julioamerico/blackfin-ip-phone-hw/implementação/doc/PCB Top Layer.jpg

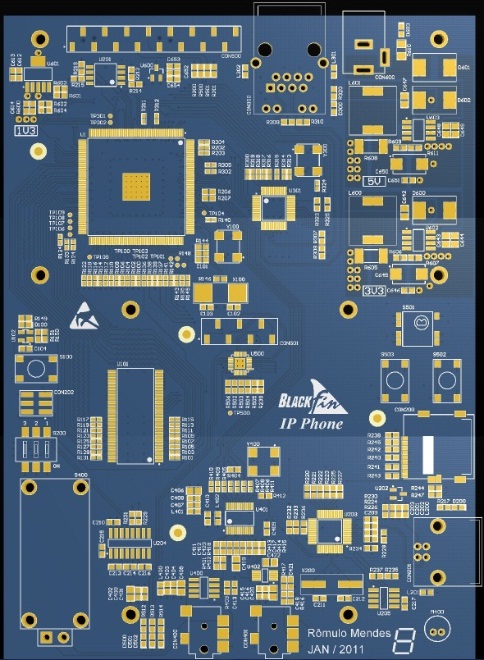
implementação/doc/PCB Top Layer.jpg
