julioamerico/blackfin-ip-phone-hw/implementação/doc/wiki/images/placa.png

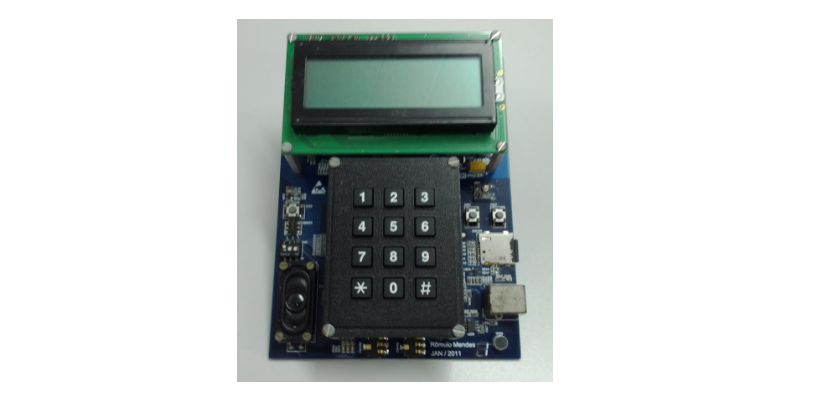
implementação/doc/wiki/images/placa.png
