julioamerico/blackfin-ip-phone-hw/pesquisa/crystals and oscillators/CSX750FBC-16.384M-UT.pdf

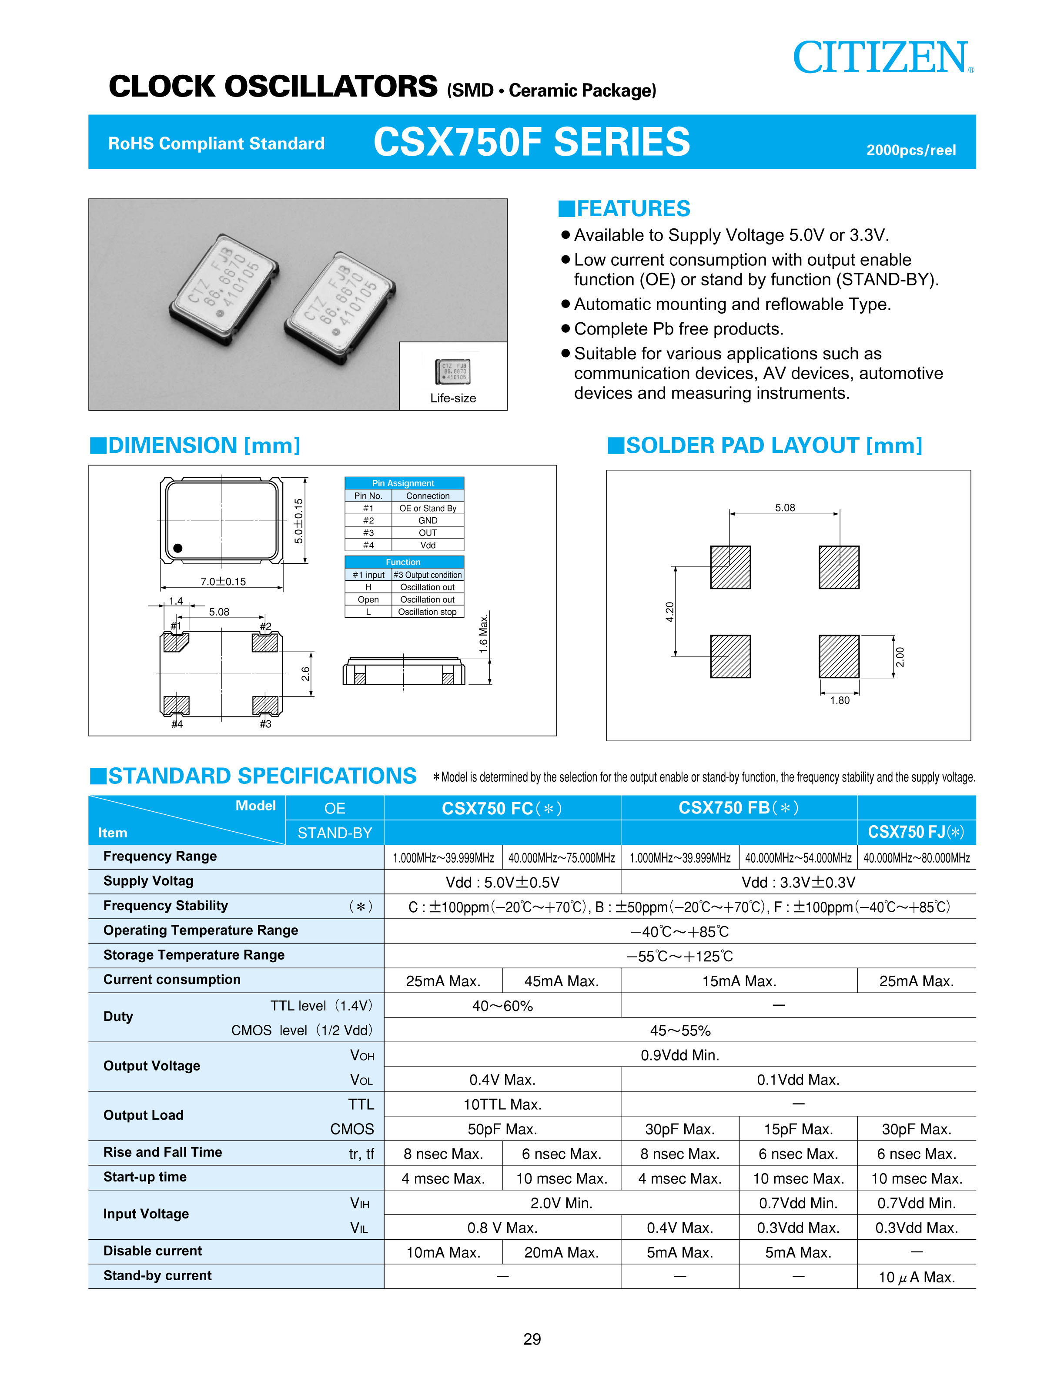
[picture p17: page 1]
