julioamerico/blackfin-ip-phone-hw/arquitetura/diagrama de blocos (texas instruments).jpg

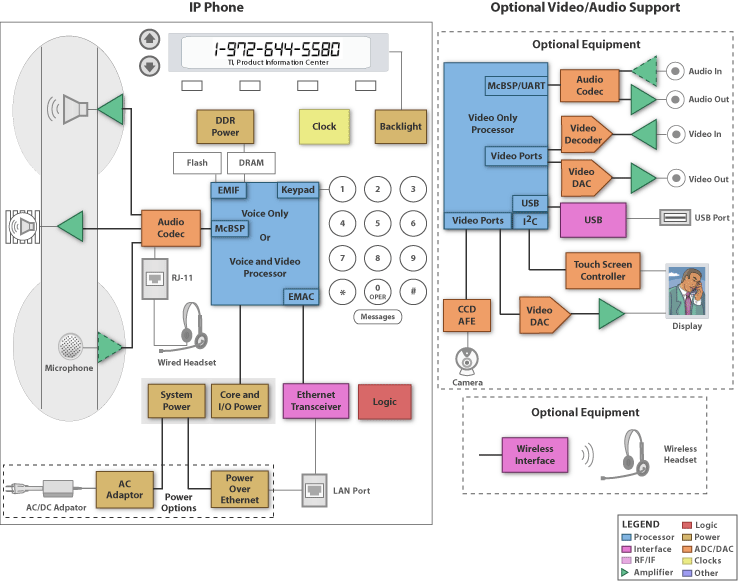
arquitetura/diagrama de blocos (texas instruments).jpg
