julioamerico/blackfin-ip-phone-hw/implementação/doc/Relatório de Fabricação das Placas/1-4 - Final Inspection Report.jpg

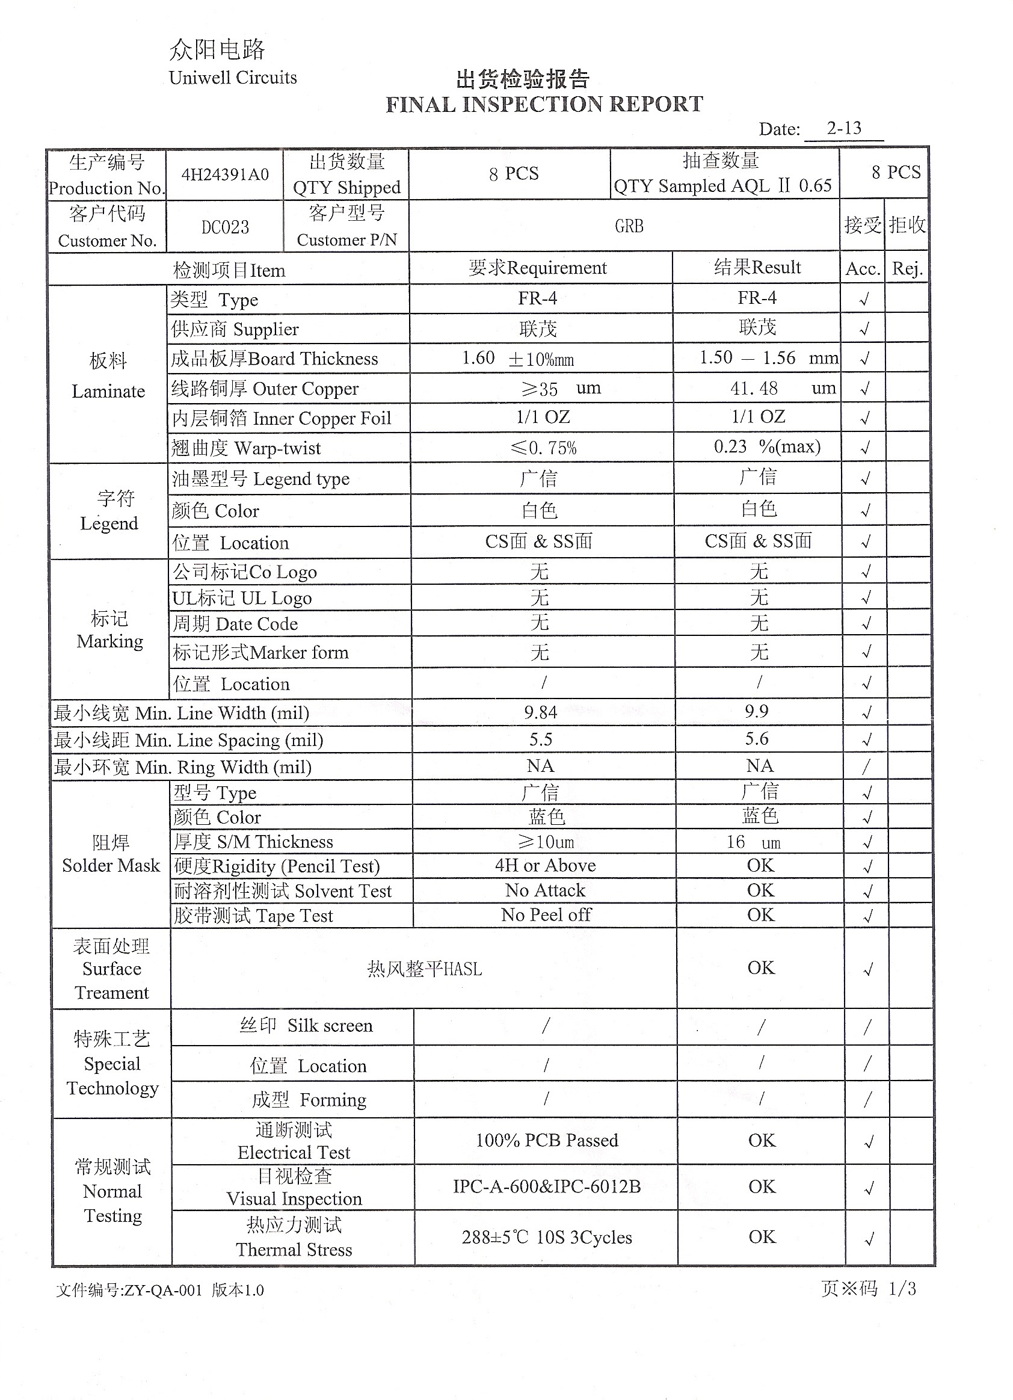
implementação/doc/Relatório de Fabricação das Placas/1-4 - Final Inspection Report.jpg
