julioamerico/blackfin-ip-phone-hw/implementação/doc/Relatório de Fabricação das Placas/4-4 - Microsection Analysis Report.jpg

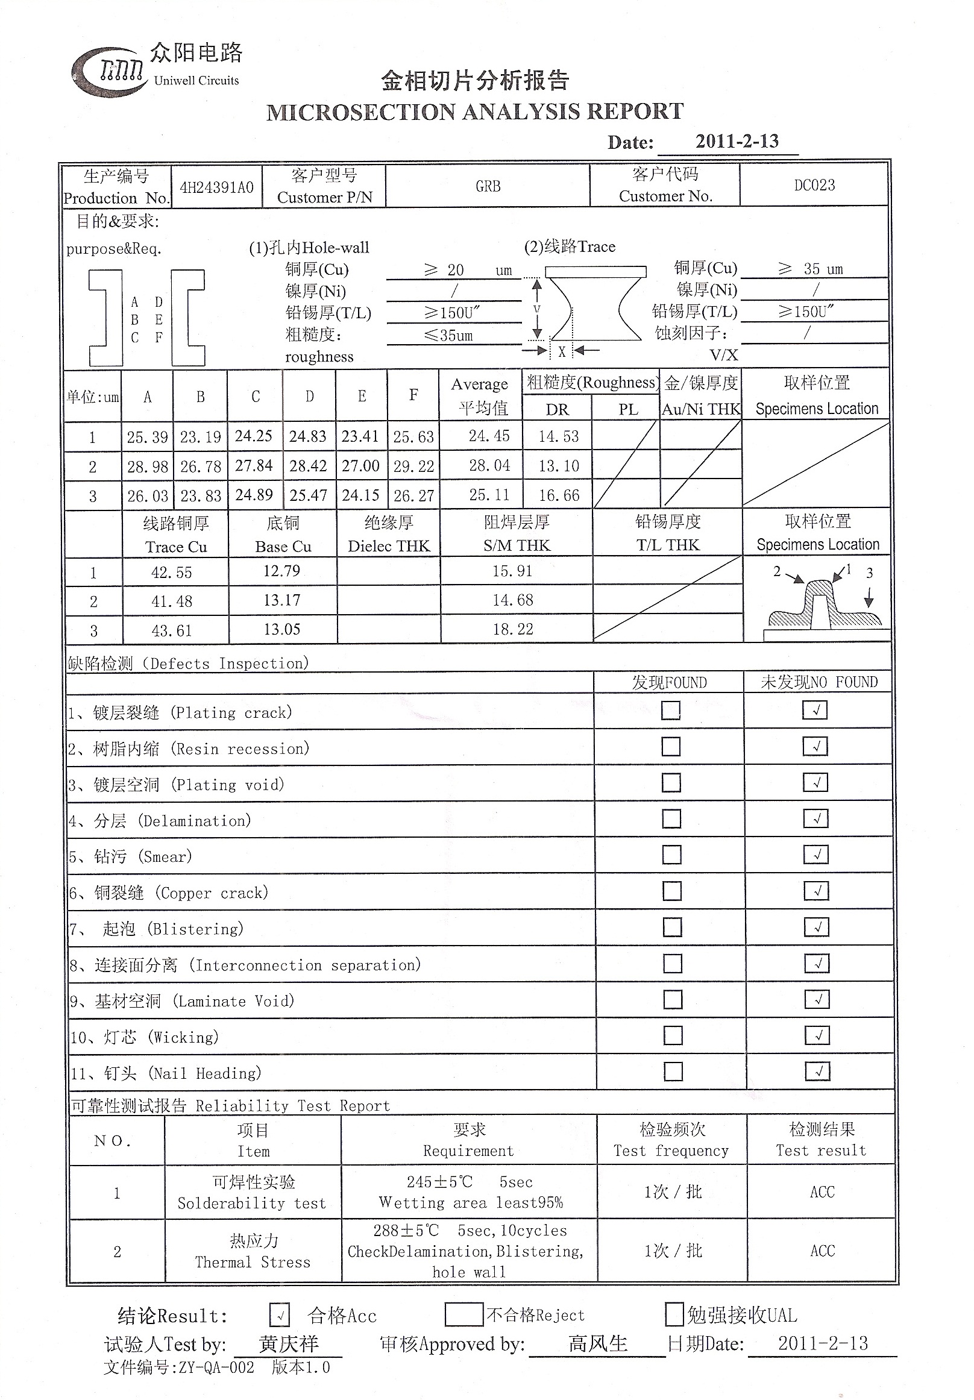
implementação/doc/Relatório de Fabricação das Placas/4-4 - Microsection Analysis Report.jpg
