julioamerico/blackfin-ip-phone-hw/implementação/doc/wiki/images/arquitetura_fw.png

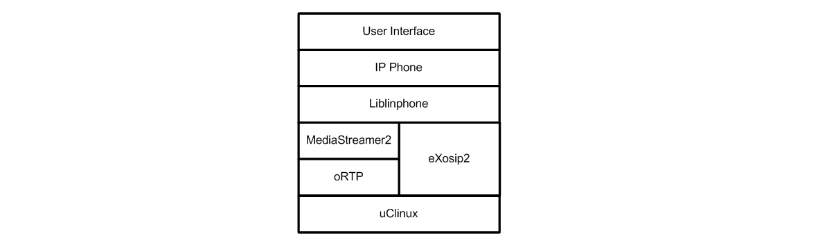
implementação/doc/wiki/images/arquitetura_fw.png
