julioamerico/blackfin-ip-phone-hw/implementação/doc/wiki/images/arquitetura_hw.png

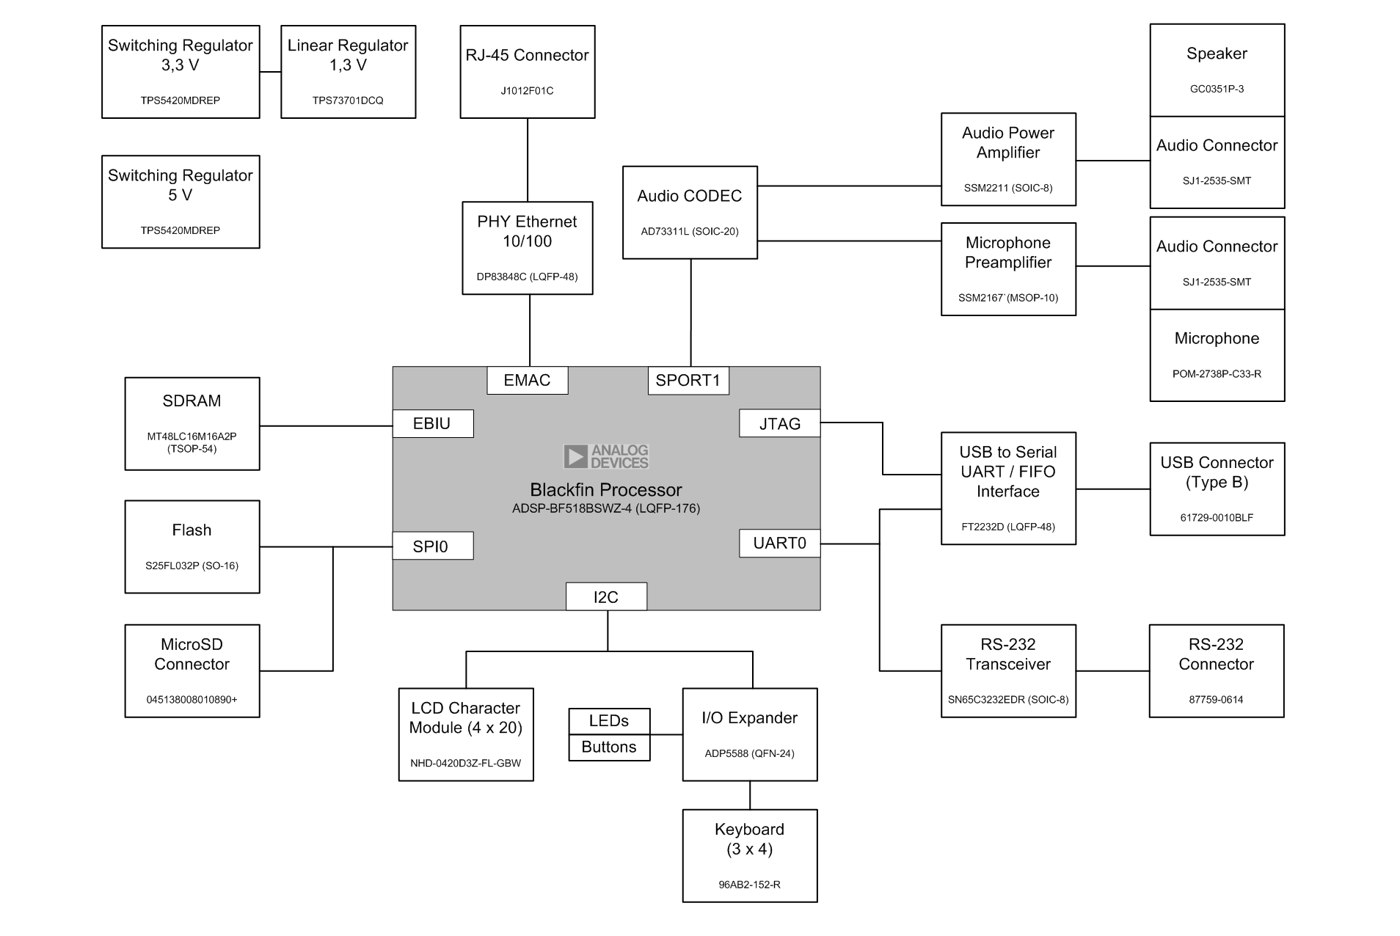
implementação/doc/wiki/images/arquitetura_hw.png
