julioamerico/blackfin-ip-phone-hw/implementação/bom/bom_fields.txt

A BOM deve conter os seguintes campos que associam o sch ao template:

- Comment       (*)
- Designator
- eVendor
- eVendorPart#
- eVendorPrice
- Footprint     (*)
- Manufacturer
- MOQ
- MSRP
- Part#         (*)
- Quantity

(*) Componentes devem ser diferenciados por esses campos.
