julioamerico/blackfin-ip-phone-hw/implementação/bom/blackfin_bom.xls

 | Lista de Materiais |  | BLACKFIN IP PHONE |  | V1
 | Universidade Federal do Ceará |  | Responsável: | Rômulo Mendes | 1 Placa ($): | 223.96
 | Centro de Tecnologia |  | Documento gerado em: | 2010-11-15 | 1000 Placas ($) | 140.29
 | Dep. de Engenharia Elétrica |  |  |  | Itens por Placa | 382
 | Dep. De Engenharia de Teleinformática
# | Part# | Comment | Footprint | Manufacturer | Designator | eVendorPart# | Quantity | MSRP | Total MSRP | eVendor | eVendorPrice | Total Vendor | MOQ
1 | PSAA18U-090-R | AC_Adapter | NÃO SE APLICA | Phihong | AC600 | 552-PSA-A18U-090 | 1 | 14,27 | 14.27 | Mouser | 17,73 | 17.73 | 1000
2 | 6009.1315 | Power_Cord | NÃO SE APLICA | Schurter | AC601 | 693-6009.1315 | 1 | 4,77 | 4.77 | Mouser | 6,74 | 6.74 | 1000
3 | NÃO SE APLICA | Board | NÃO SE APLICA | NÃO SE APLICA | B500 | NÃO SE APLICA | 1 | 0,00 | 0.00 | NÃO SE APLICA | 0,00 | 0.00 | 1000
4 | SJ-5003 (BLACK) | Board Foot | Board Foot (Hemisphere) | 3M Electronic Specialty | BF500, BF501, BF502, BF503 | 517-SJ-5003BK | 4 | 0,07 | 0.28 | Mouser | 0,18 | 0.72 | 1000
5 | VJ0603Y103KXAPW1BC | 10nF | C_0603 | Vishay/Vitramon | C100, C104, C105, C106, C107, C108, C109, C110, C111, C200, C205, C313, C414, C606, C607, C608, C609, C610, C611, C619, C620, C621, C622, C623, C624, C630, C631, C632, C633, C634, C635, C636 | 77-VJ0603Y103KXAPBC | 32 | 0,013 | 0.42 | Mouser | 0,05 | 1.60 | 1000
6 | GRM188R72A221KA01D | 220pF | C_0603 | Murata | C101 | 81-GRM18R72A221KA01D | 1 | 0,012 | 0.01 | Mouser | 0,05 | 0.05 | 1000
7 | 06035A220JAT2A | 22pF | C_0603 | AVX | C102, C103, C211, C212 | 581-06035A220J | 4 | 0,018 | 0.07 | Mouser | 0,03 | 0.12 | 1000
8 | GRM188F51E105ZA12D | 1uF | C_0603 | Murata | C201, C303, C401, C404, C409, C411, C412, C416, C612, C614, C652 | 81-GRM188F51E105ZA12 | 11 | 0,016 | 0.18 | Mouser | 0,07 | 0.77 | 1000
9 | GRM188R71E104KA01J | 100nF | C_0603 | Murata | C202, C206, C207, C208, C210, C213, C214, C215, C216, C217, C218, C301, C302, C304, C306, C307, C308, C309, C310, C311, C312, C400, C403, C407, C408, C410, C413, C415, C417, C418, C602, C603, C604, C605, C613, C617, C618, C626, C627, C628, C629, C638, C639, C640, C641, C646, C651, C653 | 81-GRM188R71E104KA01 | 48 | 0,11 | 5.28 | Mouser | 0,14 | 6.72 | 1000
10 | GRM188F51A225ZE01D | 2,2uF | C_0603 | Murata | C203, C654 | 81-GRM188F51A225ZE01 | 2 | 0,024 | 0.05 | Mouser | 0,11 | 0.22 | 1000
11 | C2012Y5V1C106Z | 10uF | C_0805 | TDK | C204, C300, C402, C405, C406, C419, C420, C422, C600, C601, C615, C616, C625, C637 | 810-C2012Y5V1C106Z | 14 | 0,05 | 0.70 | Mouser | 0,10 | 1.40 | 1000
12 | GRM188B11E333KA01D | 33nF | C_0603 | Murata | C209 | 81-GRM18B11E333KA01D | 1 | 0,013 | 0.01 | Mouser | 0,07 | 0.07 | 1000
13 | B45196H3106K109V17 | 10uF | C_Case_A | Kemet | C305 | 80-B45196H3106K109 | 1 | 0,06 | 0.06 | Mouser | 0,13 | 0.13 | 1000
14 | GRM1885C2A102JA01D | 1nF | C_0603 | Murata | C421 | 81-GRM1885C2A102JA01 | 1 | 0,019 | 0.02 | Mouser | 0,08 | 0.08 | 1000
15 | GRM188R71H473KA61D | 47nF | C_0603 | Murata | C423 | 81-GRM188R71H473KA61 | 1 | 0,012 | 0.01 | Mouser | 0,07 | 0.07 | 1000
16 | GRM216R71H103JA01D | 10nF | C_0805 | Murata | C642, C647 | 81-GRM216R71H103JA1D | 2 | 0,026 | 0.05 | Mouser | 0,23 | 0.46 | 1000
17 | C2012X5R1C106M | 10uF | C_0805 | TDK | C643, C648 | 810-C2012X5R1C106M | 2 | 0,098 | 0.20 | Mouser | 0,16 | 0.32 | 1000
18 | GRM21BR61C475KA88L | 4,7uF | C_0805 | Murata | C644, C649 | 81-GRM21BR61C475KA8L | 2 | 0,076 | 0.15 | Mouser | 0,42 | 0.84 | 1000
19 | T520Y477M006ATE015 | 470uF | C_Case_Y | Kemet | C645, C650 | 80-T520Y477M6ATE15 | 2 | 1,92 | 3.84 | Mouser | 3,27 | 6.54 | 1000
20 | 61729-0010BLF | USB Connector | USB Connector | FCI | CON201 | 649-61729-0010BLF | 1 | 0,39 | 0.39 | Mouser | 0,58 | 0.58 | 1000
21 | 87759-0614 | RS-232_CONN | Header_2x3 | Molex | CON202 | 538-87759-0614 | 1 | 0,48 | 0.48 | Mouser | 0,62 | 0.62 | 1000
22 | J1012F01C | RJ-45 | RJ-45 | Pulse | CON300 | 673-J1012F01C | 1 | 3,86 | 3.86 | Mouser | 7,86 | 7.86 | 1000
23 | SJ1-2535-SMT | Phone_Jack | Phone_Jack | CUI Inc | CON400, CON401 | CP1-2535SJCT-ND | 2 | 0,415 | 0.83 | Digikey | 0,75 | 1.50 | 1000
24 | SSM-116-L-SV | LCD_Connector | SOCKET_1x16 | Samtec | CON500 | SSM-116-L-SV | 1 | 1,29 | 1.29 | Techso | 1,55 | 1.55 | 1000
25 | SSM-107-L-SV | Keypad_Connector | SOCKET_1x7 | Samtec | CON501 | SSM-107-L-SV | 1 | 0,729 | 0.73 | Techso | 0,881 | 0.88 | 1000
26 | 163-179PH-EX | Power_Jack | Power_Jack | Kobiconn | CON600 | 163-179PH-EX | 1 | 0,51 | 0.51 | Mouser | 0,87 | 0.87 | 1000
27 | QTLP600C2TR | LED | LED_0603 | Everlight | D100, D200, D500, D501, D502, D603 | 638-QTLP600C2TR | 6 | 0,083 | 0.50 | Mouser | 0,22 | 1.32 | 1000
28 | QTLP600C4TR | LED | LED_0603 | Everlight | D300 | 638-QTLP600C4 | 1 | 0,075 | 0.07 | Mouser | 0,02 | 0.02 | 1000
29 | MBRS330T3G | MBRS330T3G | Case_430 | ON Semiconductor | D600, D602 | 863-MBRS330T3G | 2 | 0,17 | 0.34 | Mouser | 0,37 | 0.74 | 1000
30 | MBRS330T3G | Schottky_Diode | Case_430 | ON Semiconductor | D601 | 863-MBRS330T3G | 1 | 0,17 | 0.17 | Mouser | 0,37 | 0.37 | 1000
31 | ESQ-107-34-L-S | Keypad_Header_1x7 |  | Samtec | KEYPAD_HEADER500 | ESQ-107-34-L-S | 1 | 0,756 | 0.76 | Techso | 0,916 | 0.92 | 1000
32 | MI0603L301R-10 | FBEAD | L_0603 | Laird Technologies | L200, L201, L300, L301, L302, L400, L401, L402 | 875-MI0603L301R-10 | 8 | 0,066 | 0.53 | Mouser | 0,16 | 1.28 | 1000
33 | 744066220 | 22uH | Inductor_22uH | Wurth Electronics | L600, L601 | 710-744066220 | 2 | 0,95 | 1.90 | Mouser | 2,88 | 5.76 | 1000
34 | NHD-0420D3Z-FL-GBW | LCD | LCD | Newhaven | LCD500 | 763-0420D3Z-FL-GBW | 1 | 25,60 | 25.60 | Mouser | 31,75 | 31.75 | 1000
35 | DW-03-12-F-S-694 | LCD_Header_1x3 | NÃO SE APLICA | Samtec | LCD_HEADER500 | DW-03-12-F-S-694 | 1 | 0,144 | 0.14 | Techso | 0,173 | 0.17 | 1000
36 | DW-06-12-F-S-694 | LCD_Header_1x6 | NÃO SE APLICA | Samtec | LCD_HEADER501 | DW-06-12-F-S-694 | 1 | 0,287 | 0.29 | Techso | 0,347 | 0.35 | 1000
37 | DW-05-12-F-S-694 | LCD_Header_1x5 | NÃO SE APLICA | Samtec | LCD_HEADER502 | DW-05-12-F-S-694 | 1 | 0,239 | 0.24 | Techso | 0,289 | 0.29 | 1000
38 | CRCW08050000Z0EA | LCD_Resistor | NÃO SE APLICA | Vishay/Dale | LCD_RES500, LCD_RES501 | 71-CRCW0805-0-E3 | 2 | 0,008 | 0.02 | Mouser | 0,05 | 0.10 | 1000
39 | POM-2738P-C33-R | POM-2738P-C33-R | Microphone | PUI Audio | M400 | 665-POM2738PC33R | 1 | 1,13 | 1.13 | Mouser | 1,98 | 1.98 | 1000
40 | CRCW040222R0JNED | 22R | R_0402 | Vishay/Dale | R100, R101, R102, R103, R104, R105, R106, R107, R108, R109, R110, R111, R112, R113, R114, R115, R116, R117, R118, R119, R121, R122, R123, R124, R125, R127, R129, R131, R133, R134, R135, R136, R137, R138, R139, R141, R142, R143, R145, R405, R406, R407, R408, R409, R410 | 71-CRCW0402J-22-E3 | 45 | 0,01 | 0.45 | Mouser | 0,06 | 2.70 | 1000
41 | CRCW040233R0JNED | 33R | R_0402 | Vishay/Dale | R140, R202, R203, R324, R411 | 71-CRCW0402J-33-E3 | 5 | 0,01 | 0.05 | Mouser | 0,06 | 0.30 | 1000
42 | CRCW0603100KJNEA | 100K | R_0603 | Vishay/Dale | R144, R151, R418 | 71-CRCW0603J-100K-E3 | 3 | 0,01 | 0.03 | Mouser | 0,06 | 0.18 | 1000
43 | CR0603-FX-1005ELF | 10M | R_0603 | Bourns | R146 | 652-CR0603FX-1005ELF | 1 | 0,004 | 0.004 | Mouser | 0,05 | 0.05 | 1000
44 | CRCW060310K0FKEA | 10K | R_0603 | Vishay/Dale | R147, R150, R211, R212, R213, R214, R215, R219, R230, R235, R236, R238, R328, R413, R417, R507, R508, R509, R510, R511, R515, R516, R606, R609 | 71-CRCW0603-10K-E3 | 24 | 0,015 | 0.36 | Mouser | 0,06 | 1.44 | 1000
45 | CRCW060333K0JNEA | 33K | R_0603 | Vishay/Dale | R148 | 71-CRCW0603J-33K-E3 | 1 | 0,01 | 0.01 | Mouser | 0,06 | 0.06 | 1000
46 | CRCW0603100RFKEA | 100R | R_0603 | Vishay/Dale | R149, R512, R513, R514 | 71-CRCW0603-100-E3 | 4 | 0,015 | 0.06 | Mouser | 0,06 | 0.24 | 1000
47 | CRCW06031K20FKEA | 1K2 | R_0603 | Vishay/Dale | R200, R201 | 71-CRCW0603-1.2K-E3 | 2 | 0,015 | 0.03 | Mouser | 0,06 | 0.12 | 1000
48 | CRCW06030000Z0EB | 0R | R_0603 | Vishay/Dale | R206, R220, R221, R222, R223, R225, R227, R229, R231, R232, R233, R234, R323, R325, R326, R327, R404, R412, R500, R501, R502, R503, R504, R505, R506, R600, R601, R603 | 71-CRCW06030000Z0EB | 28 | 0,015 | 0.42 | Mouser | 0,06 | 1.68 | 1000
49 | CRCW06034K70JNEA | 4K7 | R_0603 | Vishay/Dale | R207, R208, R209, R210, R239 | 71-CRCW0603J-4.7K-E3 | 5 | 0,01 | 0.05 | Mouser | 0,06 | 0.30 | 1000
50 | CRCW0603470RFKEA | 470R | R_0603 | Vishay/Dale | R216 | 71-CRCW0603-470-E3 | 1 | 0,015 | 0.01 | Mouser | 0,06 | 0.06 | 1000
51 | CRCW0603150RJNEB | 150R | R_0603 | Vishay/Dale | R217 | 71-CRCW0603150RJNEB | 1 | 0,01 | 0.01 | Mouser | 0,06 | 0.06 | 1000
52 | CRCW060327R0FKEA | 27R | R_0603 | Vishay/Dale | R224, R226 | 71-CRCW0603-27-E3 | 2 | 0,015 | 0.03 | Mouser | 0,06 | 0.12 | 1000
53 | CRCW06031K50FKEA | 1K5 | R_0603 | Vishay/Dale | R228 | 71-CRCW0603-1.5K-E3 | 1 | 0,015 | 0.01 | Mouser | 0,06 | 0.06 | 1000
54 | CRCW06032K20JNEB | 2K2 | R_0603 | Vishay/Dale | R237, R301, R303, R416 | 71-CRCW06032K20JNEB | 4 | 0,01 | 0.04 | Mouser | 0,06 | 0.24 | 1000
55 | CRCW040249R9FKED | 50R | R_0402 | Vishay/Dale | R300, R302, R304, R305, R311, R312, R313, R314, R315, R316, R317, R318, R319 | 71-CRCW0402-49.9-E3 | 13 | 0,015 | 0.20 | Mouser | 0,07 | 0.91 | 1000
56 | CRCW06034K87FKEA | 4K87 | R_0603 | Vishay/Dale | R306 | 71-CRCW0603-4.87K-E3 | 1 | 0,015 | 0.01 | Mouser | 0,06 | 0.06 | 1000
57 | CRCW060349R9FKEB | 49R9 | R_0603 | Vishay/Dale | R307, R308, R309, R310 | 71-CRCW060349R9FKEB | 4 | 0,015 | 0.06 | Mouser | 0,06 | 0.24 | 1000
58 | CRCW0603130RFKEA | 130R | R_0603 | Vishay/Dale | R320 | 71-CRCW0603-130-E3 | 1 | 0,015 | 0.01 | Mouser | 0,06 | 0.06 | 1000
59 | CRCW0603270RFKEA | 270R | R_0603 | Vishay/Dale | R321, R322 | 71-CRCW0603-270-E3 | 2 | 0,015 | 0.03 | Mouser | 0,06 | 0.12 | 1000
60 | CRCW060320K0JNEA | 20K | R_0603 | Vishay/Dale | R400, R401, R402, R403, R602 | 71-CRCW0603J-20K-E3 | 5 | 0,01 | 0.05 | Mouser | 0,06 | 0.30 | 1000
61 | CRCW060315K0JNEA | 15K | R_0603 | Vishay/Dale | R414 | 71-CRCW0603J-15K-E3 | 1 | 0,01 | 0.01 | Mouser | 0,06 | 0.06 | 1000
62 | CRCW06031K00JNEB | 1K | R_0603 | Vishay/Dale | R415 | 71-CRCW06031K00JNEB | 1 | 0,01 | 0.01 | Mouser | 0,06 | 0.06 | 1000
63 | CRCW0603255KFKEA | 255K | R_0603 | Vishay/Dale | R604 | 71-CRCW0603-255K-E3 | 1 | 0,015 | 0.01 | Mouser | 0,06 | 0.06 | 1000
64 | CRCW25120000Z0EG | 0R | R_2512 | Vishay/Dale | R605, R608 | 71-CRCW2512-0-E3 | 2 | 0,05 | 0.10 | Mouser | 0,14 | 0.28 | 1000
65 | RK73H1JTTDD5761F | 5K76 | R_0603 | KOA Speer | R607 | 660-RK73H1JTTDD5761F | 1 | 0,015 | 0.01 | Mouser | 0,08 | 0.08 | 1000
66 | CRCW1206390RJNEB | 400R | R_1206 | Vishay/Dale | R610 | 71-CRCW1206390RJNEB | 1 | 0,02 | 0.02 | Mouser | 0,10 | 0.10 | 1000
67 | CRCW06033K24FKEA | 3K24 | R_0603 | Vishay/Dale | R611 | 71-CRCW0603-3.24K-E3 | 1 | 0,015 | 0.01 | Mouser | 0,06 | 0.06 | 1000
68 | PTS645SH50SMTRLFS | Push Button | Push Button | C&K Components | S100, S502, S503 | 611-PTS645SH50SMTRLF | 3 | 0,135 | 0.41 | Mouser | 0,27 | 0.81 | 1000
69 | SDA03H1SBD | DIP Switch | DIP Switch | C&K Components | S200 | 611-SDA03H1SBD | 1 | 0,73 | 0.73 | Mouser | 1,21 | 1.21 | 1000
70 | GC0351P-3 | GC0351P | Speaker | CUI Inc | S400 | GC0351P-3-ND | 1 | 2,65267 | 2.65 | Digikey | 4,98 | 4.98 | 1000
71 | 96AB2-152-R | Keypad | Keypad | Grayhill Inc | S500 | GH5009-ND | 1 | 6,6228 | 6.62 | Digikey | 12,26 | 12.26 | 1000
72 | TPA511GLFS | TPA511GLFS | TPA511GLFS | C&K Components | S501 | 611-TPA511GLFS | 1 | 0,91 | 0.91 | Mouser | 1,52 | 1.52 | 1000
73 | 29301 | Screw | NÃO SE APLICA | Keystone Electronics | SCREW500, SCREW501, SCREW502, SCREW503, SCREW504, SCREW505, SCREW506, SCREW507, SCREW508, SCREW509, SCREW510, SCREW511, SCREW512, SCREW513, SCREW514, SCREW515 | 534-29301 | 16 | 0,14 | 2.24 | Mouser | 0,28 | 4.48 | 1000
74 | 24428 | Spacer | NÃO SE APLICA | Keystone Electronics | SPACER500, SPACER501, SPACER502, SPACER503, SPACER504, SPACER505, SPACER506, SPACER507 | 534-24428 | 8 | 0,30 | 2.40 | Mouser | 0,60 | 4.80 | 1000
75 | ADSP-BF518BSWZ-4 | ADSP-BF518 | LQFP-176 | Analog Devices | U1 | ADSP-BF518BSWZ-4 | 1 | 13,07 | 13.07 | Analog Devices | 13,76 | 13.76 | 1000
76 | MT48LC16M16A2P-75:D TR | MT48LC16M16A2P | TSOP-54 | Micron | U101 | 557-1059-1-ND | 1 | 6,6825 | 6.68 | Digikey | 10,73 | 10.73 | 1000
77 | CAT811STBI-GT3 | CAT811S | SOT-143 | ON Semiconductor | U102 | 698-CAT811STBI-GT3 | 1 | 0,156 | 0.16 | Mouser | 0,22 | 0.22 | 1000
78 | S25FL032P0XMFI010 | S25FL032P | SO-8 | Spansion | U201 | S25FL032P0XMFI010 | 1 | 1,61 | 1.61 | Avnet | 1,63 | 1.63 | 1000
79 | AME8800AEETZ | AME8800AEETZ | SOT-23 | AME | U202 | 827-AME8800AEETZ | 1 | 0,171 | 0.17 | Mouser | 0,67 | 0.67 | 1000
80 | FT2232D | FT2232D | LQFP-48 | FTDI | U203 | 895-FT2232D | 1 | 3,80 | 3.80 | Mouser | 6,99 | 6.99 | 1000
81 | SN65C3232EDR | SN65C3232EDR | SOIC-16 | Texas Instruments | U204 | 595-SN65C3232EDR | 1 | 0,932 | 0.93 | Mouser | 1,41 | 1.41 | 1000
82 | AT93C56A-10SU-2.7 | AT93C56A | SOIC-8 (AT93C56A) | Atmel | U205 | 556-A93C56A10SU2.7 | 1 | 0,24 | 0.24 | Mouser | 0,42 | 0.42 | 1000
83 | 045138008010890+ | MicroSD | MICRO_SD | AVX Corporation | U206 | 478-4965-1-ND | 1 | 2,394 | 2.39 | Digikey | 3,86 | 3.86 | 1000
84 | DP83848CVV/NOPB | DP83848C | LQFP-48 | National Semiconductor | U301 | DP83848CVV-ND | 1 | 3,672 | 3.67 | Digikey | 6,8 | 6.80 | 1000
85 | SSM2211SZ | SSM2211 | SOIC-8 (SSM2211) | Analog Devices | U400 | SSM2211SZ-ND | 1 | 0,574 | 0.57 | Digikey | 1,23 | 1.23 | 1000
86 | AD73311LARUZ | AD73311L | TSSOP-20 | Analog Devices | U401 | AD73311LARUZ | 1 | 3,41 | 3.41 | Avnet | 3,60 | 3.60 | 1000
87 | SSM2167-1RMZ-REEL | SSM2167 | MSOP-10 | Analog Devices | U402 | SSM2167-1RMZ-REELCT-ND | 1 | 1,352 | 1.35 | Digikey | 2,34 | 2.34 | 1000
88 | ADP5588ACPZ-R7 | ADP5588 | QFN-24 | Analog Devices | U500 | ADP5588ACPZ-R7CT-ND | 1 | 1,56 | 1.56 | Digikey | 2,70 | 2.70 | 1000
89 | AME8800DEETZ | AME8800DEETZ | SOT-23 | AME | U600 | 827-AME8800DEETZ | 1 | 0,171 | 0.17 | Mouser | 0,67 | 0.67 | 1000
90 | TPS73701DCQ | TPS73701DCQ | SOT-223 | Texas Instruments | U601 | 595-TPS73701DCQ | 1 | 0,845 | 0.84 | Mouser | 1,62 | 1.62 | 1000
91 | TPS5420MDREP | TPS5420MDREP | SOIC-8 (TPS5420MDREP) | Texas Instruments | U602, U603 | 595-TPS5420MDREP | 2 | 3,61 | 7.22 | Mouser | 5,78 | 11.56 | 1000
92 | MC-405 | 32.768KHz | XTAL_32.768kHz | Epson | X100 | SER2405CT-ND | 1 | 0,54 | 0.54 | Digikey | 0,95 | 0.95 | 1000
93 | ATS060SM-1 | 6MHz | XTAL_6MHz | CTS Electronic Components | X200 | 774-ATS060SM-1 | 1 | 0,23 | 0.23 | Mouser | 0,49 | 0.49 | 1000
94 | ASV-25.000MHZ-EJ-T | 25MHz | OSC_25MHz | ABRACON | Y100, Y300 | 815-ASV-25-EJ-T | 2 | 1,12 | 2.24 | Mouser | 2,89 | 5.78 | 1000
95 | CSX750FBC-16.384M-UT | 16.384MHz | OSC_16.384MHz | Citizen | Y400 | 695-CSX750FBC-163 | 1 | 1,20 | 1.20 | Mouser | 2,98 | 2.98 | 1000
