julioamerico/blackfin-ip-phone-hw/pesquisa/phy ethernet/DP83848J-K Board/national_dp83848jandk_bom.xlsx

980012986-100B
DP83848J/K PHYTER Mini LS MAU Demo - Trike III - Block Diagram Revised: Monday, August 21, 2006
870012986-100 Revision: B
Bill Of Materials August 21,2006 16:40:46
Item | Quantity | Reference | Part | PCB Footprint | Comments
1 | 2 | C3,C4 | 18PF | SMD0603-A1
2 | 7 | C12,C13,C14,C22,C25,C26,C24 | 0.1uF | SMD0603-A1 | 10V rating
3 | 3 | C15,C16,C19 | 10uF | SMD0805-A1 | 10V rating
4 | 1 | C21 | 1500pF | SMD1808-A1
5 | 1 | C23 | 1uF | SMD0805-A1 | 10V rating
6 | 1 | J1 | CON-MII-MALE, AMP/TYCO 173278-2
7 | 1 | J10 | HDR-1X1 | CN-HDR1X1
8 | 1 | J13 | PulseJack J0011D21B | J0 Series Mechanicals
9 | 1 | J15 | HDR1X3
10 | 1 | L2 | 200nH - BLM21AG121SN1 | SMD0805-A1
 |  |  | See http://www.murata.com/catalog/c31e.pdf
11 | 1 | R1 | 1.5K | SMD0402-A1
12 | 10 | R2,R3,R4,R5,R6,R7,R8,R9, | 47 | SMD0402-A1
 |  | R15,R16
13 | 5 | R10,R11,R12,R13,R14 | 33 | SMD0402-A1
14 | 1 | R23 | NO LOAD | SMD0402-A1
15 | 1 | R24 | 4.87K | SMD0402-A1 | 1% tolerance
16 | 4 | R25,R26,R27,R28 | 49.9 | SMD0603-A1
17 | 3 | R29,R30,R31 | 2.2K | SMD0402-A1 | Do not populate
18 | 1 | R32 | 0 | SMD0805-A1
19 | 2 | R33,R34 | 0 | SMD0402-A1
20 | 2 | R38,R42 | 274 | SMD0402-A1
21 | 1 | U1 | DP83848J | SQA40b
22 | 1 | Y1 | ECLIPTEK ECCM1 XTAL - 25M | SMD
 | 51
