julioamerico/blackfin-ip-phone-hw/pesquisa/audio codec/CODEC Selection Guide (Analog Devices).xls

 | # ADC | # DAC | ADC Dynamic Range (dB) | DAC Dynamic Range (dB) | ADC SNR (dB) | DAC SNR (dB) | Product Description | Price* (1000 pcs.)
AD1836A | 4 | 6 | 105 | 108 | 105 | 108 | 4 ADC, 6 DAC, 24-Bit, 96 kHz, Multibit Sigma-Delta CODEC | $7.68
AD1936 | 4 | 8 | 107 | 106 | 107 | 106 | 192 kHz, 24-Bit CODEC with PLL, Single-Ended Output, I2C Control | **
AD1937 | 4 | 8 | 107 | 109 | 107 | 109 | 192 kHz, 24-Bit CODEC with PLL, Differential Output, I2C Control | $7.63
AD1938 | 4 | 8 | 107 | 108 | 107 | 108 | 192 kHz 24-bit CODEC w/ PLL | $7.14
AD1939 | 4 | 8 | 107 | 112 | 107 | - | High Performance Multibit Sigma Delta CODEC. | $7.72
SSM2602 | 2 | 2 | - | - | 90 | 100 | Low Pwr, 192 kHz, 24-Bit CODEC w/ mic Bias, I2C and SPI Interface | **
AD73322 | 2 | 2 | - | - | 78 | 77 | Dual-Channel, 3 V Front-End Processor for General Purpose Apps Including Speech and Telephony | **
AD73322L | 2 | 2 | - | - | 78 | 78 | Dual-Channel, 3 V Front-End Processor for General Purpose Apps Including Speech and Telephony | $4.86
ADAU1361 | 2 | 2 | 99 | 101 | 99 | 101 | Stereo, Low Power, 96 kHz, 24-Bit Audio Codec with Integrated PLL | $2.88
ADAV803 | 2 | 2 | 102 | 101 | 102 | 101 | Audio Codec for Recordable DVD | $8.29
ADAV801 | 2 | 2 | 102 | 101 | 102 | 101 | Audio Codec for Recordable DVD | $6.74
AD1839A | 2 | 6 | 105 | 108 | 105 | 108 | 96 kHz, 24-bit Sigma-Delta CODEC | **
AD1838A | 2 | 6 | 105 | 108 | 105 | 108 | 96 kHz, 24-bit Sigma-Delta CODEC | $8.80
AD1837A | 2 | 8 | 105 | 108 | 105 | 108 | 96 kHz, 24-bit Sigma-Delta CODEC | **
AD1835A | 2 | 8 | 105 | 108 | 105 | 108 | 96 kHz, 24-bit Sigma Delta CODEC | $9.15
AD73311L | 1 | 1 | - | - | 76 | 77 | Single-Channel, 3 V and 5 V Front-End Processor for Gen Purp Apps Including Speech and Telephony | $2.69
AD73311 | 1 | 1 | - | - | 75 | 70 | Single-Channel, 3 V and 5 V Front-End Processor for Gen Purp Apps Including Speech and Telephony | $4.17
AD74111 | 1 | 1 | 85 | 93 | 77 | 89 | Low Cost Mono Audio Codec | $2.69
