julioamerico/blackfin-ip-phone-hw/compras/01-07-2010/Planilha.xls

eVendorPart# | eVendorPrice | Quantity | $/Part | Customer Part | Customer | $ (componentes) | $ (imposto de venda) | $ (frete interno USA) | $ (frete USA - BR) | $ (comissão DEBBIE) | $ (tarifa sobre compras no exterior) | TOTAL EM REAIS
P130GCT-ND | 0.071 | 30 | 2.130 | ROMULO | ROMULO | 114.07 | 6.84 | 2.59 | 18.60 | 6.00 | 4.11 | 273.99
GH5009-ND | 12.260 | 2 | 24.520 | ROMULO | MARC. LIMA | 273.54 | 16.41 | 2.59 | 18.60 | 6.00 | 4.11 | 578.25
ADP5588ACPZ-R7CT-ND | 2.700 | 5 | 13.500 | ROMULO | MARC. SOUZA | 50.60 | 3.04 | 2.59 | 18.60 | 6.00 | 4.11 | 152.88
DP83848CVV-ND | 6.800 | 4 | 27.200 | ROMULO | MARCOS CUNHA | 118.15 | 7.09 | 2.59 | 18.60 | 6.00 | 4.11 | 281.77
557-1059-1-ND | 10.730 | 4 | 42.920 | ROMULO | MARCUS VINIC. | 207.34 | 12.44 | 2.59 | 18.60 | 6.00 | 4.11 | 451.93
SER2405CT-ND | 0.950 | 4 | 3.800 | ROMULO
REF02HSZ-ND | 4.190 | 5 | 20.950 | MARC. LIMA
296-17958-1-ND | 3.010 | 6 | 18.060 | MARC. LIMA
DF06M-ND | 0.331 | 25 | 8.270 | MARC. LIMA | TOTAL (COMPONENTES) | 763.69
MAX489CPD+-ND | 2.810 | 5 | 14.050 | MARC. LIMA | TOTAL (IMPOSTO DE VENDA) | 45.82
768-1007-1-ND | 4.050 | 10 | 40.500 | MARC. LIMA | TOTAL (FRETE INTERNO USA) | 12.94
609-1039-ND | 1.120 | 10 | 11.200 | MARC. LIMA | TOTAL (FRETE USA - BR) | 93.00
A26530-40-ND | 2.510 | 4 | 10.040 | MARC. LIMA | TOTAL (COMISSÃO DEBBIE) | 30.00
ADC122S625CIMMCT-ND | 6.810 | 2 | 13.620 | MARC. LIMA | TOTAL (TARIFA SOBRE COMPRAS NO EXTERIOR) | 20.56
296-10291-5-ND | 16.610 | 1 | 16.610 | MARC. LIMA | CONVERSÃO (R$/$) | 1.80
ADC141S626CIMMCT-ND | 9.570 | 2 | 19.140 | MARC. LIMA
AT90CAN32-16AU-ND | 10.110 | 10 | 101.100 | MARC. LIMA
768-1007-1-ND | 4.050 | 10 | 40.500 | MARC. SOUZA
609-3657-ND | 1.010 | 10 | 10.100 | MARC. SOUZA
490-1695-1-ND | 0.111 | 20 | 2.220 | MARCOS CUNHA
490-3346-1-ND | 0.160 | 10 | 1.600 | MARCOS CUNHA
445-1368-1-ND | 0.105 | 10 | 1.050 | MARCOS CUNHA
399-1108-1-ND | 0.138 | 15 | 2.070 | MARCOS CUNHA
478-3735-1-ND | 0.231 | 20 | 4.620 | MARCOS CUNHA
478-3745-1-ND | 0.319 | 10 | 3.190 | MARCOS CUNHA
399-1121-1-ND | 0.113 | 10 | 1.130 | MARCOS CUNHA
399-3491-1-ND | 0.286 | 5 | 1.430 | MARCOS CUNHA
399-1134-1-ND | 0.292 | 5 | 1.460 | MARCOS CUNHA
478-3352-1-ND | 0.044 | 20 | 0.880 | MARCOS CUNHA
399-1147-1-ND | 0.078 | 10 | 0.780 | MARCOS CUNHA
490-1660-1-ND | 0.076 | 10 | 0.760 | MARCOS CUNHA
RHM470ARCT-ND | 0.034 | 20 | 0.680 | MARCOS CUNHA
P27ACT-ND | 0.041 | 50 | 2.070 | MARCOS CUNHA
RHM10KARCT-ND | 0.024 | 50 | 1.190 | MARCOS CUNHA
RHM2.2ARCT-ND | 0.024 | 50 | 1.190 | MARCOS CUNHA
RHM68ARCT-ND | 0.034 | 10 | 0.340 | MARCOS CUNHA
RHM27ARCT-ND | 0.034 | 10 | 0.340 | MARCOS CUNHA
RHM82ARCT-ND | 0.034 | 10 | 0.340 | MARCOS CUNHA
RHM12ARCT-ND | 0.024 | 60 | 1.428 | MARCOS CUNHA
RHM3.3MARCT-ND | 0.034 | 10 | 0.340 | MARCOS CUNHA
RHM200KARCT-ND | 0.034 | 10 | 0.340 | MARCOS CUNHA
RHM1.0KARCT-ND | 0.024 | 50 | 1.190 | MARCOS CUNHA
RHM100KARCT-ND | 0.034 | 10 | 0.340 | MARCOS CUNHA
490-2881-ND | 0.920 | 4 | 3.680 | MARCOS CUNHA
P49.9HCT-ND | 0.039 | 50 | 1.960 | MARCOS CUNHA
P330ACT-ND | 0.077 | 10 | 0.770 | MARCOS CUNHA
445-3200-1-ND | 0.810 | 4 | 3.240 | MARCOS CUNHA
P606-ND | 0.187 | 10 | 1.870 | MARCOS CUNHA
P607-ND | 0.215 | 10 | 2.150 | MARCOS CUNHA
P608-ND | 0.224 | 10 | 2.240 | MARCOS CUNHA
ED1934-ND | 0.554 | 18 | 9.972 | MARCOS CUNHA
ED1960-ND | 1.276 | 18 | 22.968 | MARCOS CUNHA
A26530-40-ND | 2.510 | 2 | 5.020 | MARCOS CUNHA
S7120-ND | 2.560 | 1 | 2.560 | MARCOS CUNHA
S7116-ND | 2.070 | 1 | 2.070 | MARCOS CUNHA
BC847A-TPCT-ND | 0.225 | 25 | 5.625 | MARCOS CUNHA
BC857A-7-FDICT-ND | 0.299 | 25 | 7.475 | MARCOS CUNHA
450-1661-ND | 0.334 | 15 | 5.010 | MARCOS CUNHA
REF3012AIDBZTCT-ND | 2.280 | 3 | 6.840 | MARCOS CUNHA
631-1010-1-ND | 0.620 | 3 | 1.860 | MARCOS CUNHA
631-1008-1-ND | 0.620 | 3 | 1.860 | MARCOS CUNHA
A98036-ND | 0.293 | 10 | 2.930 | MARCUS VINIC.
450-1417-ND | 1.440 | 4 | 5.760 | MARCUS VINIC.
490-4612-1-ND | 0.085 | 30 | 2.550 | MARCUS VINIC.
900-00005-ND | 12.990 | 1 | 12.990 | MARCUS VINIC.
2N6071BGOS-ND | 0.570 | 5 | 2.850 | MARCUS VINIC.
568-3659-5-ND | 0.880 | 5 | 4.400 | MARCUS VINIC.
MAC08BT1GOSCT-ND | 0.560 | 4 | 2.240 | MARCUS VINIC.
568-3664-ND | 0.990 | 2 | 1.980 | MARCUS VINIC.
568-1780-1-ND | 2.750 | 2 | 5.500 | MARCUS VINIC.
MOC3020MFS-ND | 0.635 | 15 | 9.525 | MARCUS VINIC.
DF04SCT-ND | 0.530 | 5 | 2.650 | MARCUS VINIC.
DF06M-ND | 0.450 | 5 | 2.250 | MARCUS VINIC.
478-5017-1-ND | 0.088 | 30 | 2.640 | MARCUS VINIC.
490-2882-ND | 0.920 | 2 | 1.840 | MARCUS VINIC.
A26530-40-ND | 2.510 | 1 | 2.510 | MARCUS VINIC.
PIC12F510-I/P-ND | 0.770 | 10 | 7.700 | MARCUS VINIC.
PIC16F628A-I/P-ND | 2.680 | 2 | 5.360 | MARCUS VINIC.
PIC18F13K50-I/P-ND | 2.800 | 1 | 2.800 | MARCUS VINIC.
PIC16F877A-I/P-ND | 6.720 | 1 | 6.720 | MARCUS VINIC.
CTX416-ND | 0.642 | 10 | 6.420 | MARCUS VINIC.
P13484CT-ND | 0.288 | 100 | 28.850 | MARCUS VINIC.
ATMEGA168-20PU-ND | 4.320 | 1 | 4.320 | MARCUS VINIC.
568-3251-ND | 0.870 | 1 | 0.870 | MARCUS VINIC.
LM35DZ-ND | 1.710 | 1 | 1.710 | MARCUS VINIC.
MAX489CPD+-ND | 2.810 | 2 | 5.620 | MARCUS VINIC.
160-1575-5-ND | 0.528 | 10 | 5.280 | MARCUS VINIC.
AE10332-ND | 1.240 | 1 | 1.240 | MARCUS VINIC.
620-1262-1-ND | 4.660 | 1 | 4.660 | MARCUS VINIC.
296-27330-1-ND | 1.930 | 1 | 1.930 | MARCUS VINIC.
4N26SR2MCT-ND | 0.760 | 2 | 1.520 | MARCUS VINIC.
445-2525-1-ND | 0.357 | 10 | 3.570 | MARCUS VINIC.
497-7186-5-ND | 1.540 | 2 | 3.080 | MARCUS VINIC.
DS1307+-ND | 3.740 | 2 | 7.480 | MARCUS VINIC.
768-1007-1-ND | 4.500 | 1 | 4.500 | MARCUS VINIC.
ISD1740SY-ND | 7.270 | 1 | 7.270 | MARCUS VINIC.
LM317TFS-ND | 0.650 | 2 | 1.300 | MARCUS VINIC.
751-1002-ND | 0.990 | 2 | 1.980 | MARCUS VINIC.
751-1388-ND | 0.910 | 2 | 1.820 | MARCUS VINIC.
LM567CN-ND | 1.670 | 2 | 3.340 | MARCUS VINIC.
ULN2803APG-ND | 0.720 | 1 | 0.720 | MARCUS VINIC.
ENC28J60-I/SO-ND | 3.600 | 2 | 7.200 | MARCUS VINIC.
P2.32KHCT-ND | 0.073 | 10 | 0.730 | MARCUS VINIC.
P49.9KHCT-ND | 0.073 | 10 | 0.730 | MARCUS VINIC.
P75GCT-ND | 0.071 | 10 | 0.710 | MARCUS VINIC.
478-4600-1-ND | 0.750 | 2 | 1.500 | MARCUS VINIC.
AT93C56A-10PU-2.7-ND | 0.400 | 4 | 1.600 | MARCUS VINIC.
LNA2802L-ND | 0.361 | 10 | 3.610 | MARCUS VINIC.
553-1480-ND | 4.290 | 2 | 8.580 | MARCUS VINIC.
