julioamerico/blackfin-ip-phone-hw/(list of files, cad)

Other CAD files:
pesquisa/processor/ADSP_BF518F_EZ_Board_Design_Reference_Info(1_0)/assembly/ASSYDWGBOT.dwg
pesquisa/processor/ADSP_BF518F_EZ_Board_Design_Reference_Info(1_0)/assembly/ASSYDWGTOP.dwg
