julioamerico/blackfin-ip-phone-hw/implementação/doc/Relatório de Fabricação das Placas/3-4 - E-Test Report.jpg

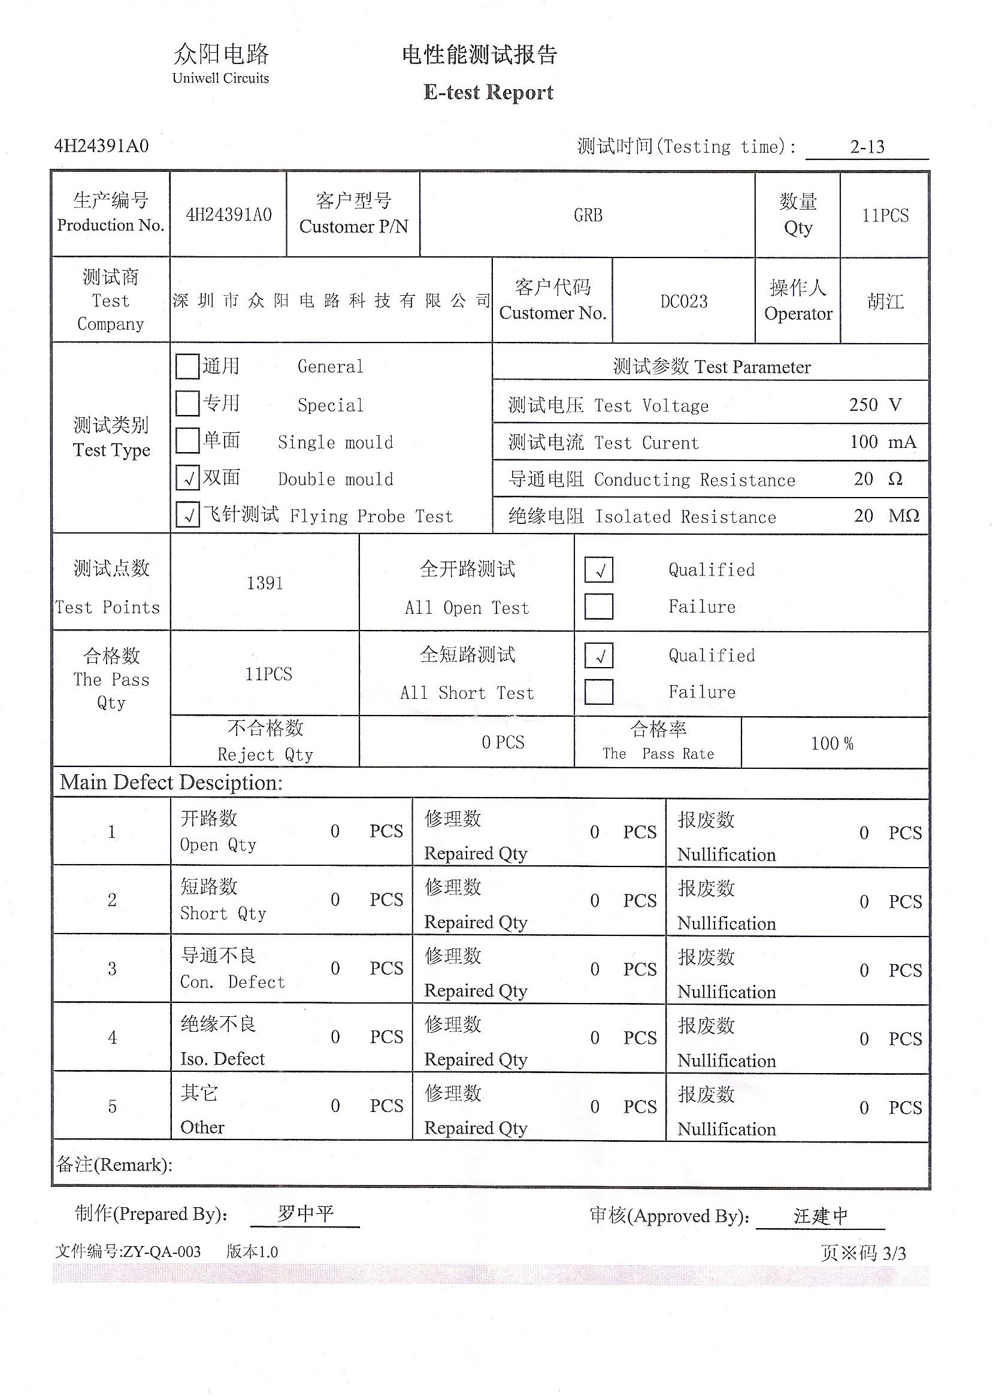
implementação/doc/Relatório de Fabricação das Placas/3-4 - E-Test Report.jpg
