julioamerico/blackfin-ip-phone-hw/implementação/sch/blackfin.pdf

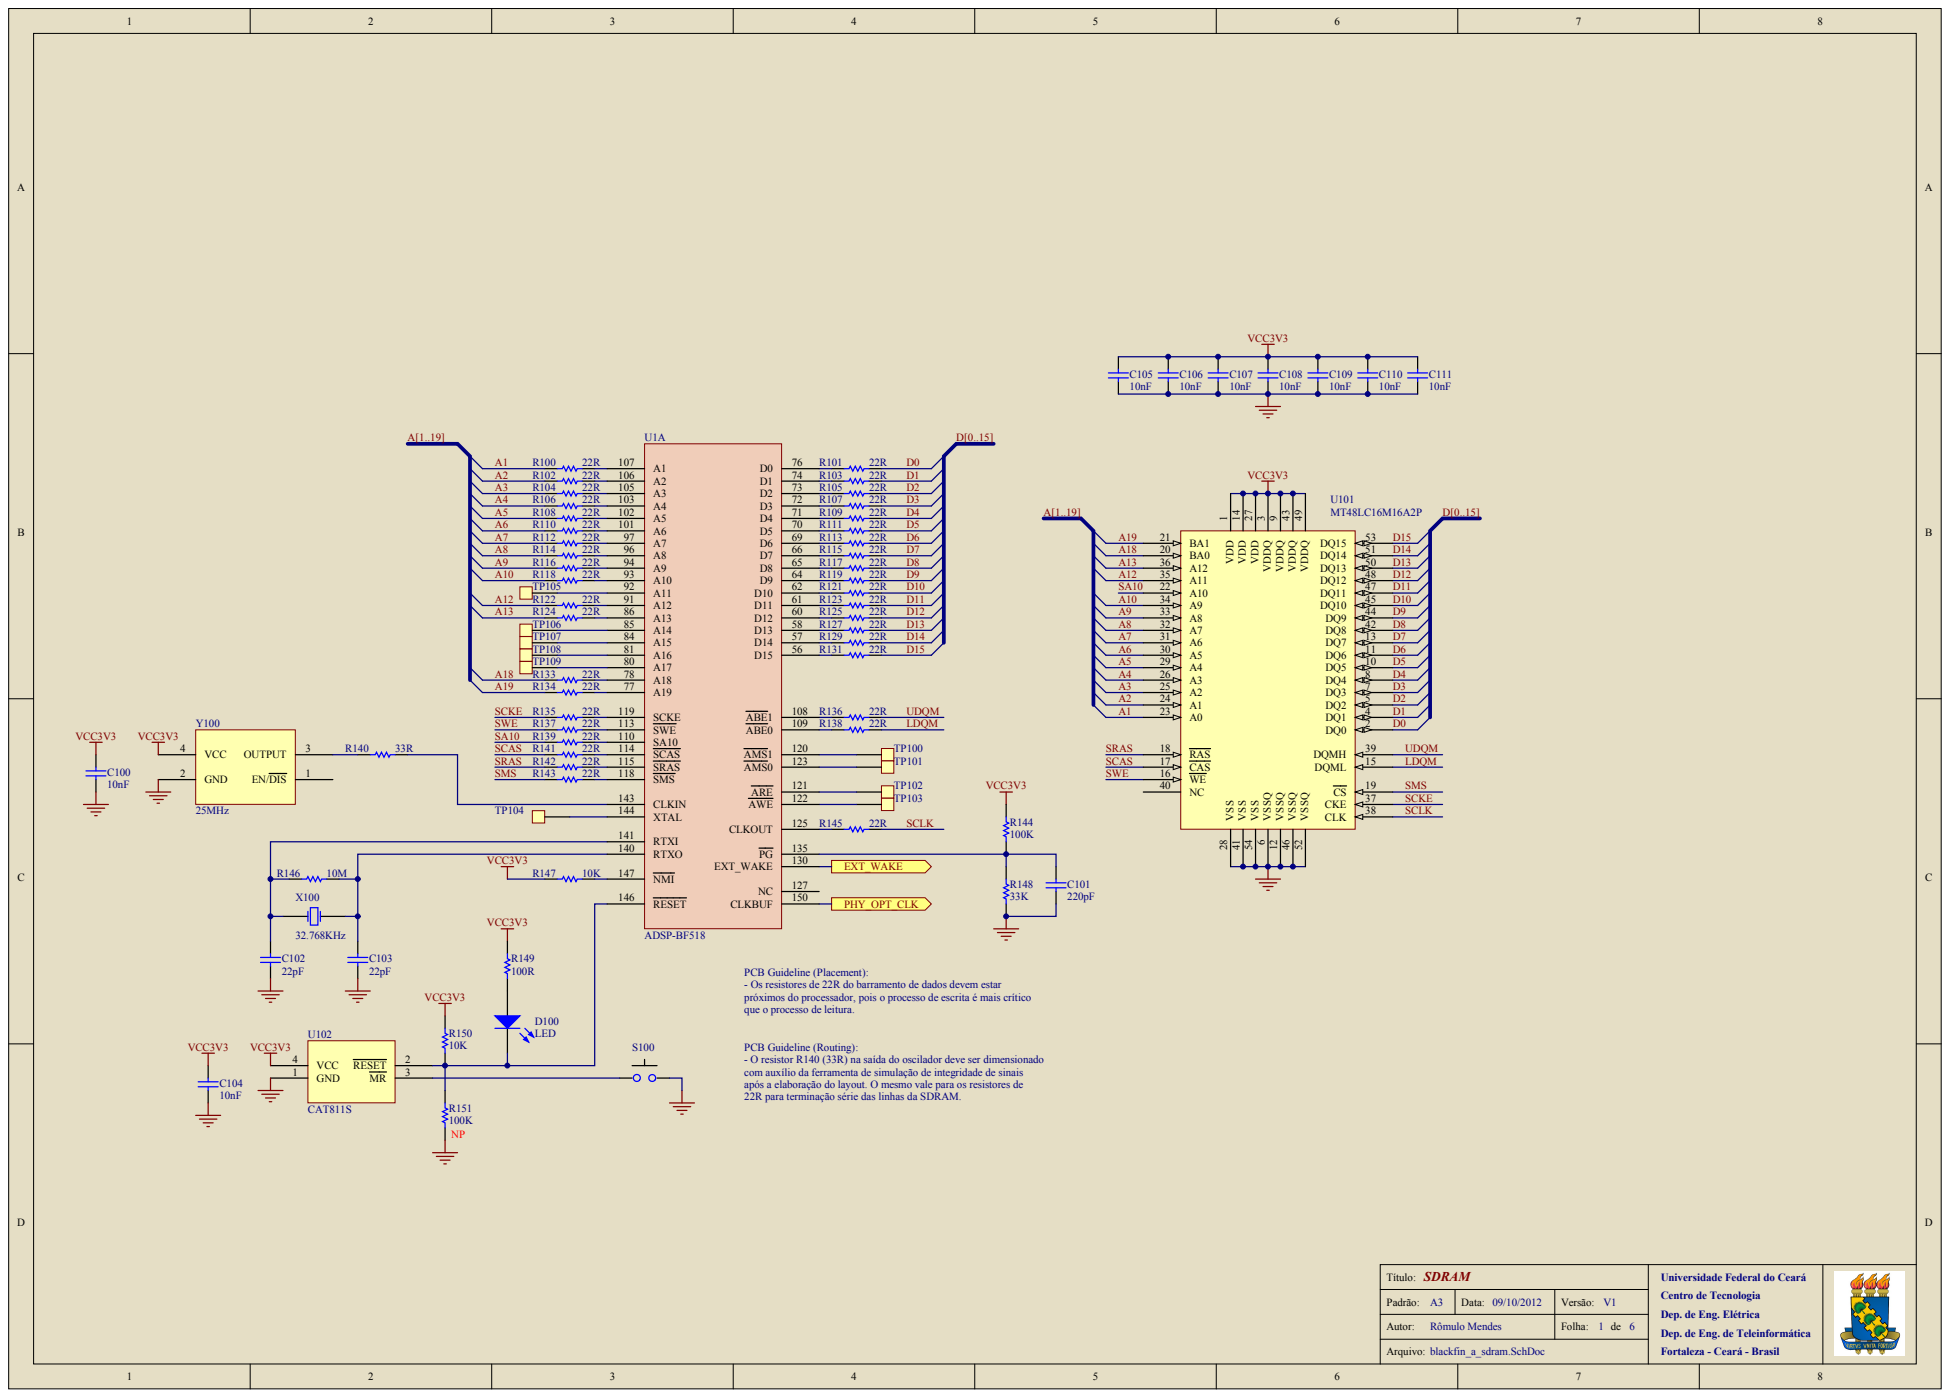
[picture p41: page 1]

Guideline (Place
- Os resistores de 22R do barramento
próximos do

Guideline (Routing):
- O resistor R140 (33R) na saída do oscilador de
com auxílio da ferramenta de simulação de inte
após a elaboração
para terminação série das linhas da SDRAM

Título : SDRAM | U niversidade Federal do Ceará Centro de Tecnologia Dep. de Eng. Elétrica Dep. de E ng. de Teleinformática Fortaleza - Ceará - Brasil

Padrão : A3 | Data: 09/10/201 2 | Versão : V1

Autor: Rômulo Mend e s | | F olha: de

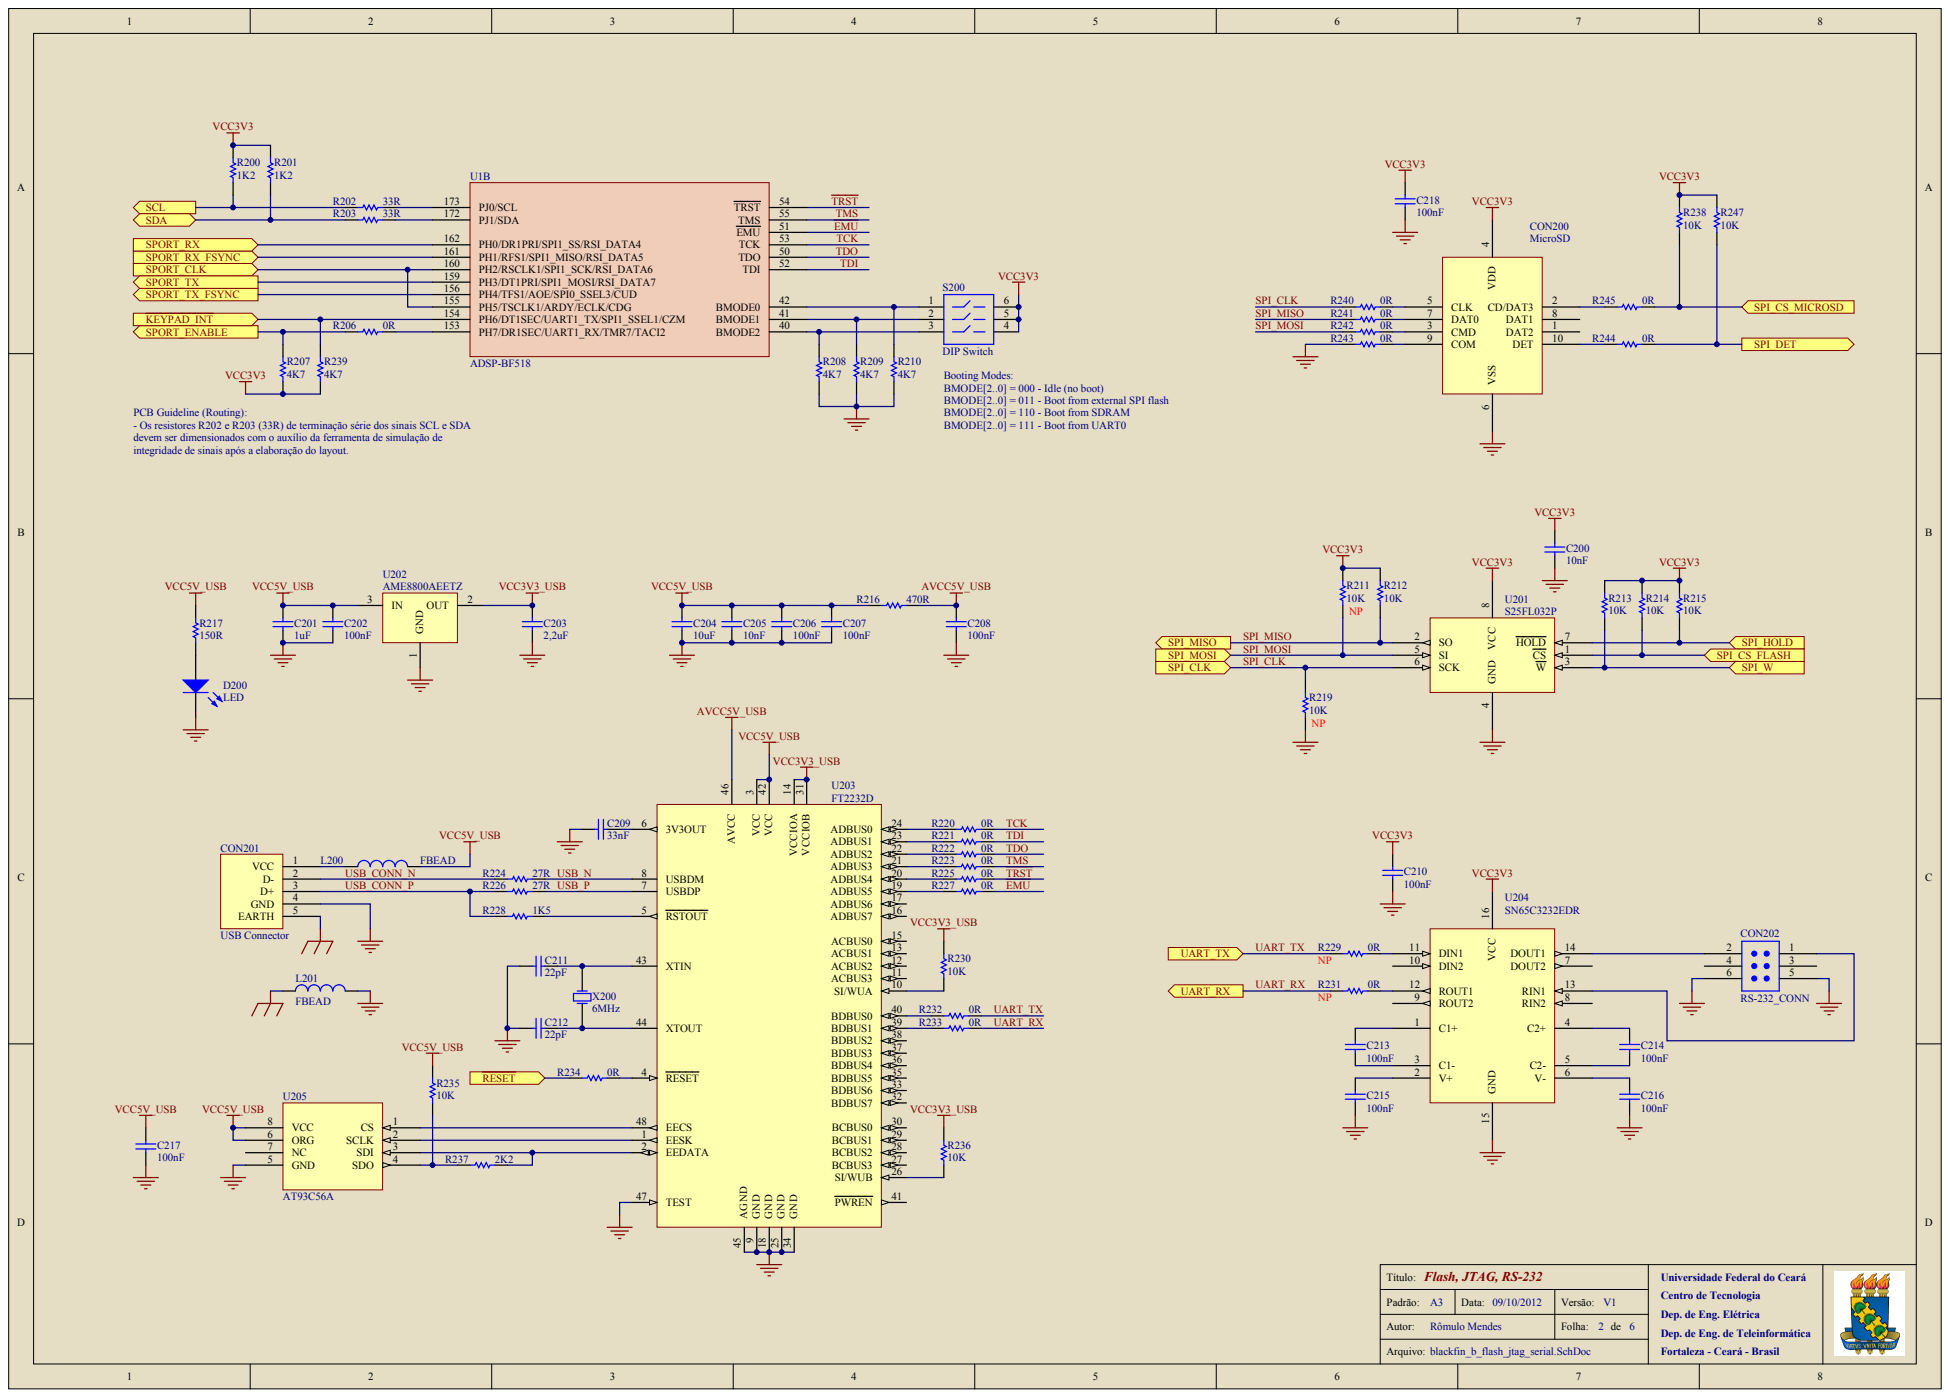
[picture p42: page 2]

BMODE[2..0] = 000 - Idle (no boot)
BMODE[2..0] = 011 - Boot from external SPI flash
BMODE[2..0] = 110 - Boot from SDRAM
BMODE[2..0] = 111 - Boot from UART0

PCB Guideline (Routing):
- Os resistores R202 e R203 (33R) de terminação série dos sinais SCL e SDA
devem ser dimensionados com o auxílio da ferramenta de simulação de
integridade de sinais após a elaboração do layout.

R228 | 1K5 | RSTOUT 5 | VCC3V3_USB

XTIN 43

Título: Flash, JTAG, RS-232 | Universidade Federal do Ceará Centro de Tecnologia Dep. de Eng. Elétrica Dep. de Eng. de Teleinformática

Padrão: | Data: 09/10/2012 | Versão: V1

Autor: Rômulo Mendes | | Folha: de

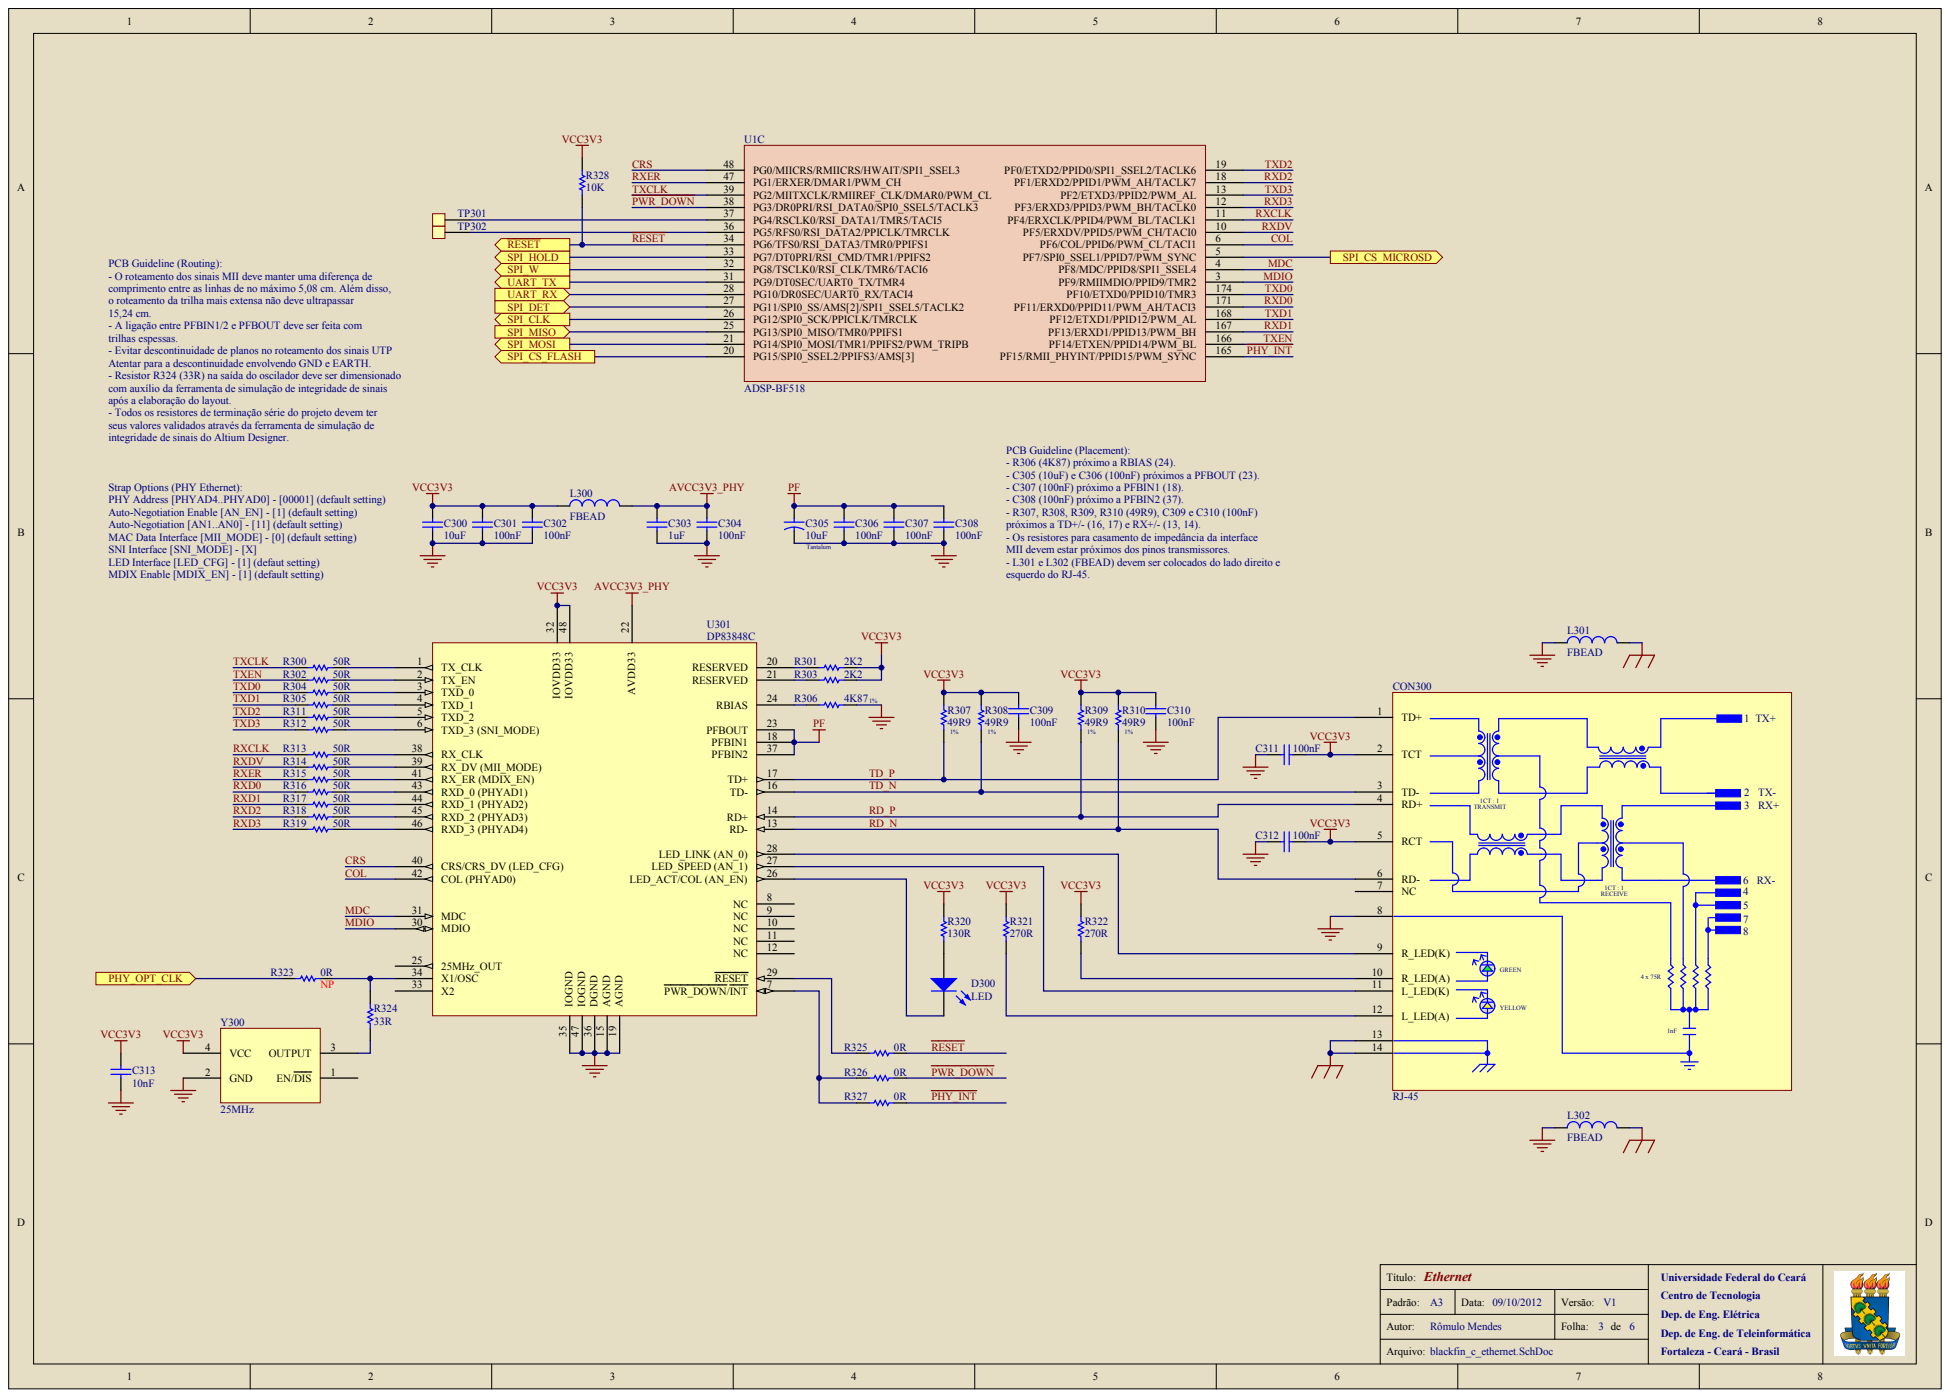
[picture p43: page 3]

TP302 | | PG5/RFS0/RSI_DATA2/PPICLK/TMRCLK 36

RESET | PG6/TFS0/RSI_DATA3/TMR0/PPIFS1 34

PCB Guideline (Routing):
- O roteamento dos sinais MII deve manter uma diferença de
comprimento entre as linhas de no máximo 5,08 cm. Além disso,
o roteamento da trilha mais extensa não deve ultrapassar
- A ligação entre PFBIN1/2 e PFBOUT deve ser feita com
trilhas espessas.
- Evitar descontinuidade de planos no roteamento dos sinais UTP
Atentar para a descontinuidade envolvendo GND e EARTH.
- Resistor R324 (33R) na saída do oscilador deve ser dimensionado
com auxílio da ferramenta de simulação de integridade de sinais
após a elaboração do layout.
- Todos os resistores de terminação série do projeto devem ter
seus valores validados através da ferramenta de simulação de
integridade de sinais do Altium Designer.

PCB Guideline (Placement):
- R306 (4K87) próximo a RBIAS (24).
- C305 (10uF) e C306 (100nF) próximos a PFBOUT (23).
- C307 (100nF) próximo a PFBIN1 (18).
- C308 (100nF) próximo a PFBIN2 (37).
próximos a TD+/- (16, 17) e RX+/- (13, 14).
- Os resistores para casamento de impedância da interface
MII devem estar próximos dos pinos transmissores.
- L301 e L302 (FBEAD) devem ser colocados do lado direito e
esquerdo do RJ-45.

Strap Options (PHY Ethernet):
PHY Address [PHYAD4..PHYAD0] - [00001] (default setting)
Auto-Negotiation Enable [AN_EN] - [1] (default setting)
Auto-Negotiation [AN1..AN0] - [11] (default setting)
MAC Data Interface [MII_MODE] - [0] (default setting)
SNI Interface [SNI_MODE] - [X]
LED Interface [LED_CFG] - [1] (defaut setting)
MDIX Enable [MDIX_EN] - [1] (default setting)

RD_P | | RCT 5

D300 | R_LED(A) 10

L_LED(A) 12

Universidade Federal do Ceará

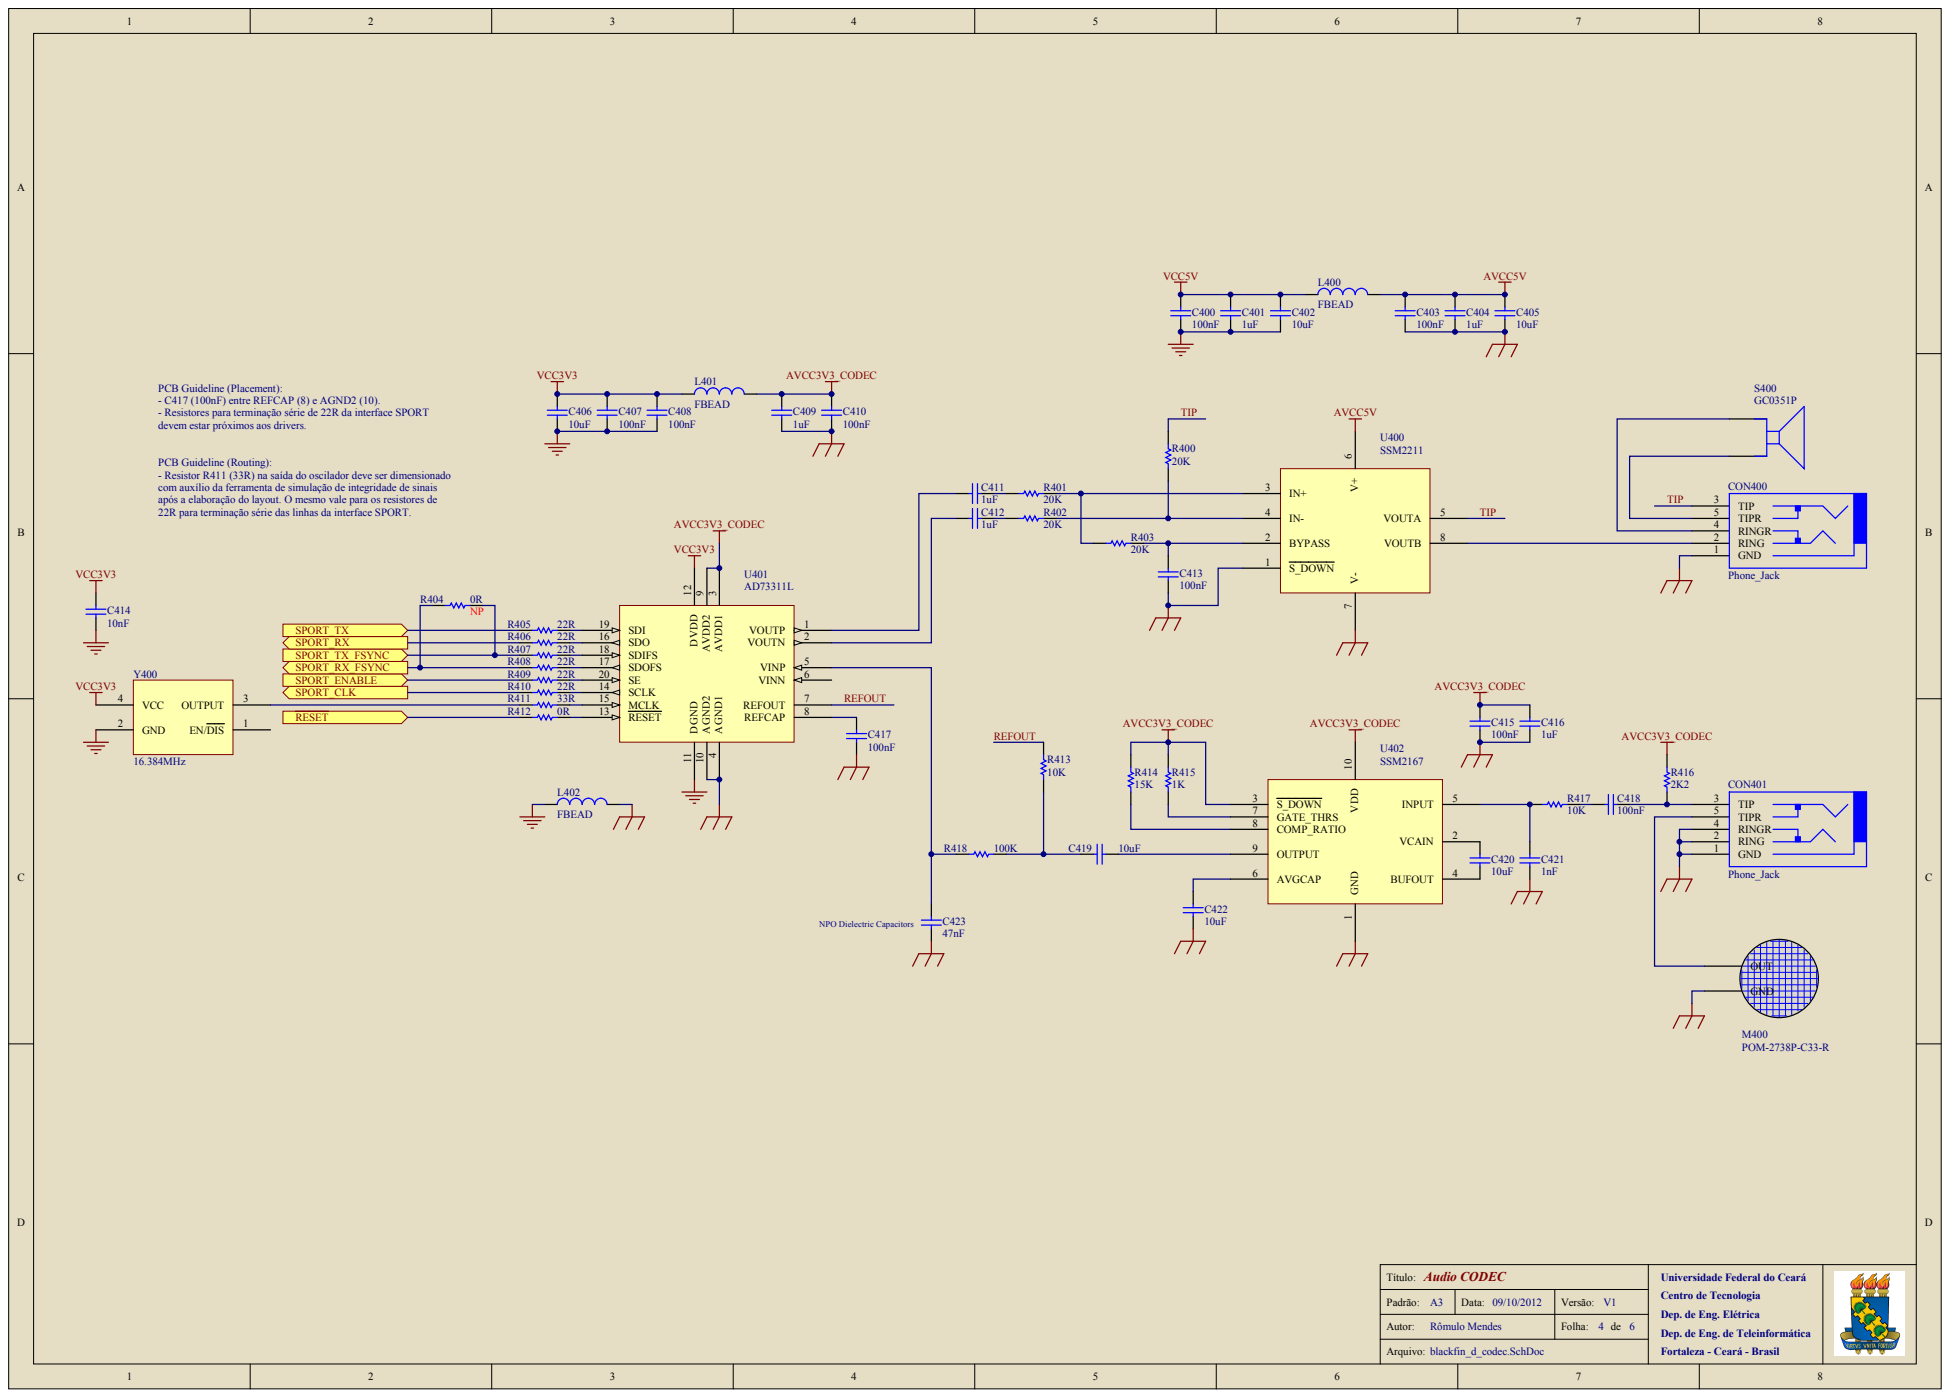
[picture p44: page 4]

PCB Guideline (Placement):
- C417 (100nF) entre REFCAP (8) e AGND2 (10).
- Resistores para terminação série de 22R da interface SPORT
devem estar próximos aos drivers.

PCB Guideline (Routing):
- Resistor R411 (33R) na saída do oscilador deve ser dimensionado
com auxílio da ferramenta de simulação de integridade de sinais
após a elaboração do layout. O mesmo vale para os resistores de
22R para terminação série das linhas da interface SPORT.

Universidade Federal do Ceará

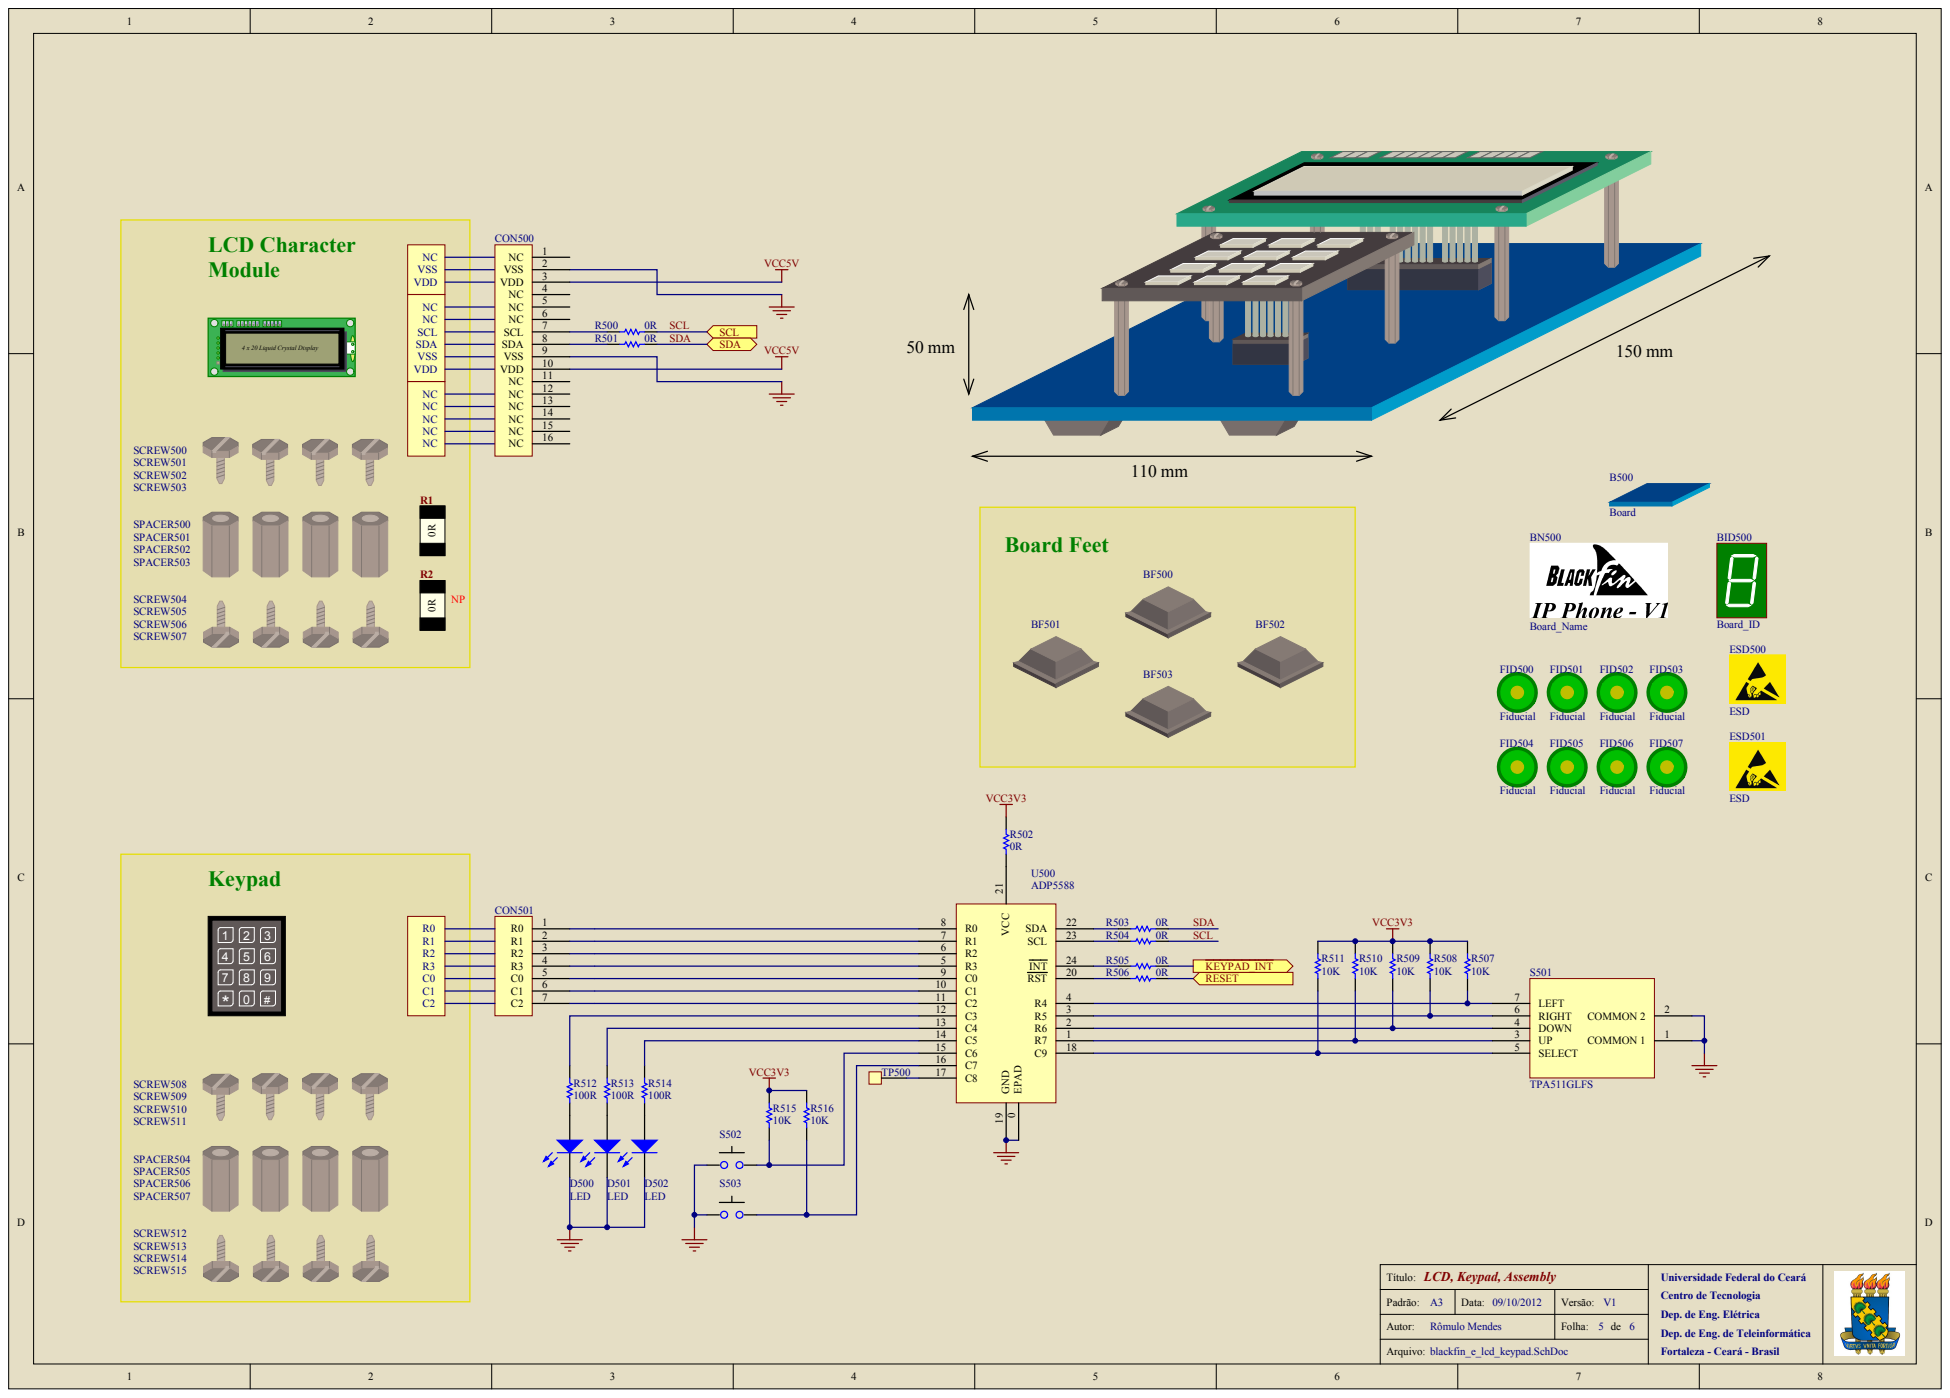
[picture p45: page 5]

C4 13 | | UP 3 DOWN 4
C5 14
C6 15 | SELECT 5
C7 16

R512 100R | R513 100R | VCC3V3 | | TP500 | C8 17

Universidade Federal do Ceará

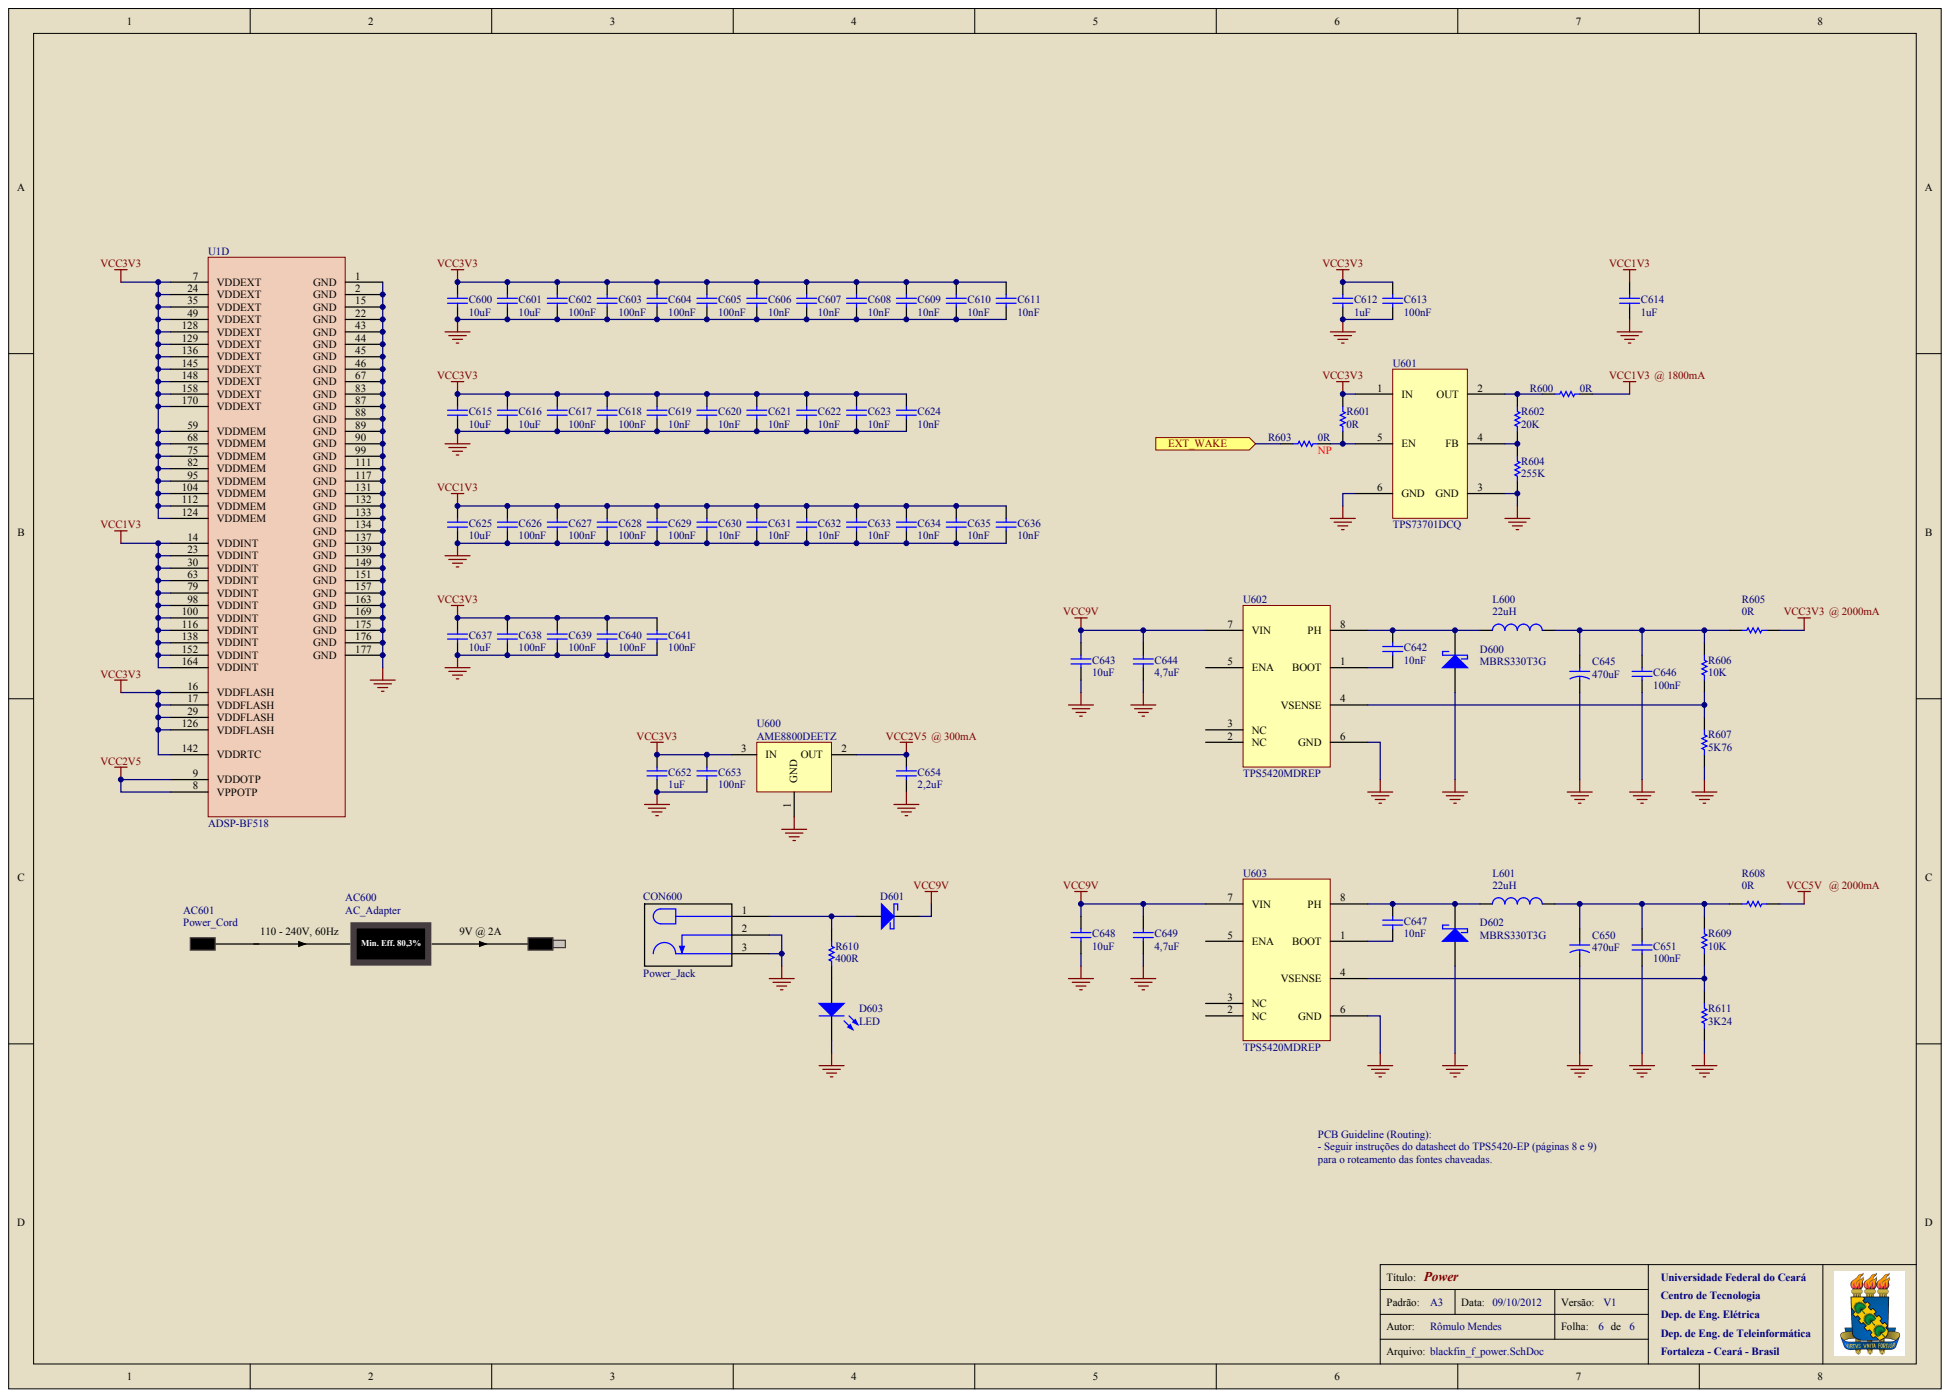
[picture p46: page 6]

VDDEXT 170 | | C61 5 C61 6 C61 7 C61 8 C61 9 C62 0 C62 1 C62 2 C62 3 R60 1 6

VDDMEM 68
VDDMEM 75
VDDMEM 82 | 1 | VCC1V3
VDDMEM 95 | 7
VDDMEM 104 | 1
VDDMEM 112 | 2
VDDMEM 124 | 3

VDDINT 14 | 4

VDDINT 23 | 9
VDDINT 30 | 9
VDDINT 63 | 1
VDDINT 79 | 7
VDDINT 98 | 3

VDDINT 138 | 6
VDDINT 152 | 7

et do TPS5420-EP (pá
eadas.

Título : Power | U niversidade Federal do Ceará Centro de Tecnologia Dep. de Eng. Elétrica Dep. de E ng. de Teleinformática

Padrão : | Data: 09/10/201 2 | Versão : V1

Autor: Rômulo Mend e s | | F olha: de
