julioamerico/blackfin-ip-phone-hw/implementação/doc/blackfin_sch.pdf

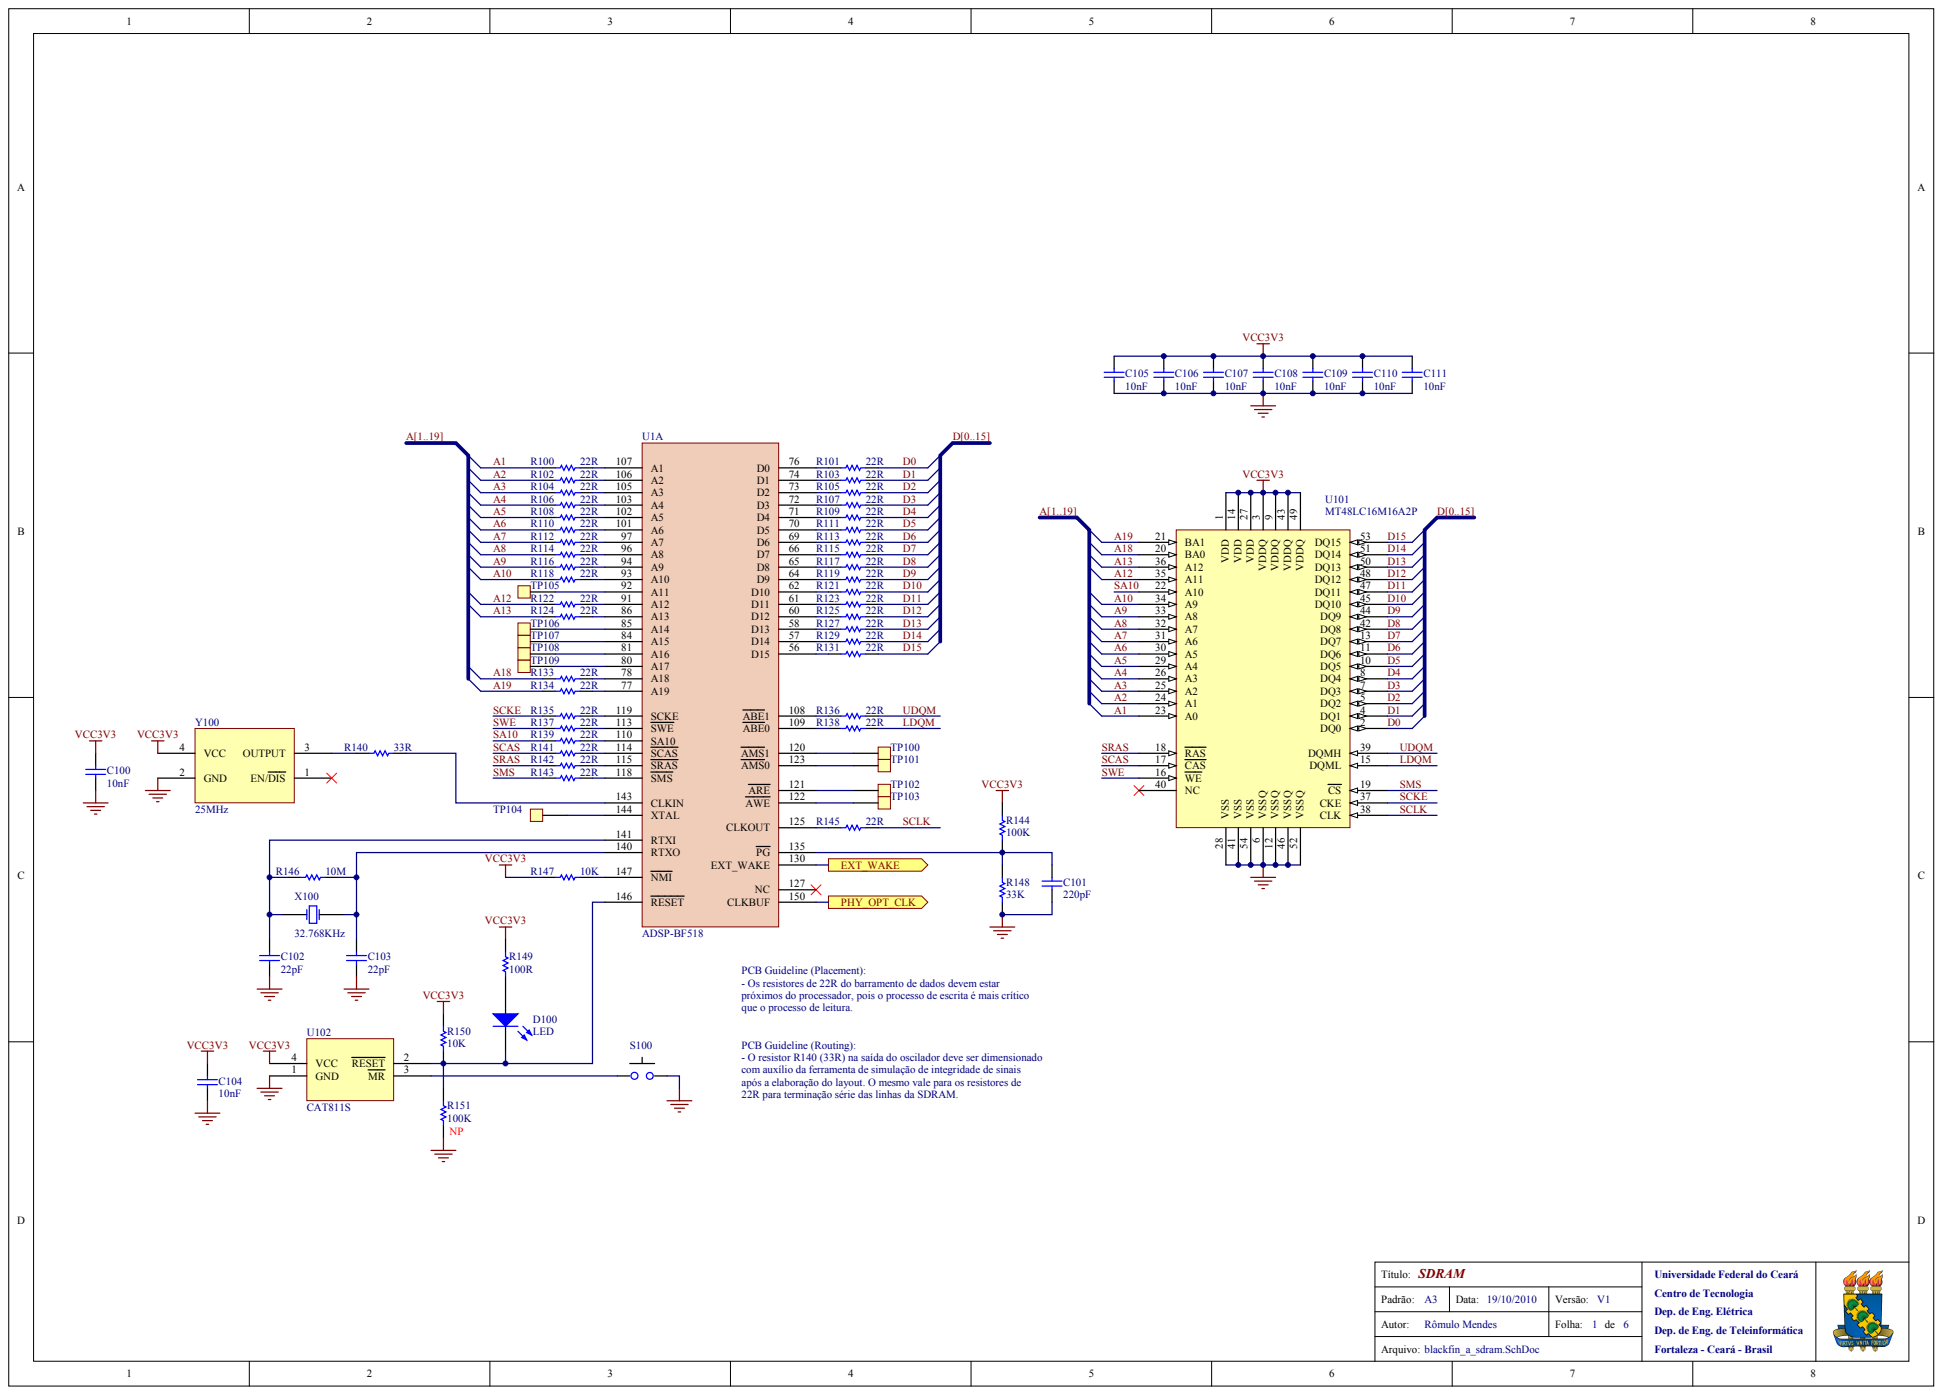
[picture p47: page 1]

PCB G
- Os resistores de 22R do barra
próximos do processa

dor, pois o processo de escrita é mais crític
e leitura.

- O resistor R140 (33R) na saíd
com auxílio da ferramenta de sim
a elaboraçã
após
22R para termin

SDRAM | U niversid a d e Feder al do Cea r á Centro de Tecnologia Dep. de Eng. Elétrica Dep. de E ng. de Teleinform ática Fortaleza - Ceará - Brasil

: A | Data: 19/10/2010 | Versão: V1

Autor: Rô mulo Me ndes | | Folh a : de

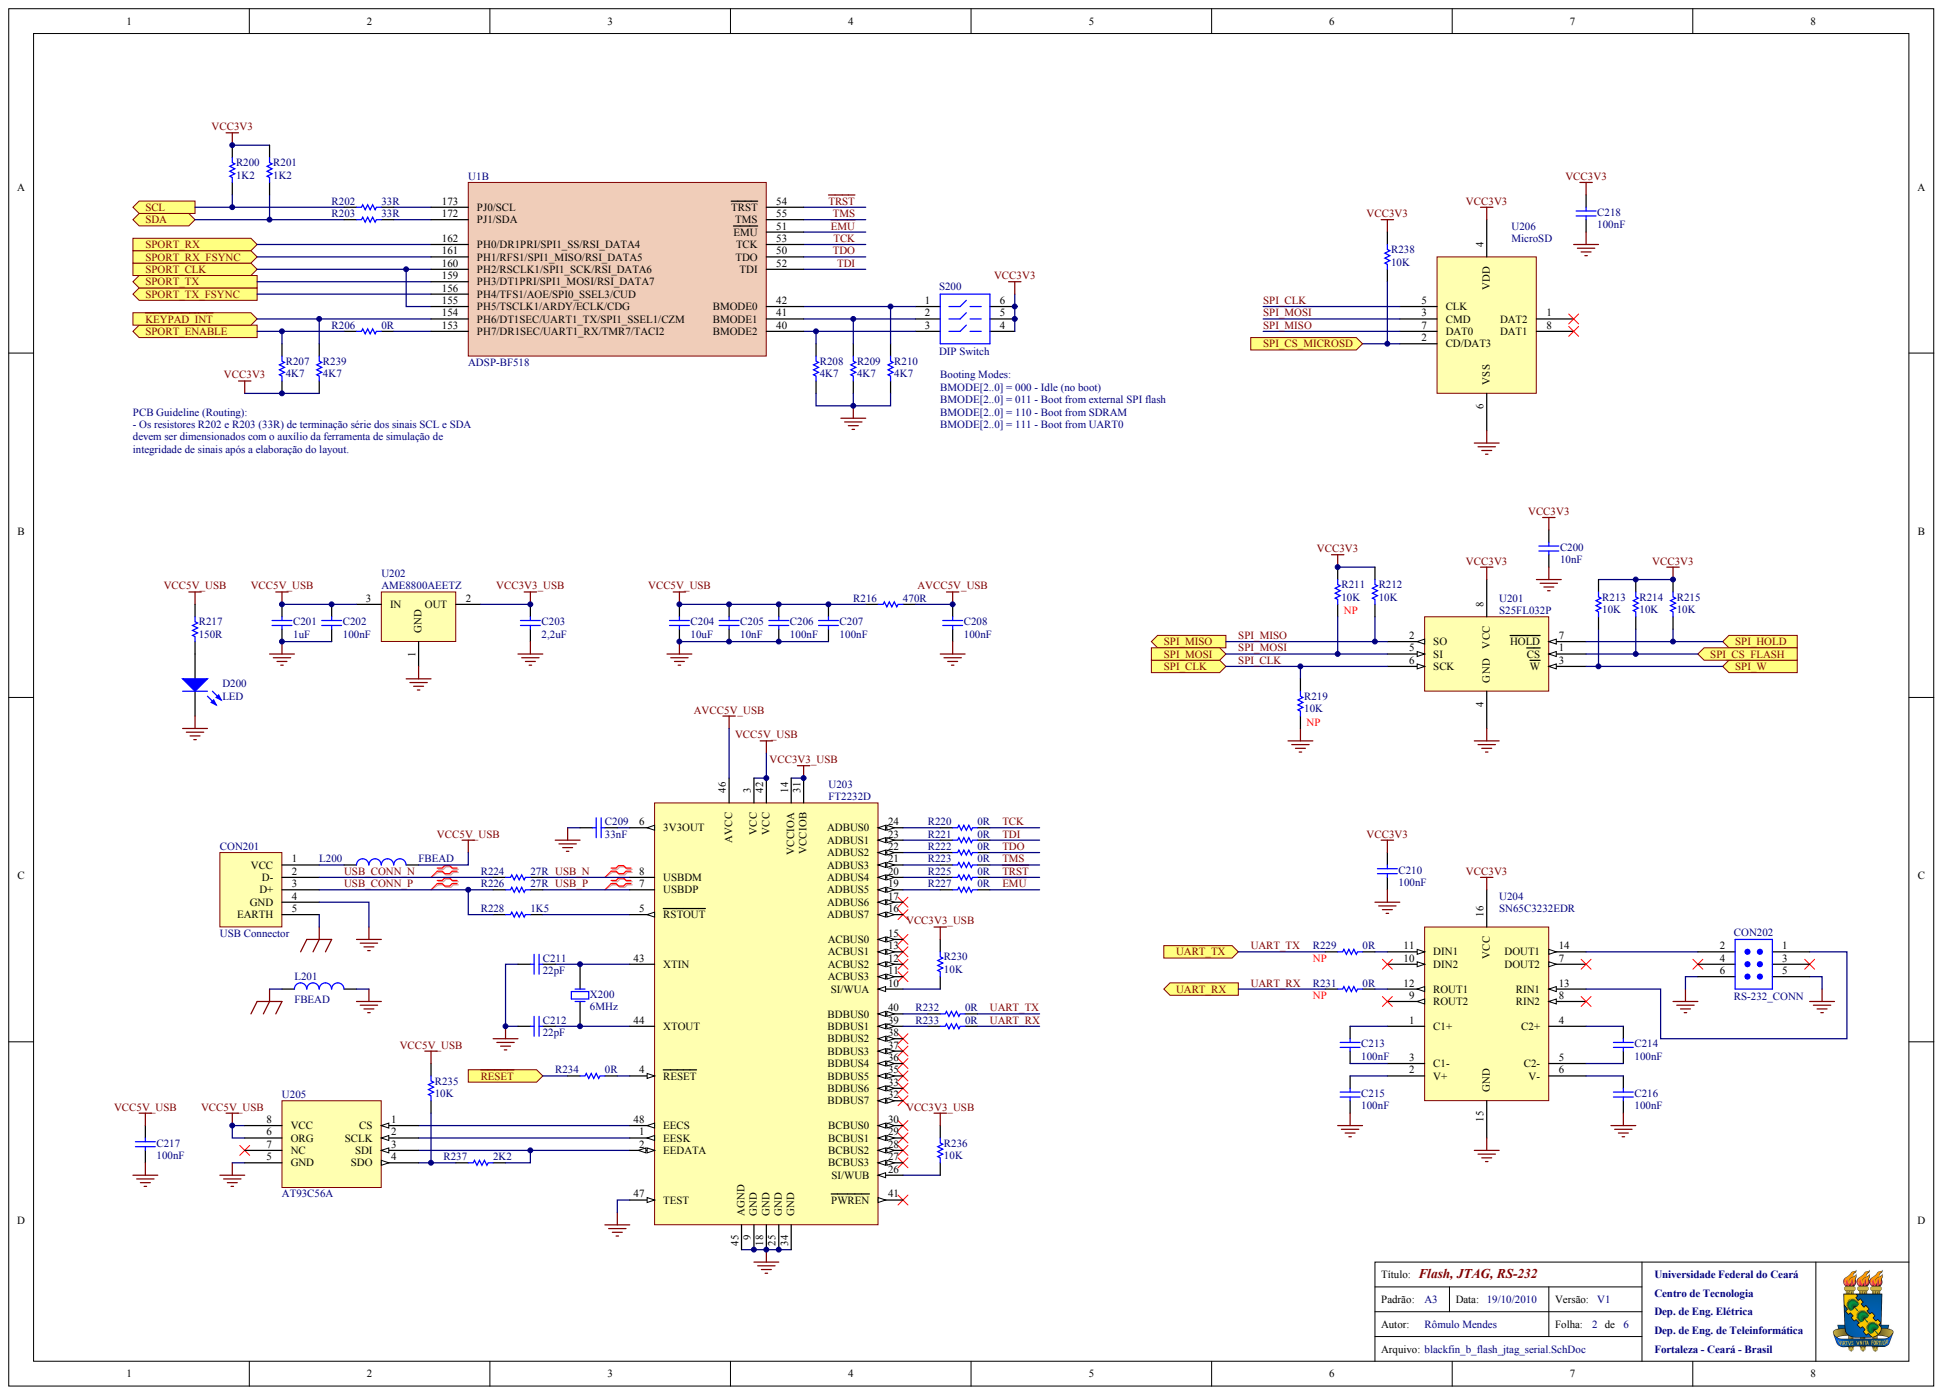
[picture p48: page 2]

PH6/DT1SEC/UART1_TX/SPI1_SSEL1/CZM 154 PH7/DR1SEC/UART1_RX/TMR7/TACI2 153 | 2 | 5

BMODE[2..0] = 000 - Idle (no boot)
BMODE[2..0] = 011 - Boot from external SPI flash
BMODE[2..0] = 110 - Boot from SDRAM
BMODE[2..0] = 111 - Boot from UART0

PCB Guideline (Routing):
- Os resistores R202 e R203 (33R) de terminação série dos sinais SCL e SDA
devem ser dimensionados com o auxílio da ferramenta de simulação de
integridade de sinais após a elaboração do layout.

R228 | 1K5 | RSTOUT 5 | VCC3V3_USB

XTIN 43

Título: Flash, JTAG, RS-232 | Universidade Federal do Ceará Centro de Tecnologia Dep. de Eng. Elétrica Dep. de Eng. de Teleinformática

Padrão: A3 | Data:

Autor: Rômulo Mendes | | Folha: de

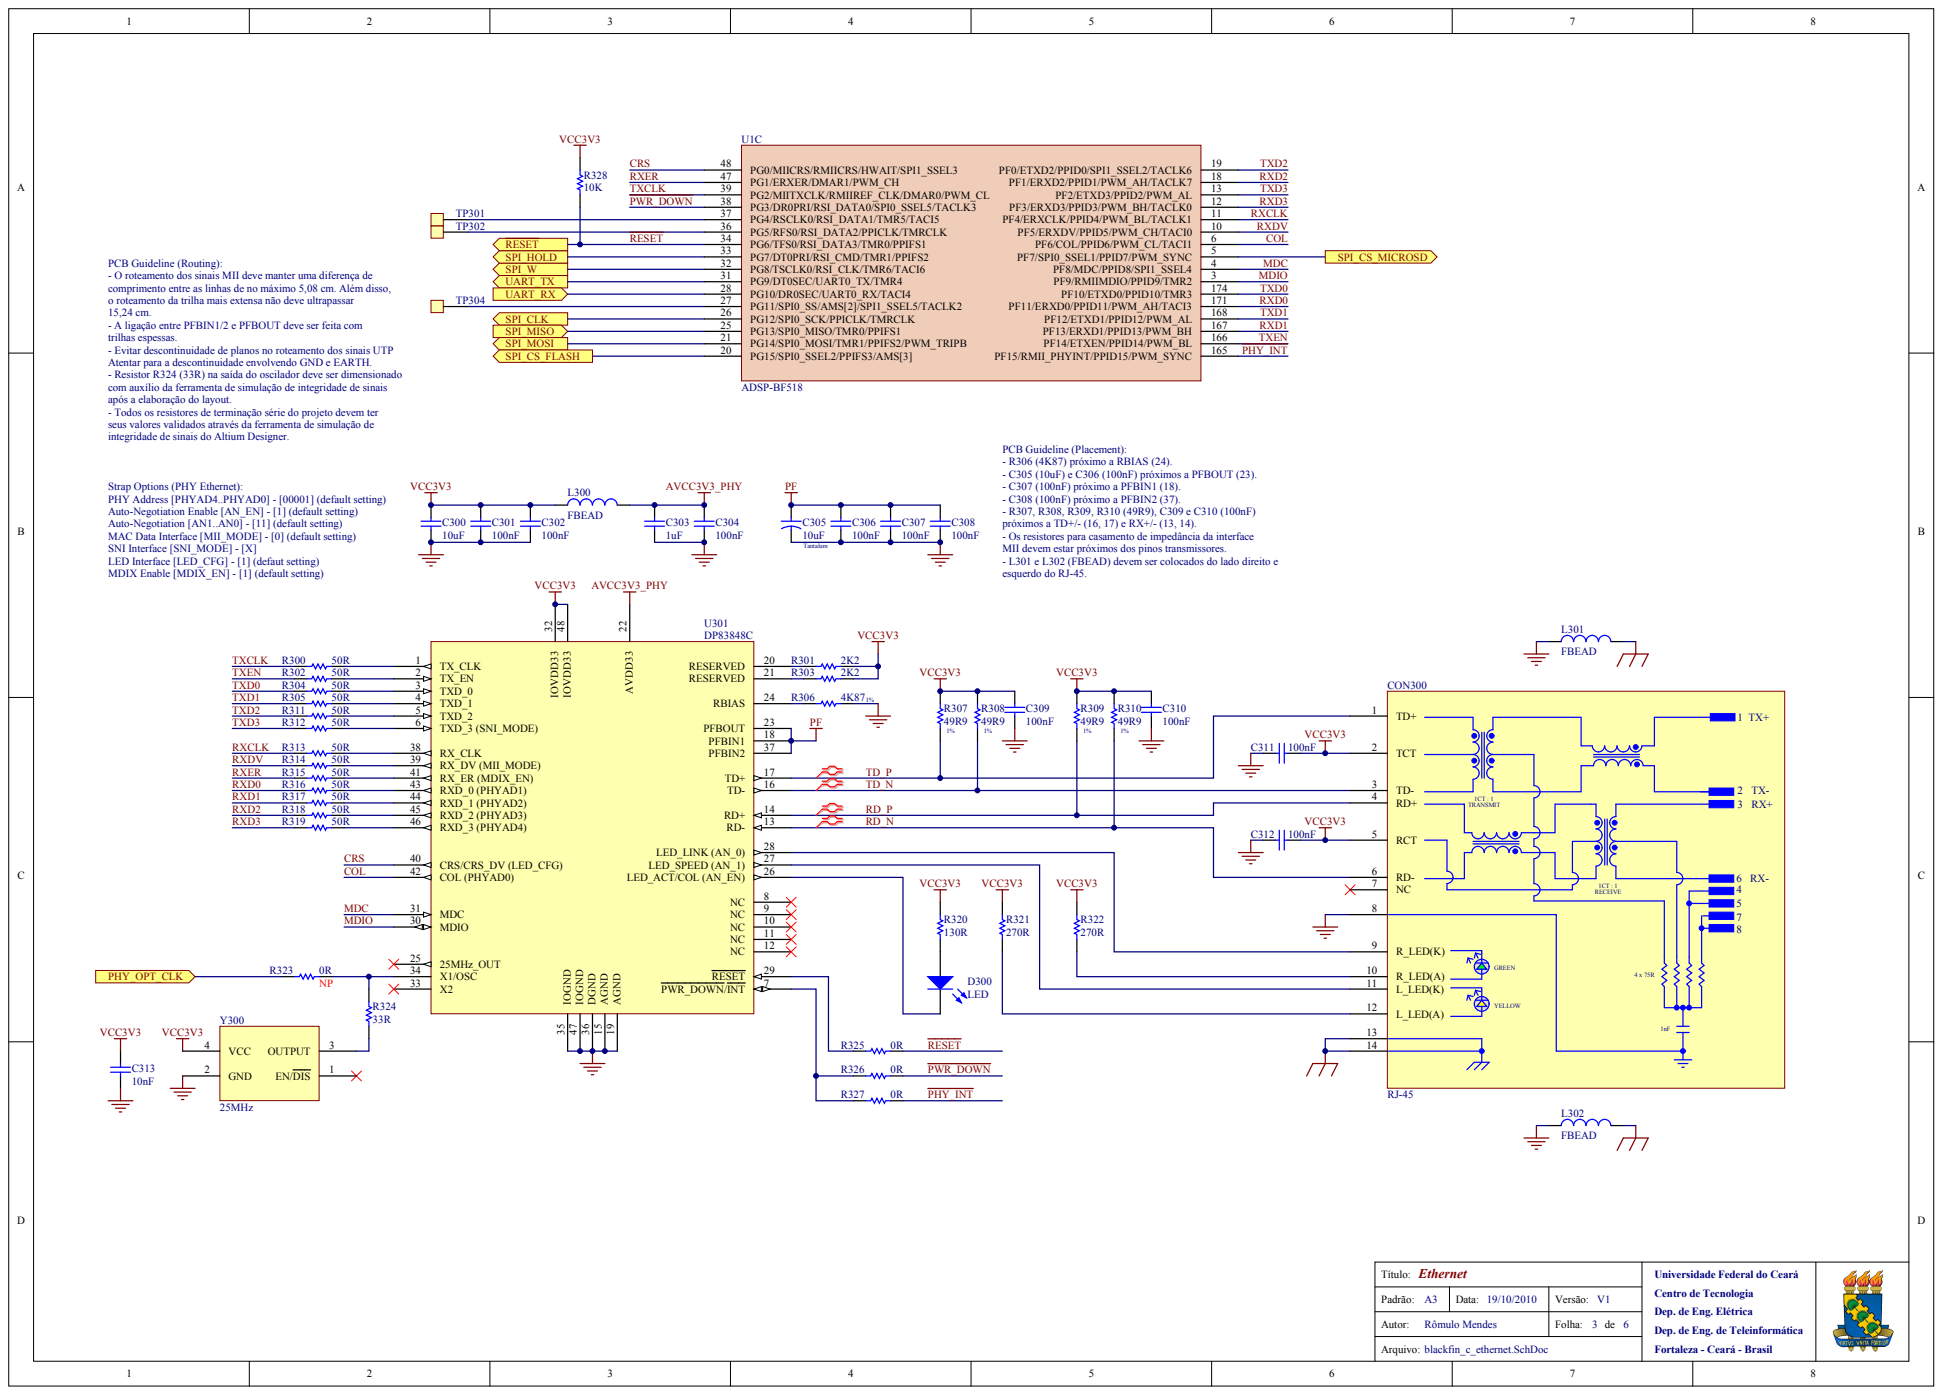
[picture p49: page 3]

PCB Guideline (Routing):
- O roteamento dos sinais MII deve manter uma diferença de
comprimento entre as linhas de no máximo 5,08 cm. Além disso,
o roteamento da trilha mais extensa não deve ultrapassar
- A ligação entre PFBIN1/2 e PFBOUT deve ser feita com
trilhas espessas.
- Evitar descontinuidade de planos no roteamento dos sinais UTP
Atentar para a descontinuidade envolvendo GND e EARTH.
- Resistor R324 (33R) na saída do oscilador deve ser dimensionado
com auxílio da ferramenta de simulação de integridade de sinais
após a elaboração do layout.
- Todos os resistores de terminação série do projeto devem ter
seus valores validados através da ferramenta de simulação de
integridade de sinais do Altium Designer.

PCB Guideline (Placement):
- R306 (4K87) próximo a RBIAS (24).
- C305 (10uF) e C306 (100nF) próximos a PFBOUT (23).
- C307 (100nF) próximo a PFBIN1 (18).
- C308 (100nF) próximo a PFBIN2 (37).
próximos a TD+/- (16, 17) e RX+/- (13, 14).
- Os resistores para casamento de impedância da interface
MII devem estar próximos dos pinos transmissores.
- L301 e L302 (FBEAD) devem ser colocados do lado direito e
esquerdo do RJ-45.

Strap Options (PHY Ethernet):
PHY Address [PHYAD4..PHYAD0] - [00001] (default setting)
Auto-Negotiation Enable [AN_EN] - [1] (default setting)
Auto-Negotiation [AN1..AN0] - [11] (default setting)
MAC Data Interface [MII_MODE] - [0] (default setting)
SNI Interface [SNI_MODE] - [X]
LED Interface [LED_CFG] - [1] (defaut setting)
MDIX Enable [MDIX_EN] - [1] (default setting)

D300 | R_LED(A) 10

L_LED(A) 12

Universidade Federal do Ceará

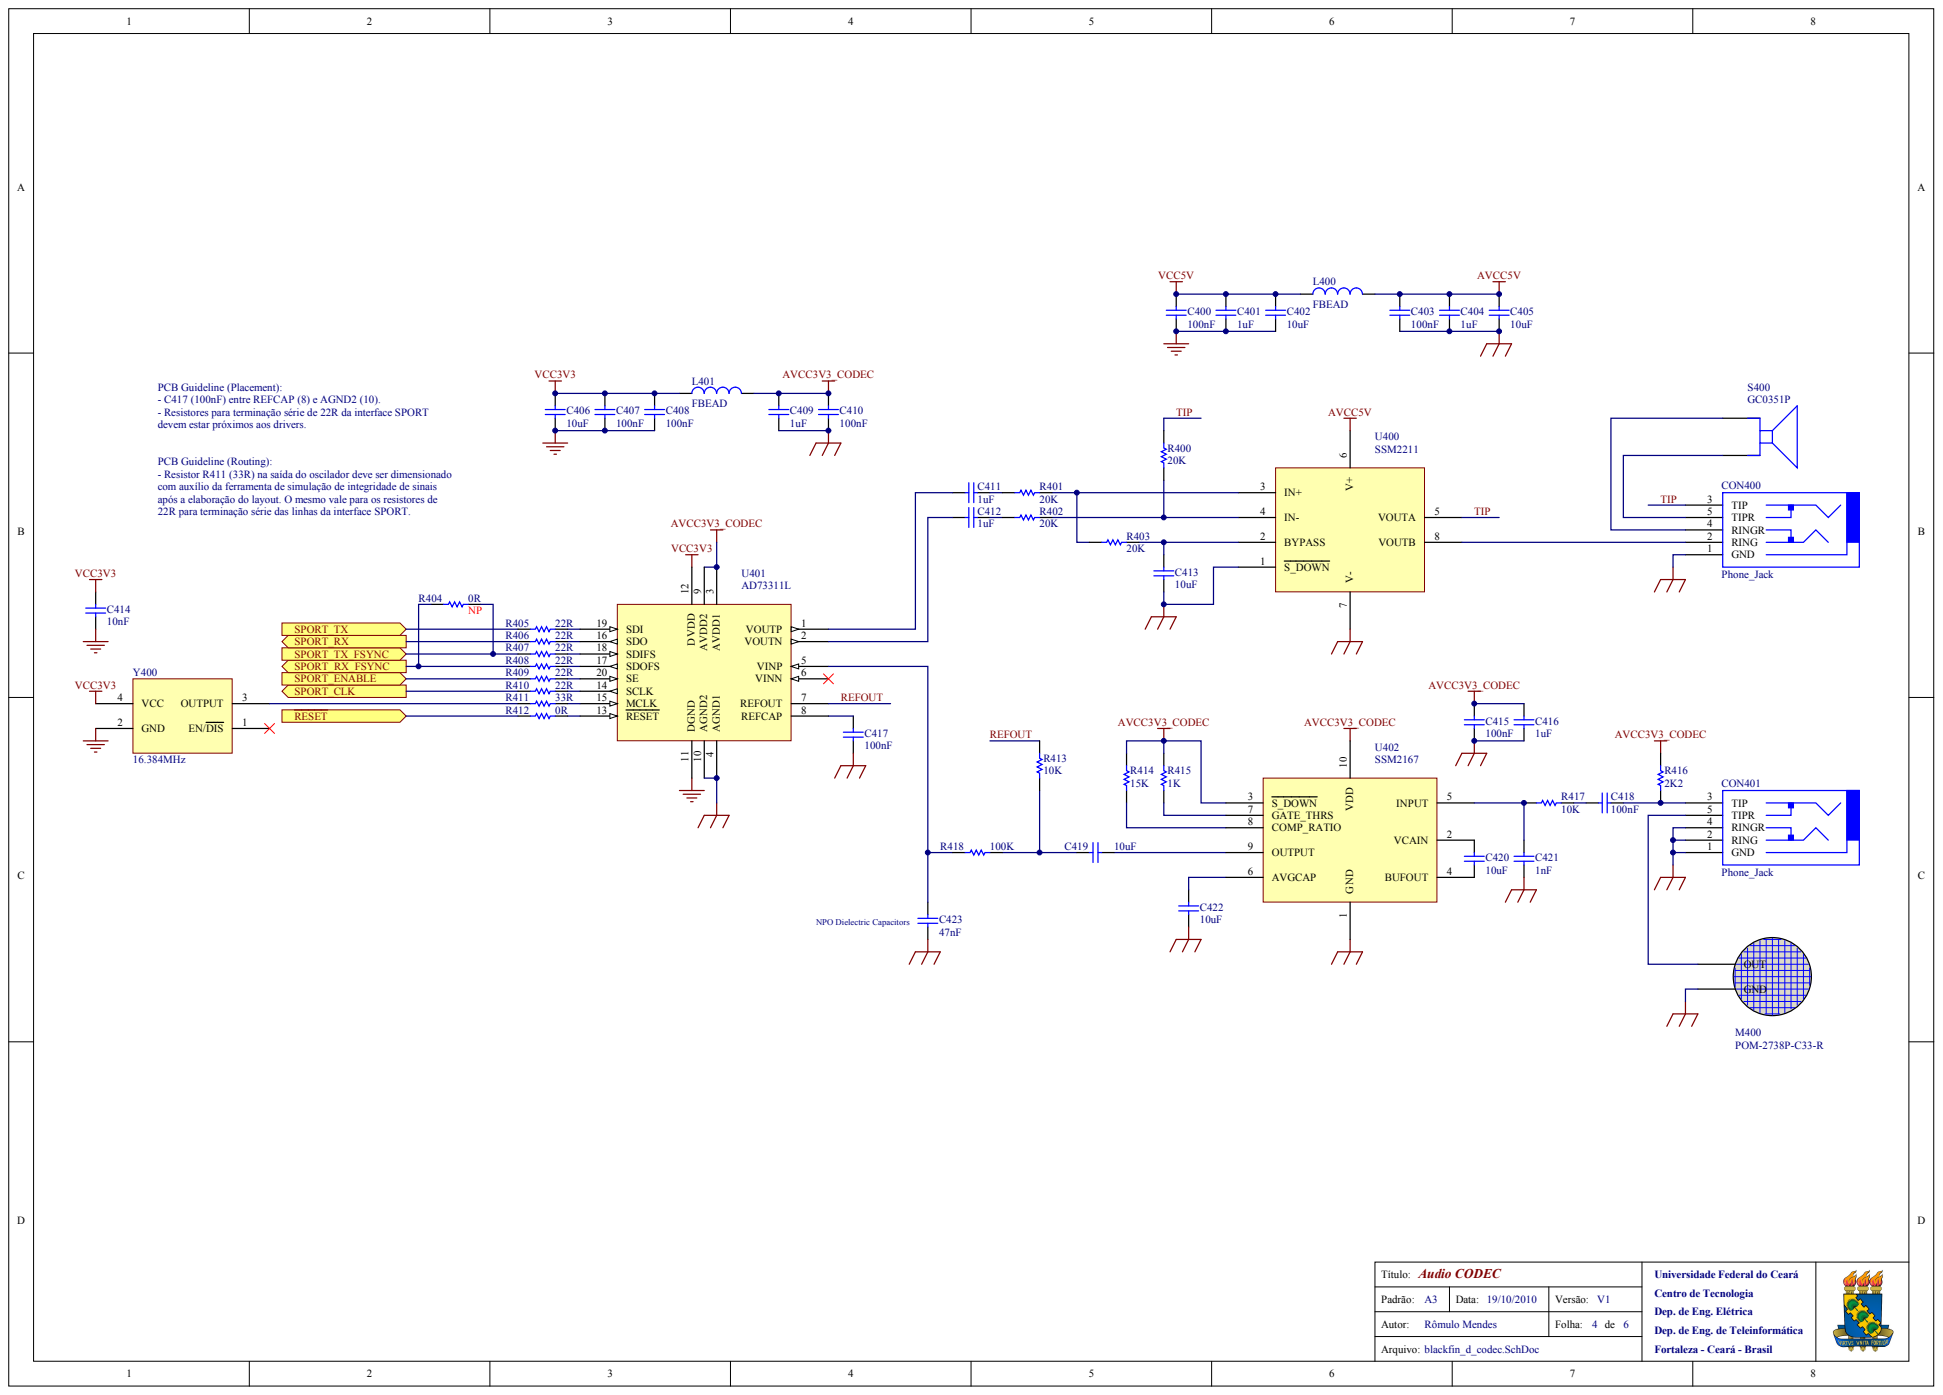
[picture p50: page 4]

PCB Guideline (Placement):
- C417 (100nF) entre REFCAP (8) e AGND2 (10).
- Resistores para terminação série de 22R da interface SPORT
devem estar próximos aos drivers.

PCB Guideline (Routing):
- Resistor R411 (33R) na saída do oscilador deve ser dimensionado
com auxílio da ferramenta de simulação de integridade de sinais
após a elaboração do layout. O mesmo vale para os resistores de
22R para terminação série das linhas da interface SPORT.

Universidade Federal do Ceará

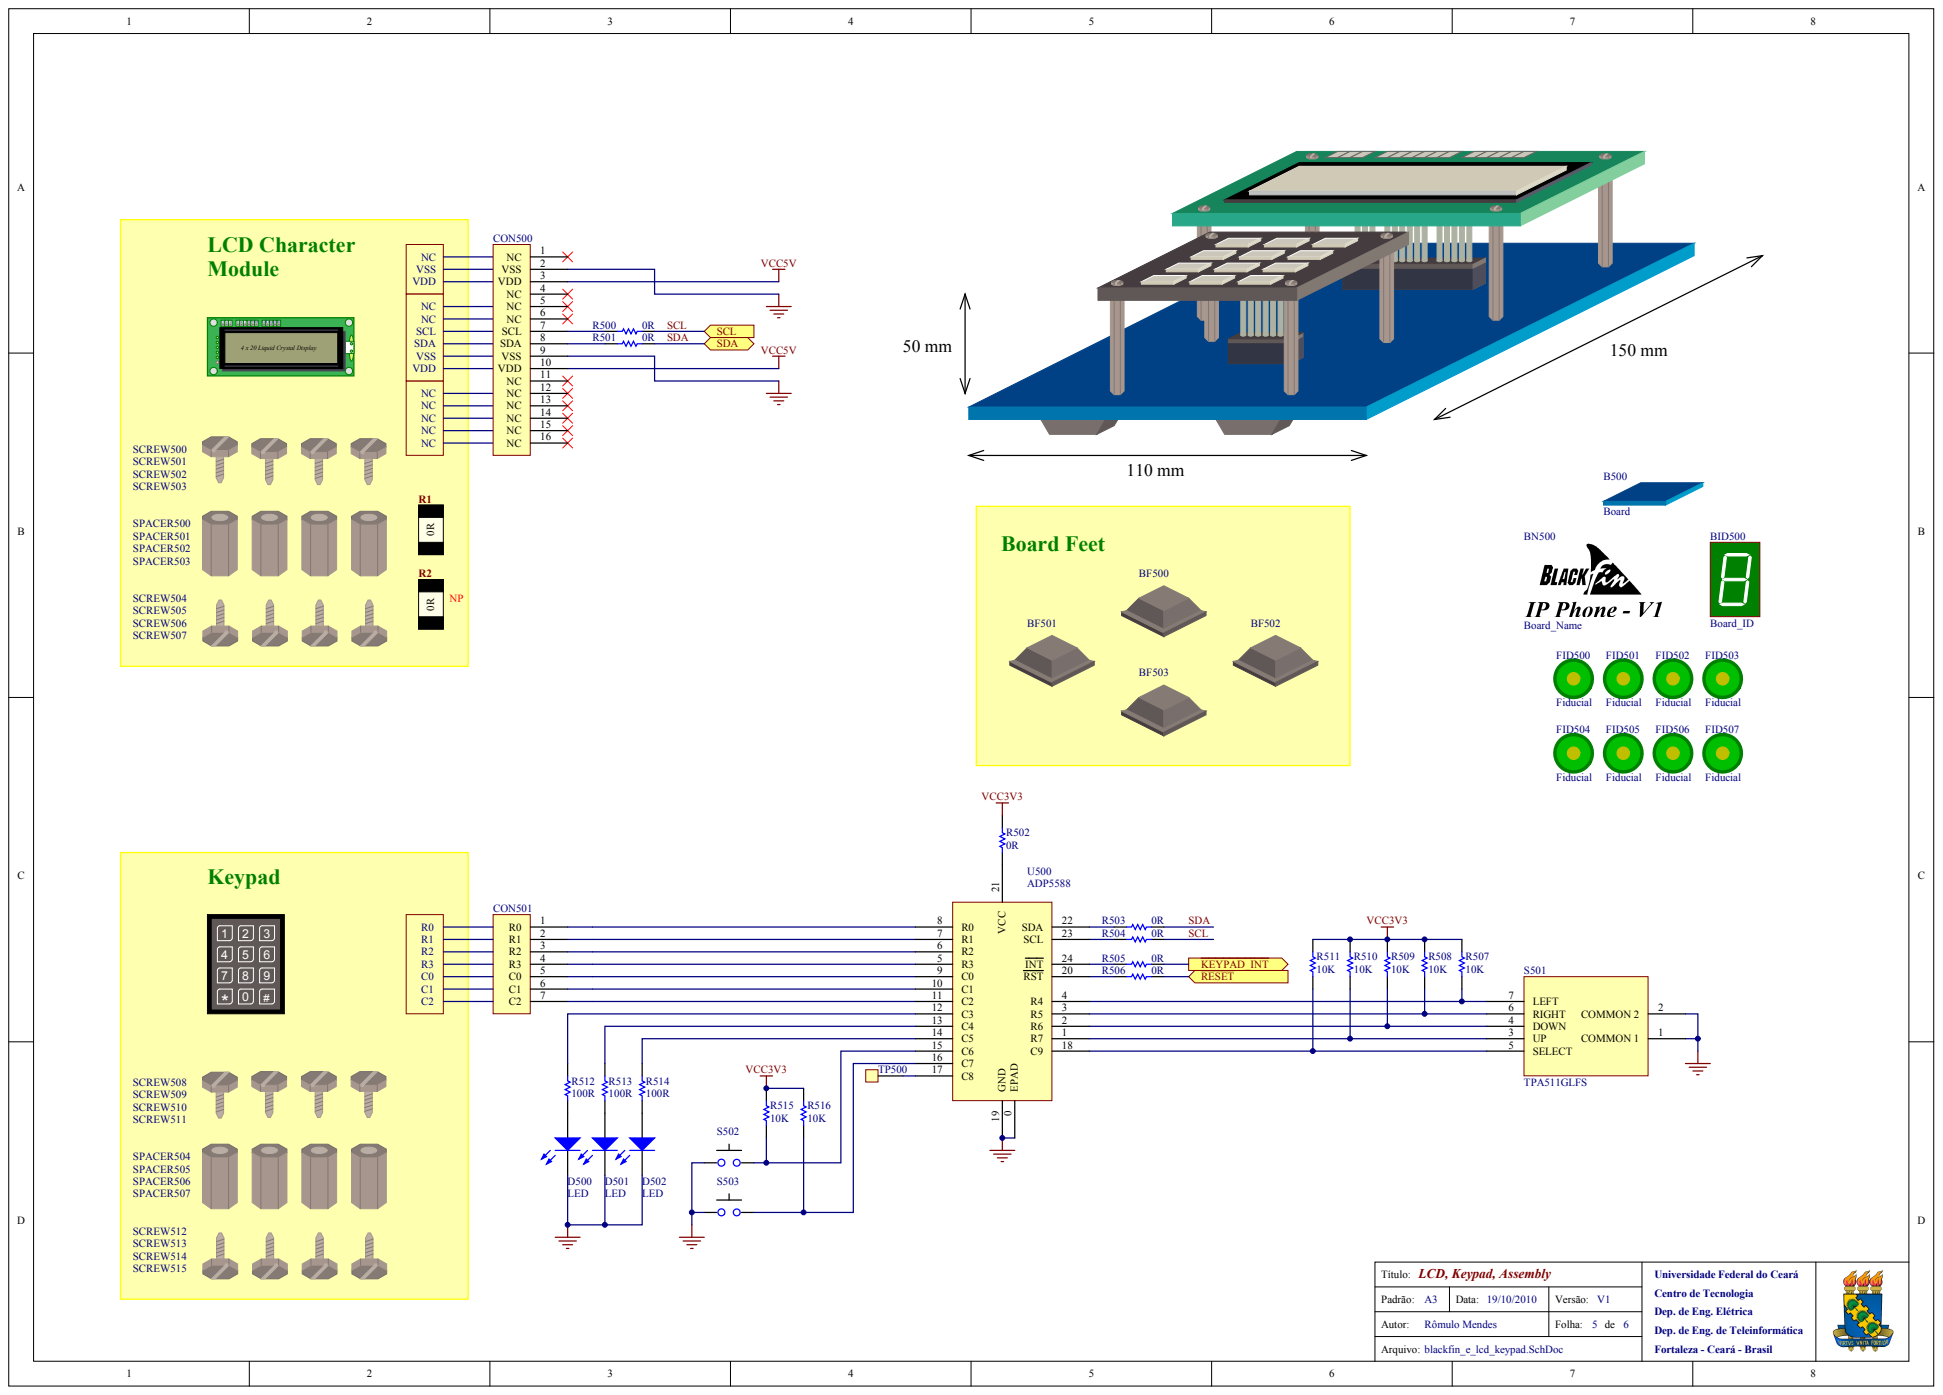
[picture p51: page 5]

C4 13 | | UP 3 DOWN 4
C5 14
C6 15 | | SELECT 5
C7 16

R512 100R | R513 100R | VCC3V3 | TP500 | C8 17

Universidade Federal do Ceará

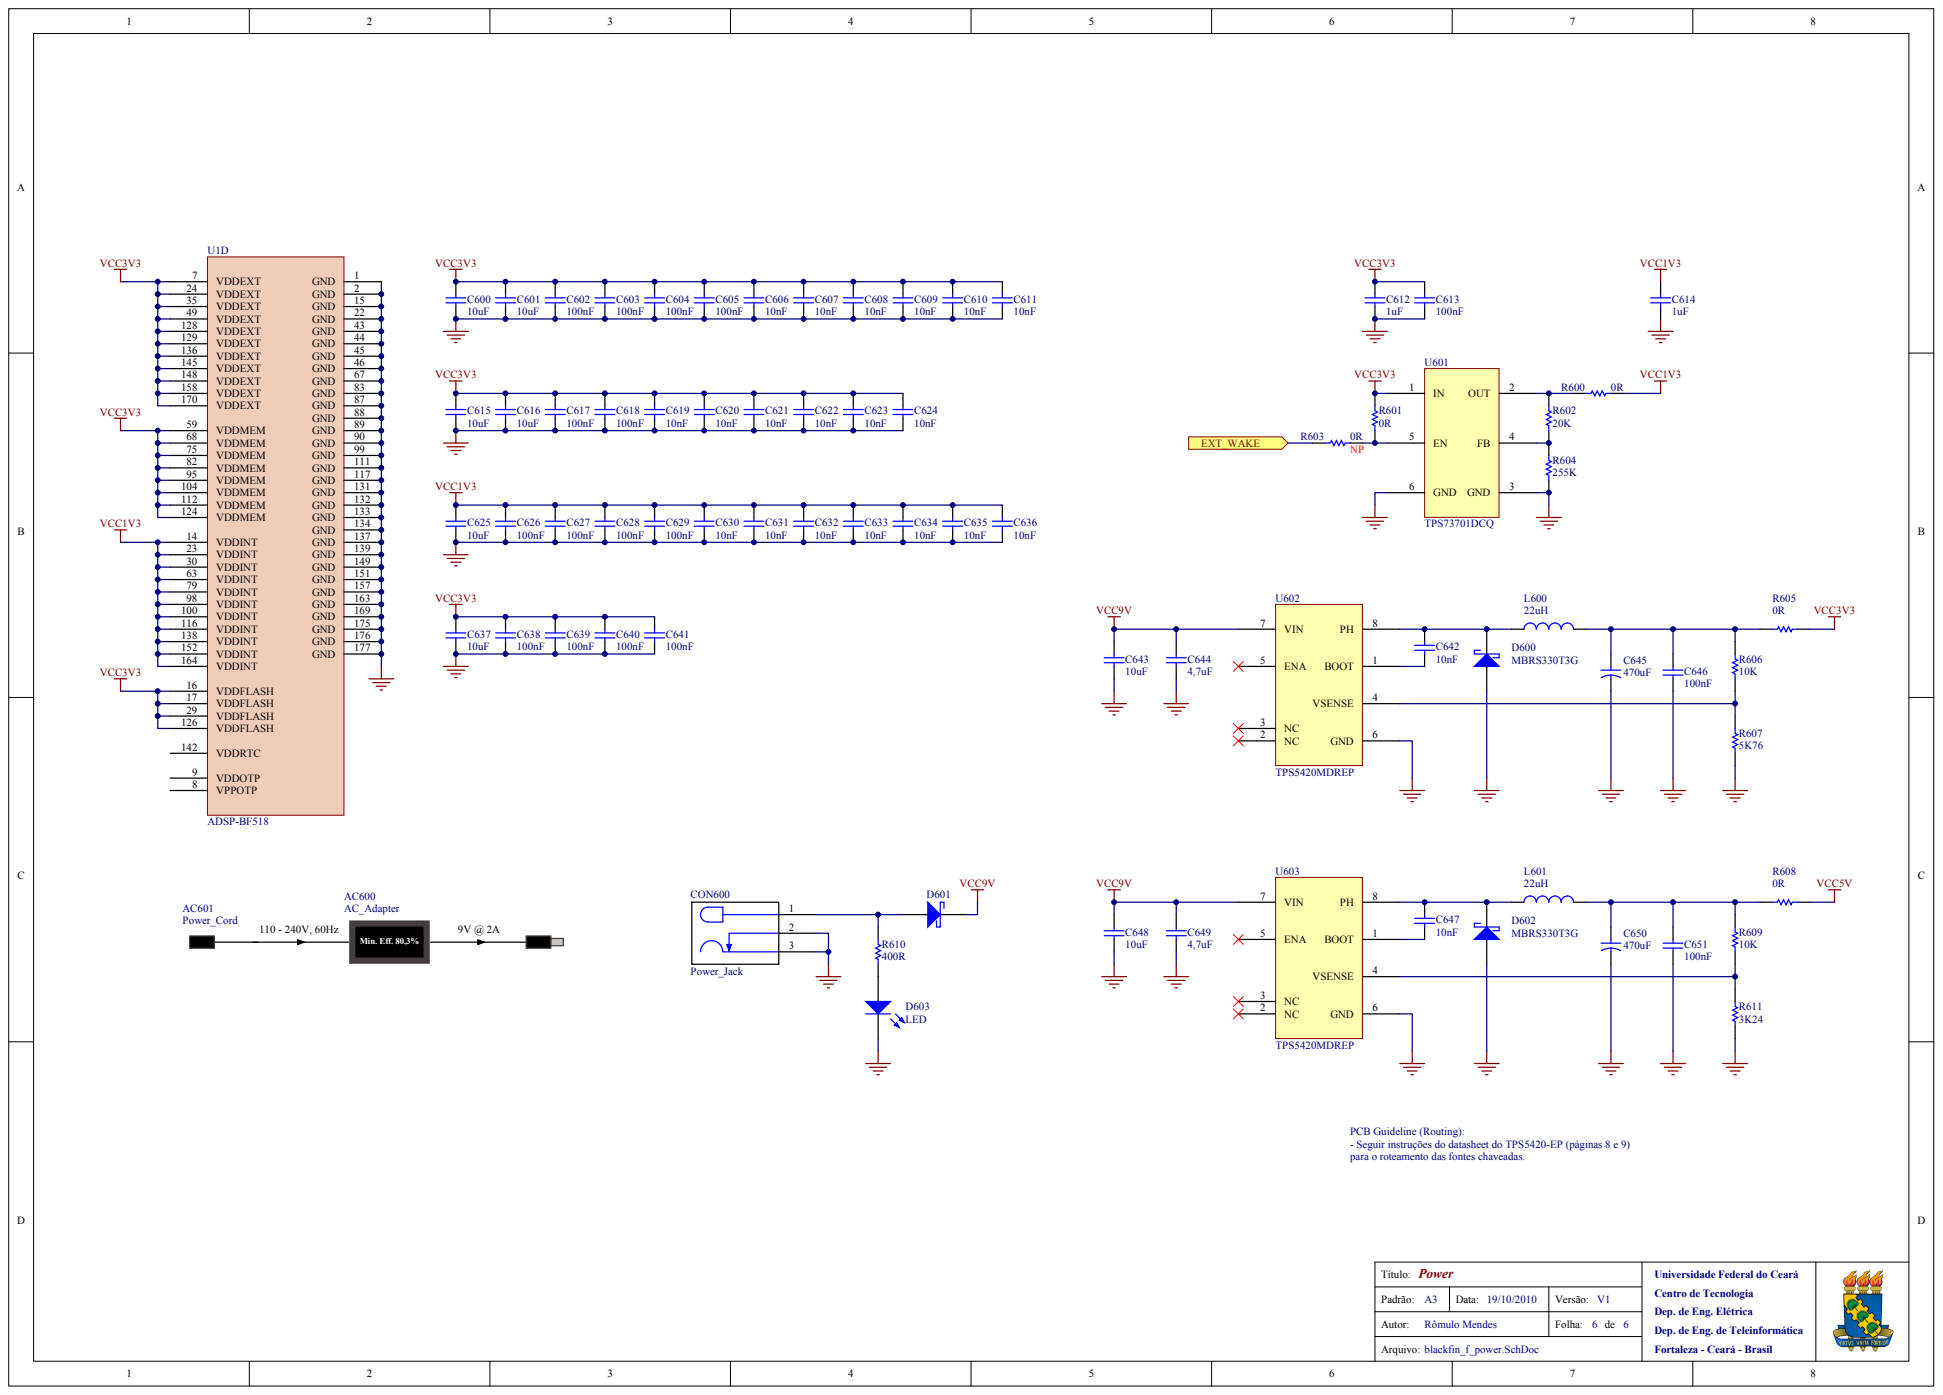
[picture p52: page 6]

VDDMEM 68
VDDMEM 75
VDDMEM 82 | 1 | VCC1V3
VDDMEM 95 | 7
VDDMEM 104 | 1
VDDMEM 112 | 2
VDDMEM 124 | 3
VDDINT 14 | 4

VDDINT 23 | 9
VDDINT 30 | 9
VDDINT 63 | 1
VDDINT 79 | 7
VDDINT 98 | 3

VDDINT 138 | 6
VDDINT 152 | 7
VDDINT 164

uideline (Routing):
uir instruções do datash
para o rotea

Power | U niversid a d e Feder al do Cea r á Centro de Tecnologia Dep. de Eng. Elétrica Dep. de E ng. de Teleinform ática

: A | Data:

Autor: Rô mulo Me ndes | | Folh a : de

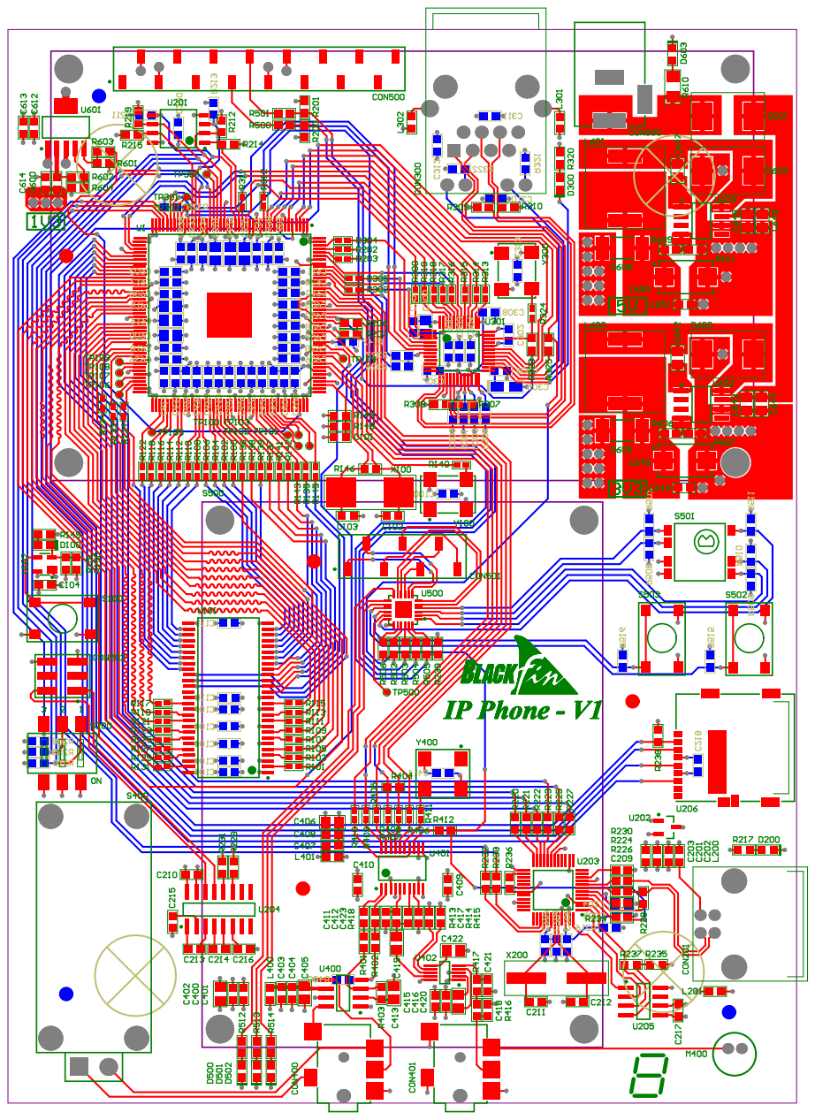
[picture p53: page 7]
