julioamerico/blackfin-ip-phone-hw/pesquisa/connectors/045138008010890+.pdf

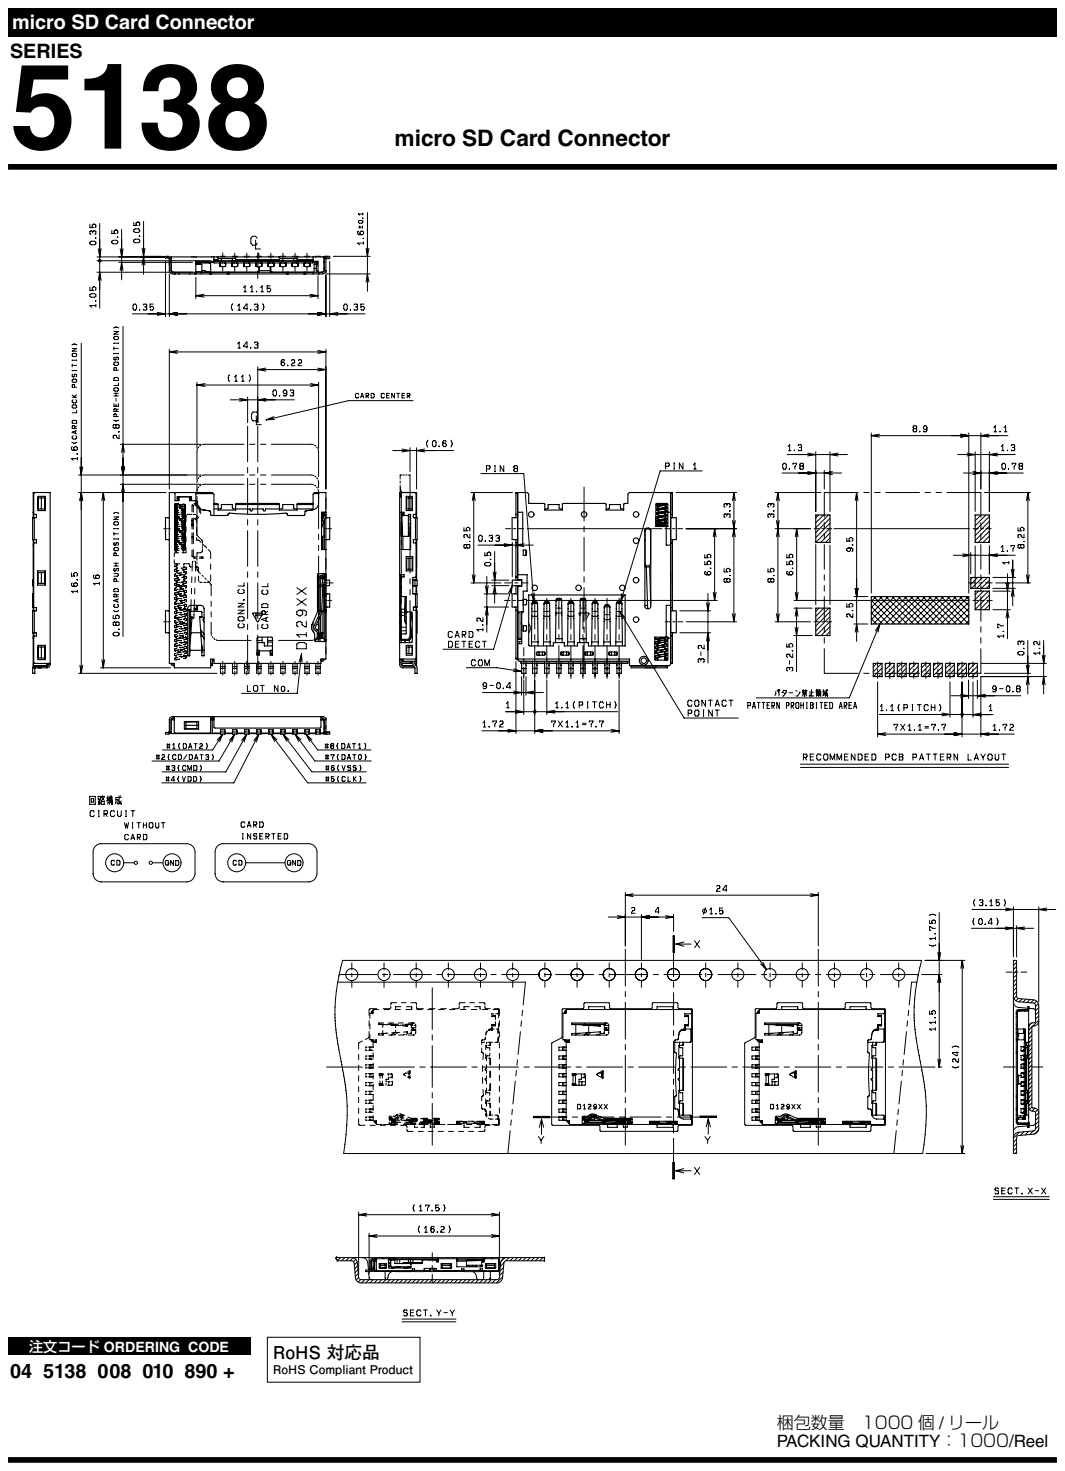
[picture p54: page 1]

micro SD Card Connector

SERIES
5138 micro SD Card Connector

注文コード ORDERING CODE

RoHS 対応品
RoHS Compliant Product

梱包数量　1000 個 / リール
PACKING QUANTITY：1000/Reel
