julioamerico/blackfin-ip-phone-hw/pesquisa/connectors/61729-0010BLF.pdf

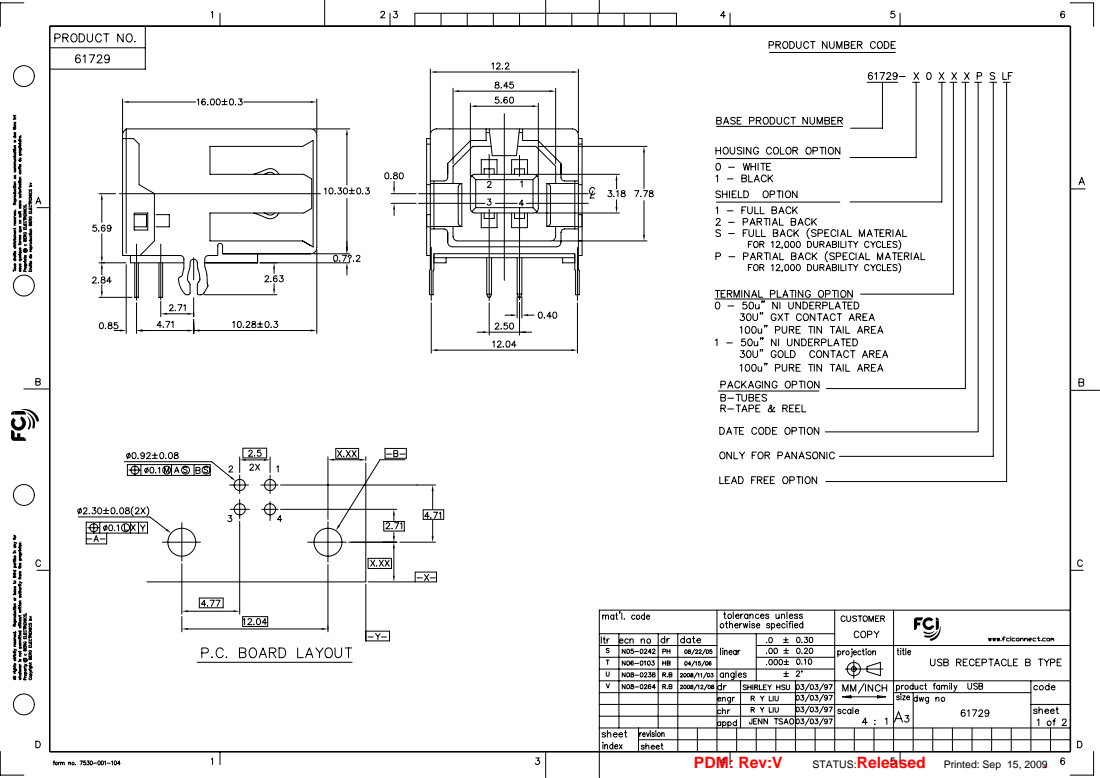
[picture p55: page 1]
PDM: Rev:V; Released; . STATUS:; Printed: Sep 15, 2009

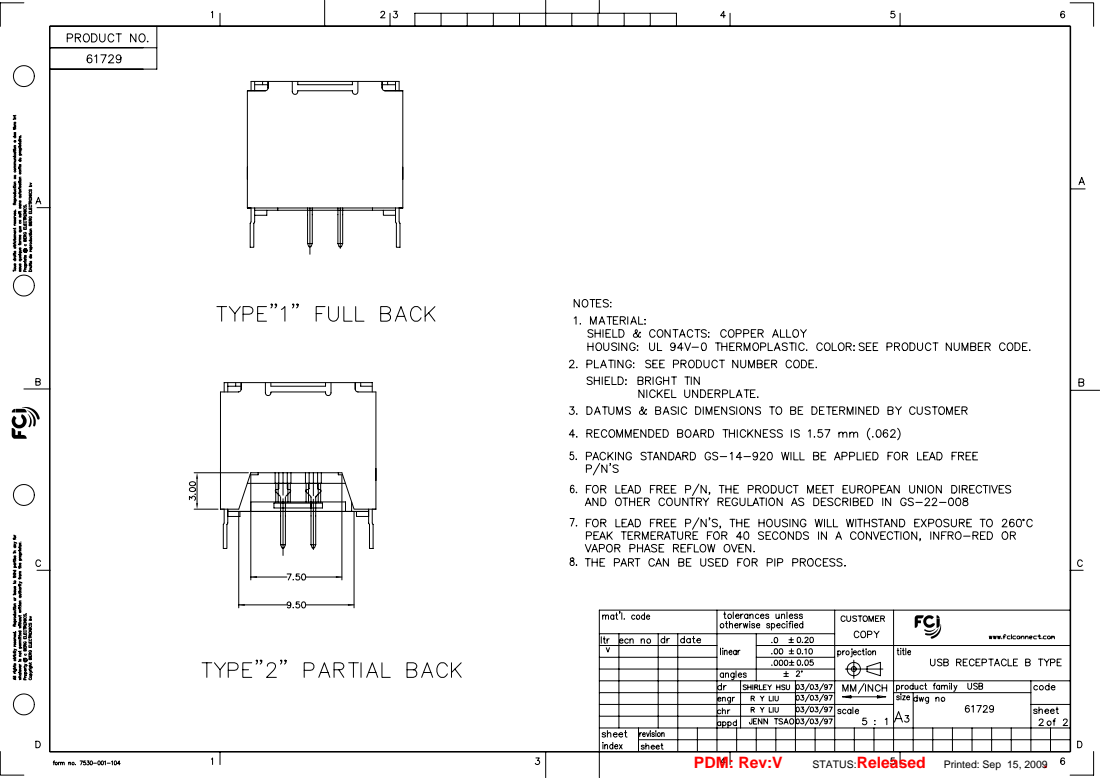
[picture p56: page 2]
PDM: Rev:V; Released; . STATUS:; Printed: Sep 15, 2009
