julioamerico/blackfin-ip-phone-hw/pesquisa/miscellaneous/FT2232D/Reference Design/Two Port USB to RS232.pdf

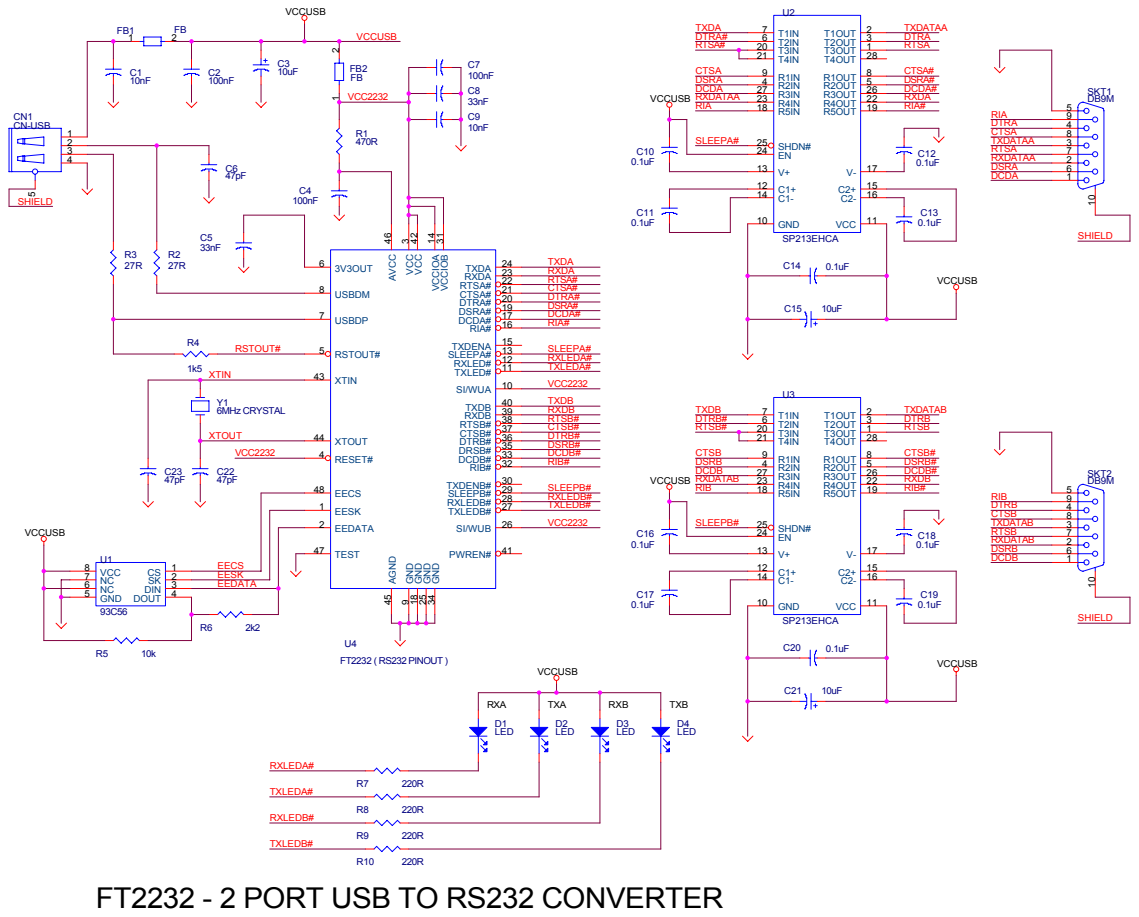
[picture p57: page 1]

FT2232 - 2 PORT USB TO RS232 CONVERTER
