julioamerico/blackfin-ip-phone-hw/pesquisa/processor/ADSP_BF518F_EZ_Board_Design_Reference_Info(1_0)/assembly/ASSYDWGBOT.pdf

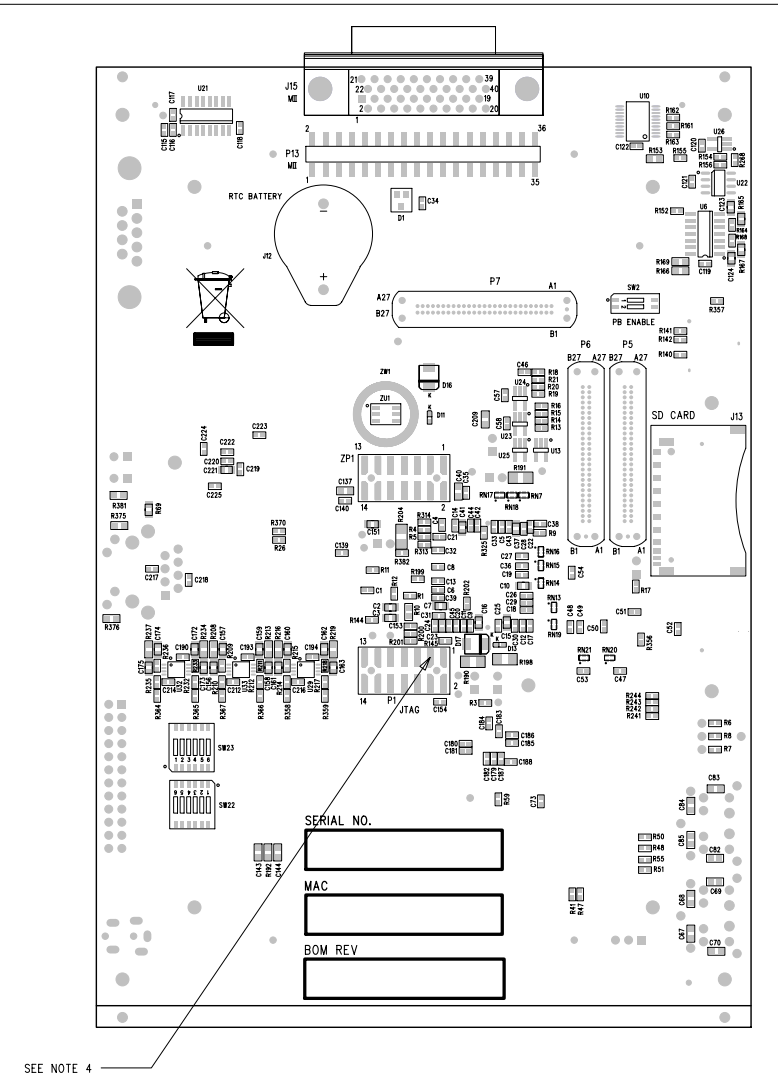
[picture p58: page 1]
