julioamerico/blackfin-ip-phone-hw/pesquisa/processor/ADSP_BF518F_EZ_Board_Design_Reference_Info(1_0)/assembly/ASSYDWGTOP.pdf

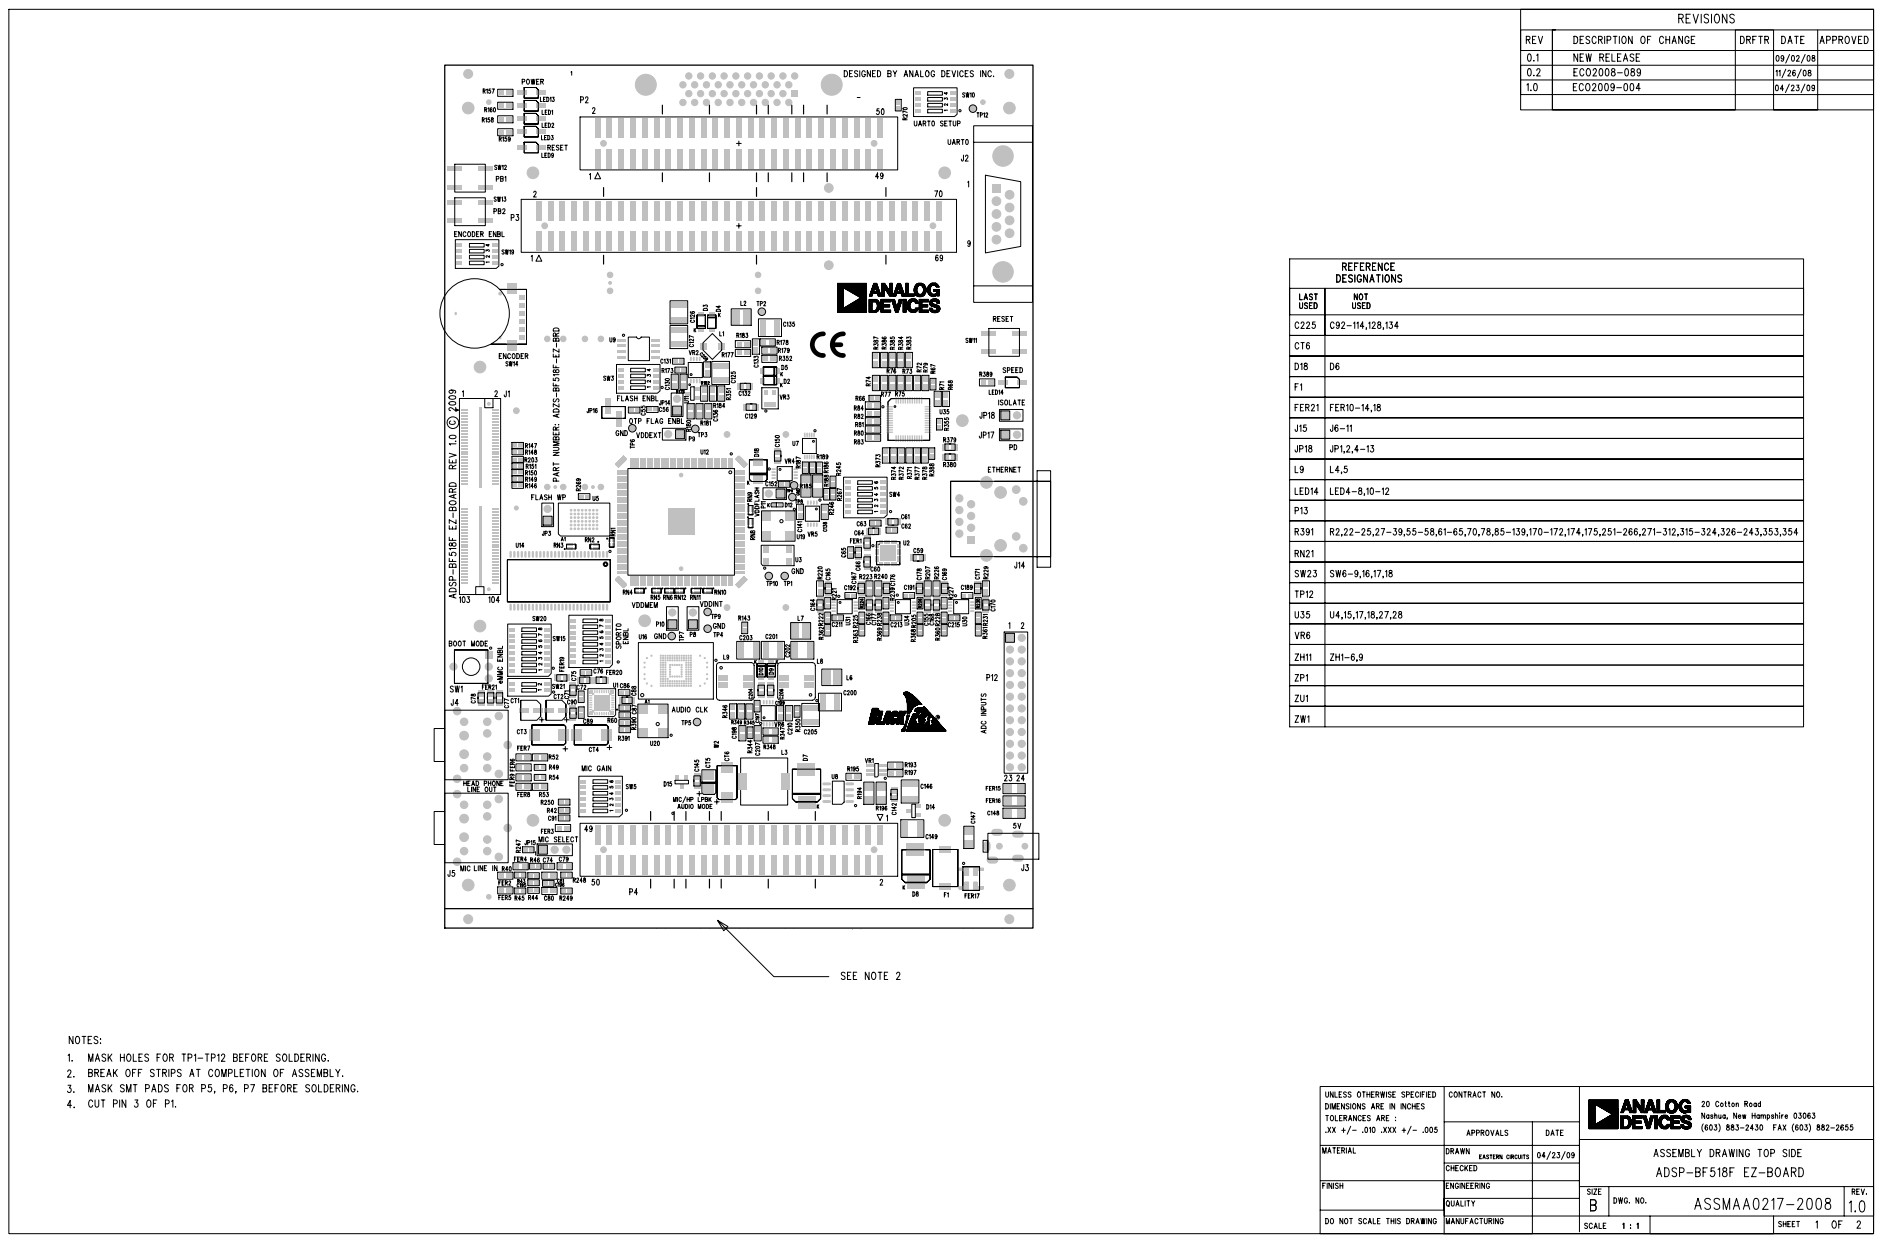
[picture p59: page 1]
