julioamerico/blackfin-ip-phone-hw/pesquisa/processor/ADSP_BF518F_EZ_Board_Design_Reference_Info(1_0)/assembly/SSCREENBOTmirror.pdf

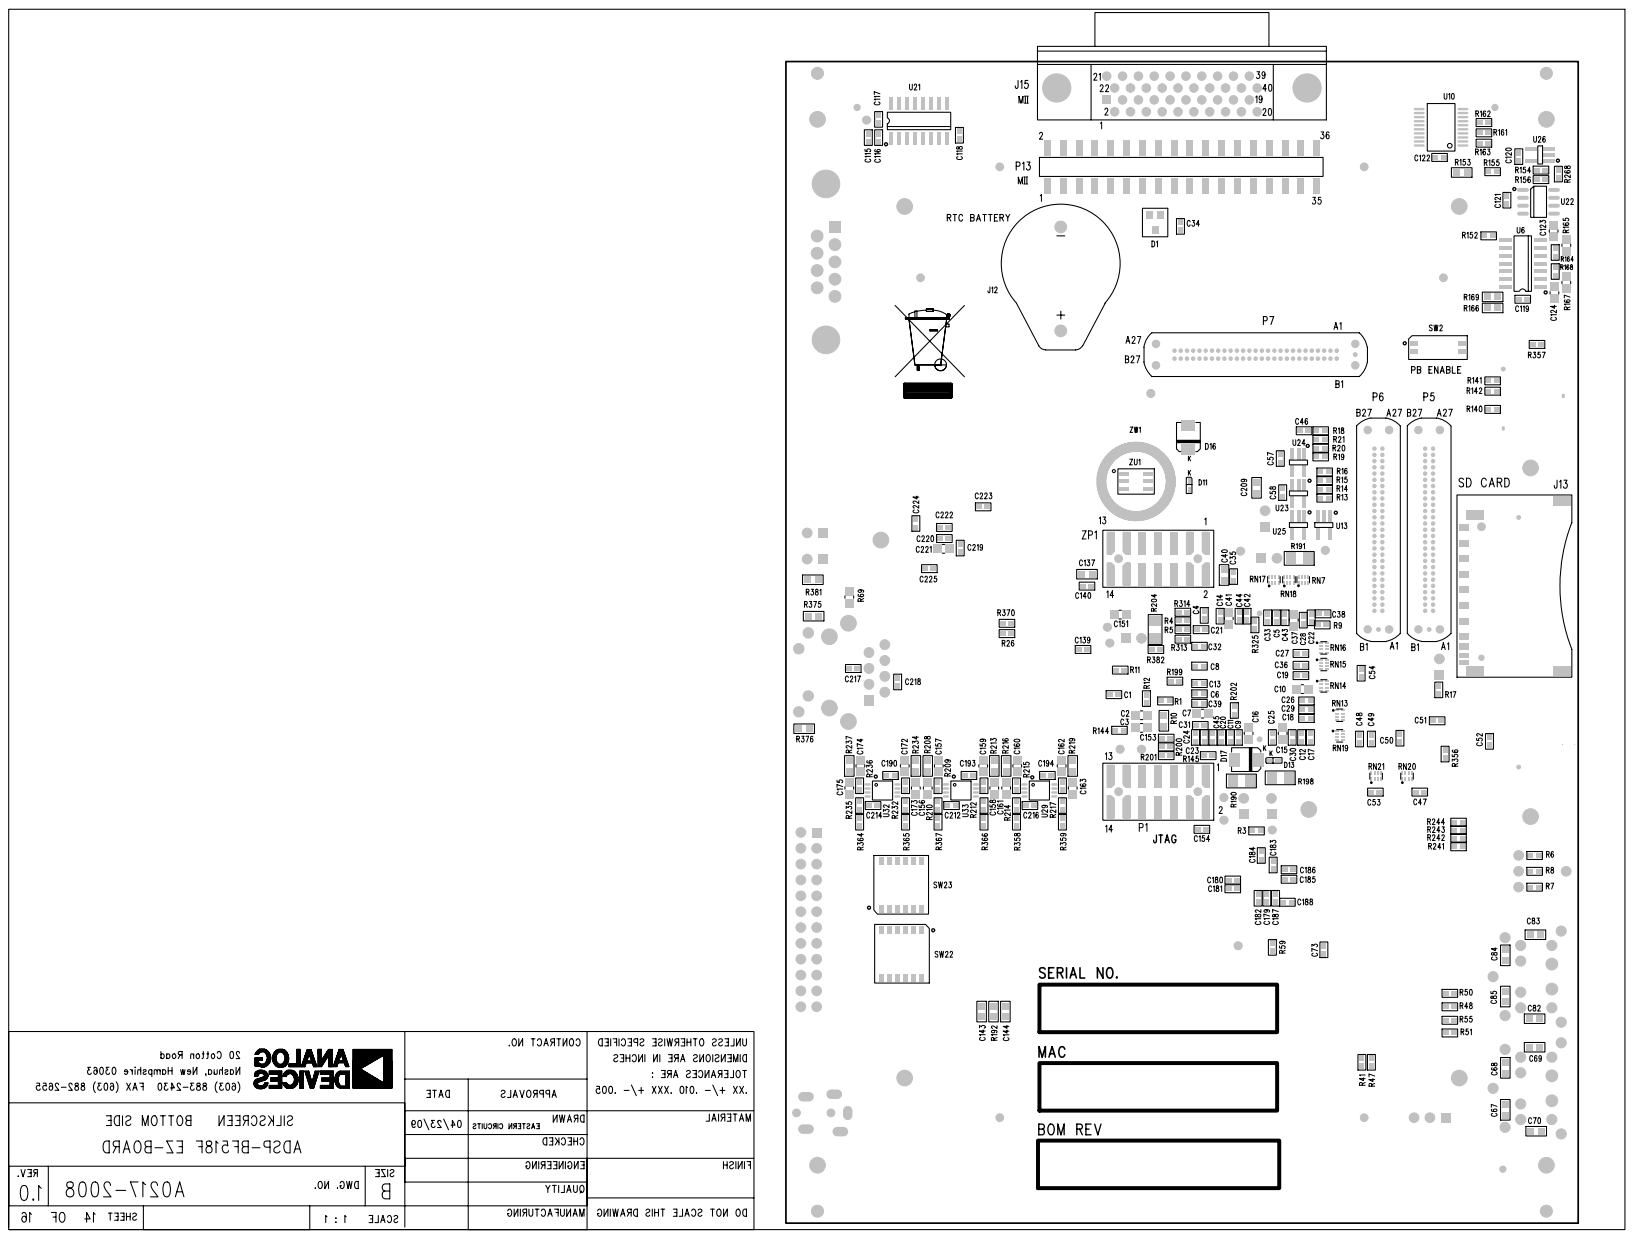
[picture p61: page 1]
