julioamerico/blackfin-ip-phone-hw/pesquisa/processor/ADSP_BF518F_EZ_Board_Design_Reference_Info(1_0)/layout/A0217-2008 REV 1.0 PDF.PDF

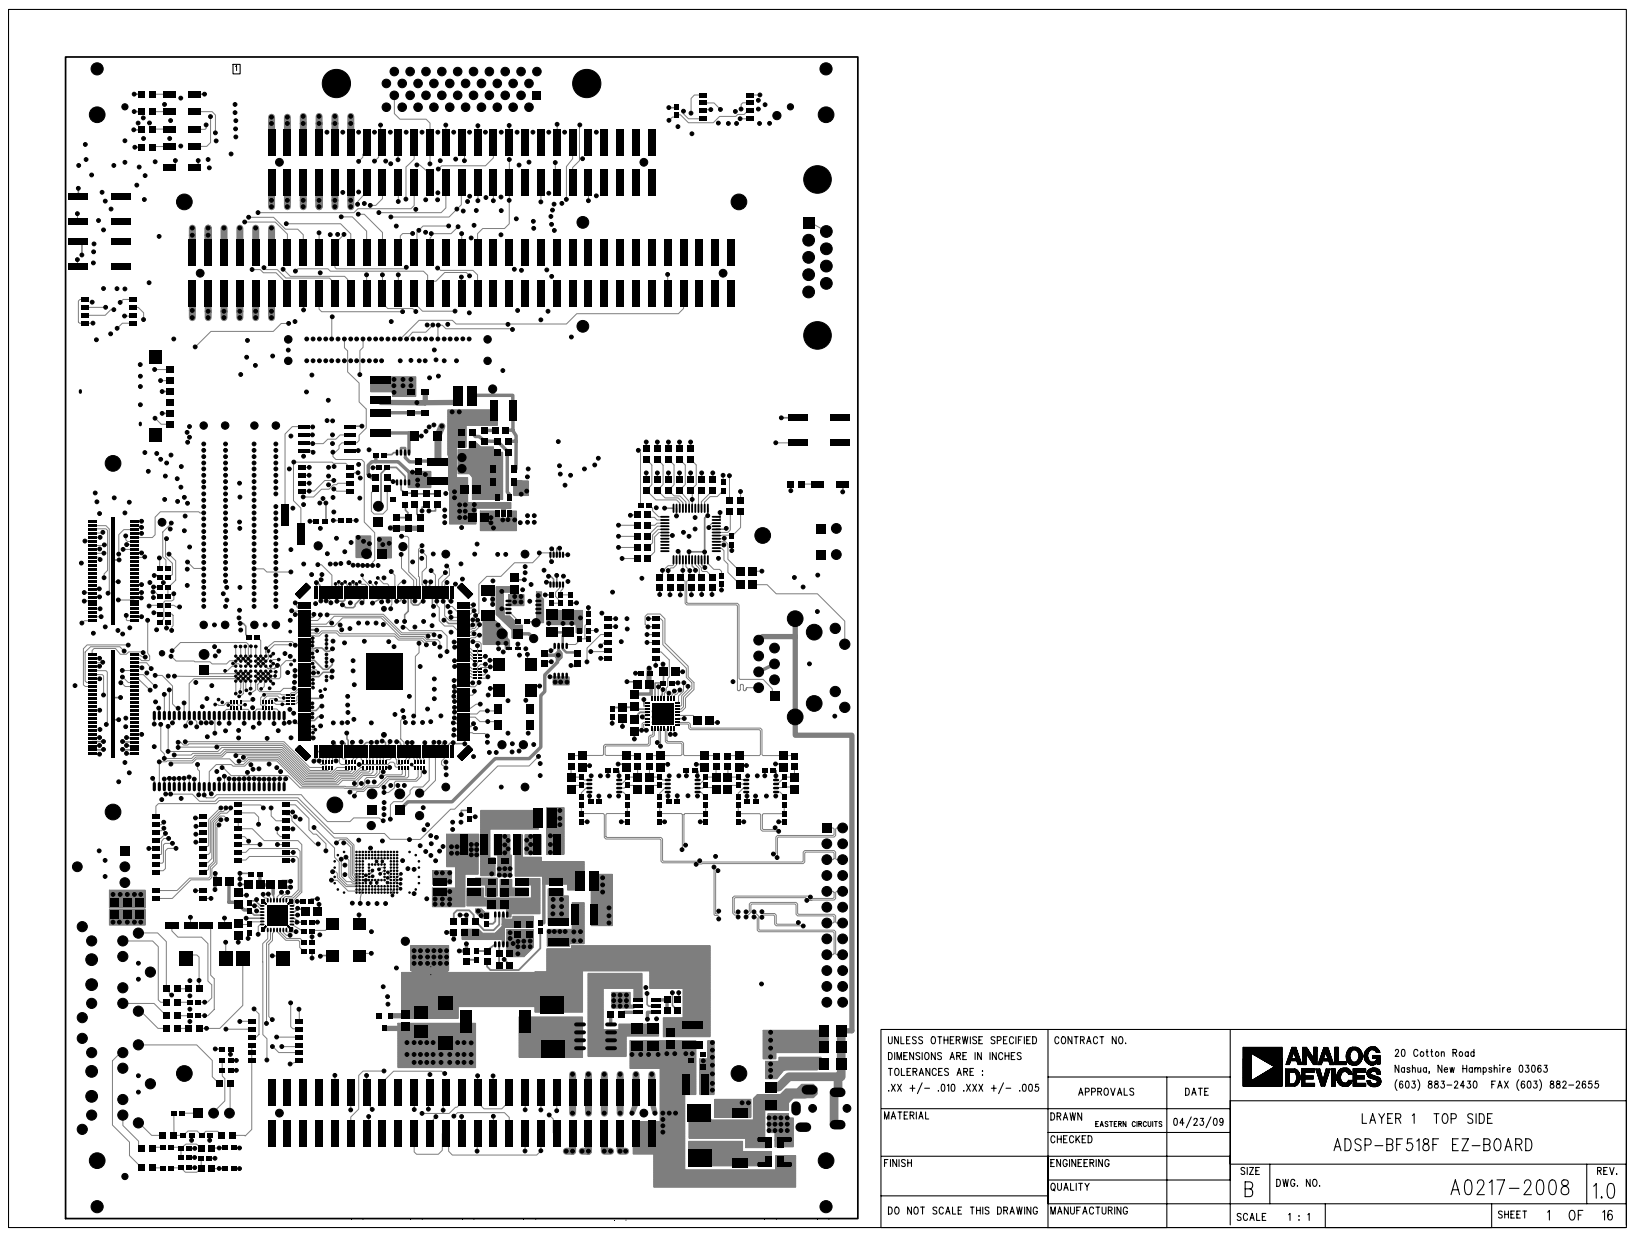
[picture p64: page 6]

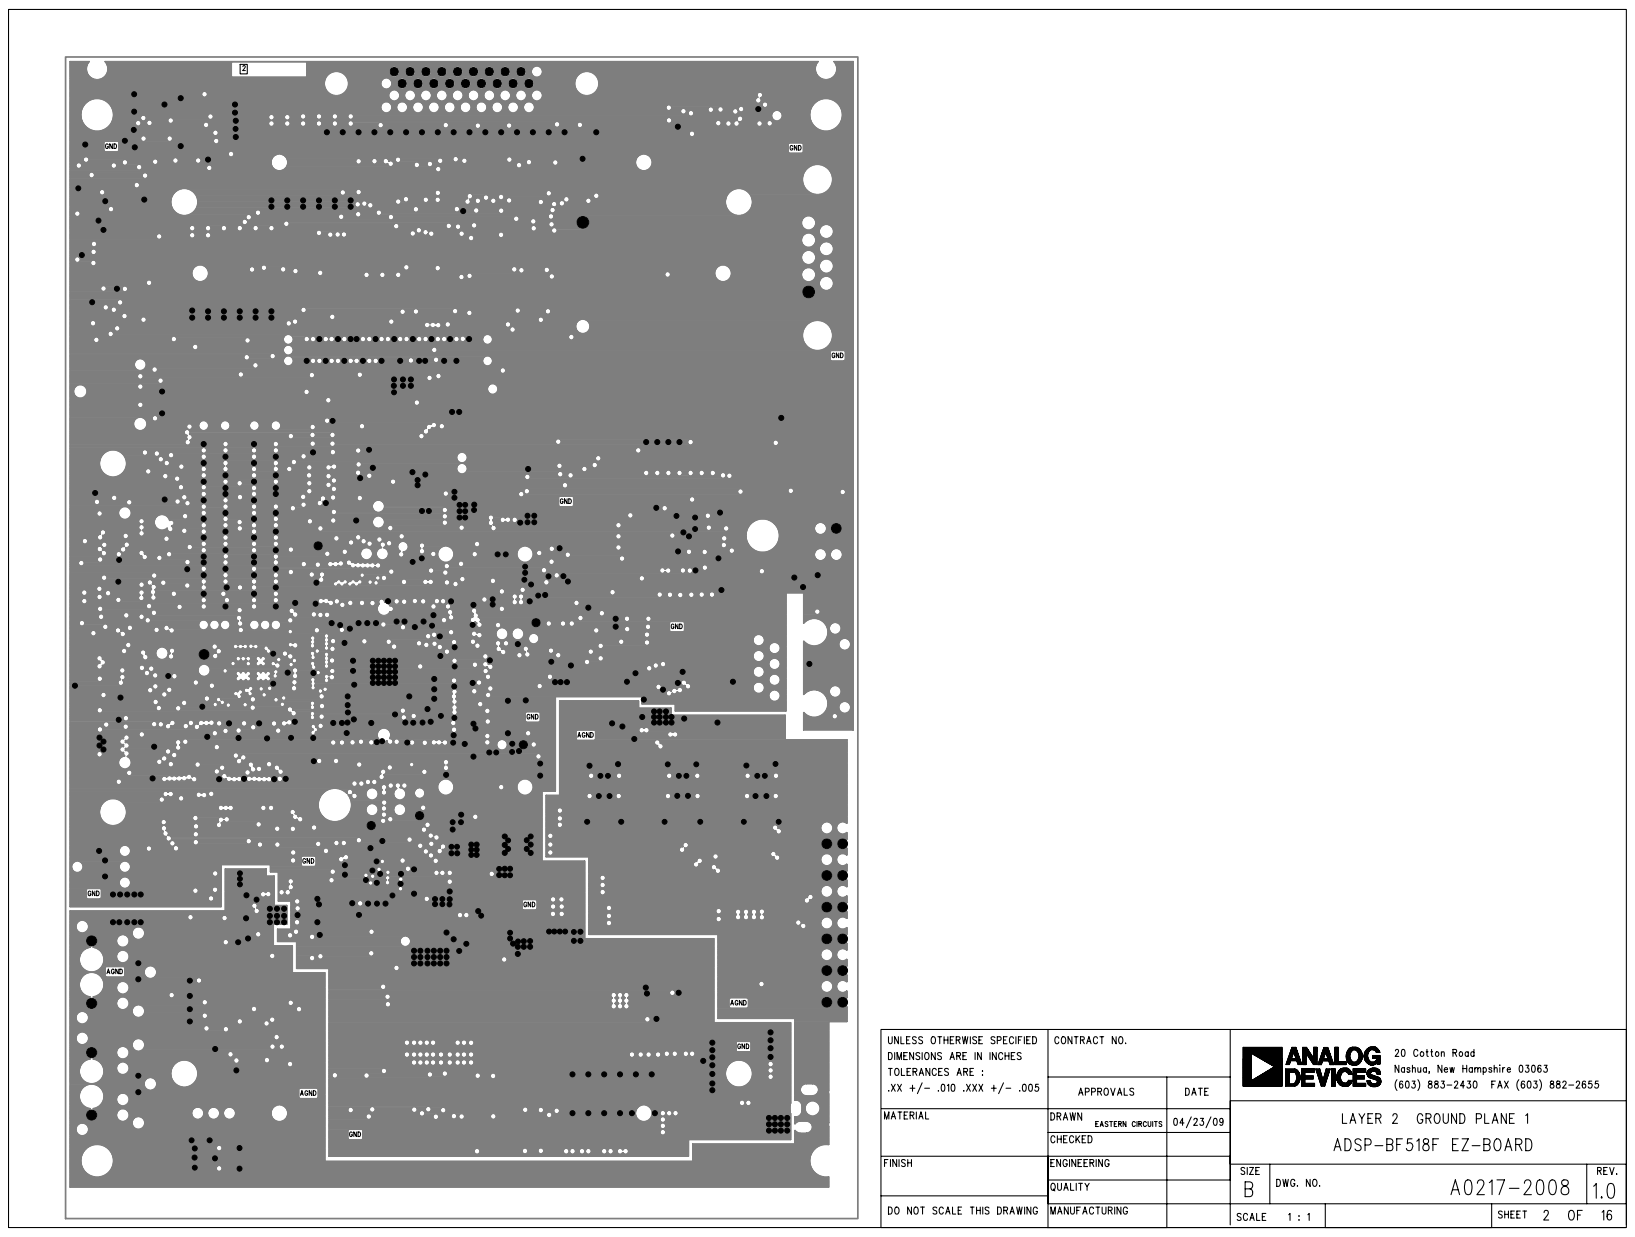
[picture p65: page 7]

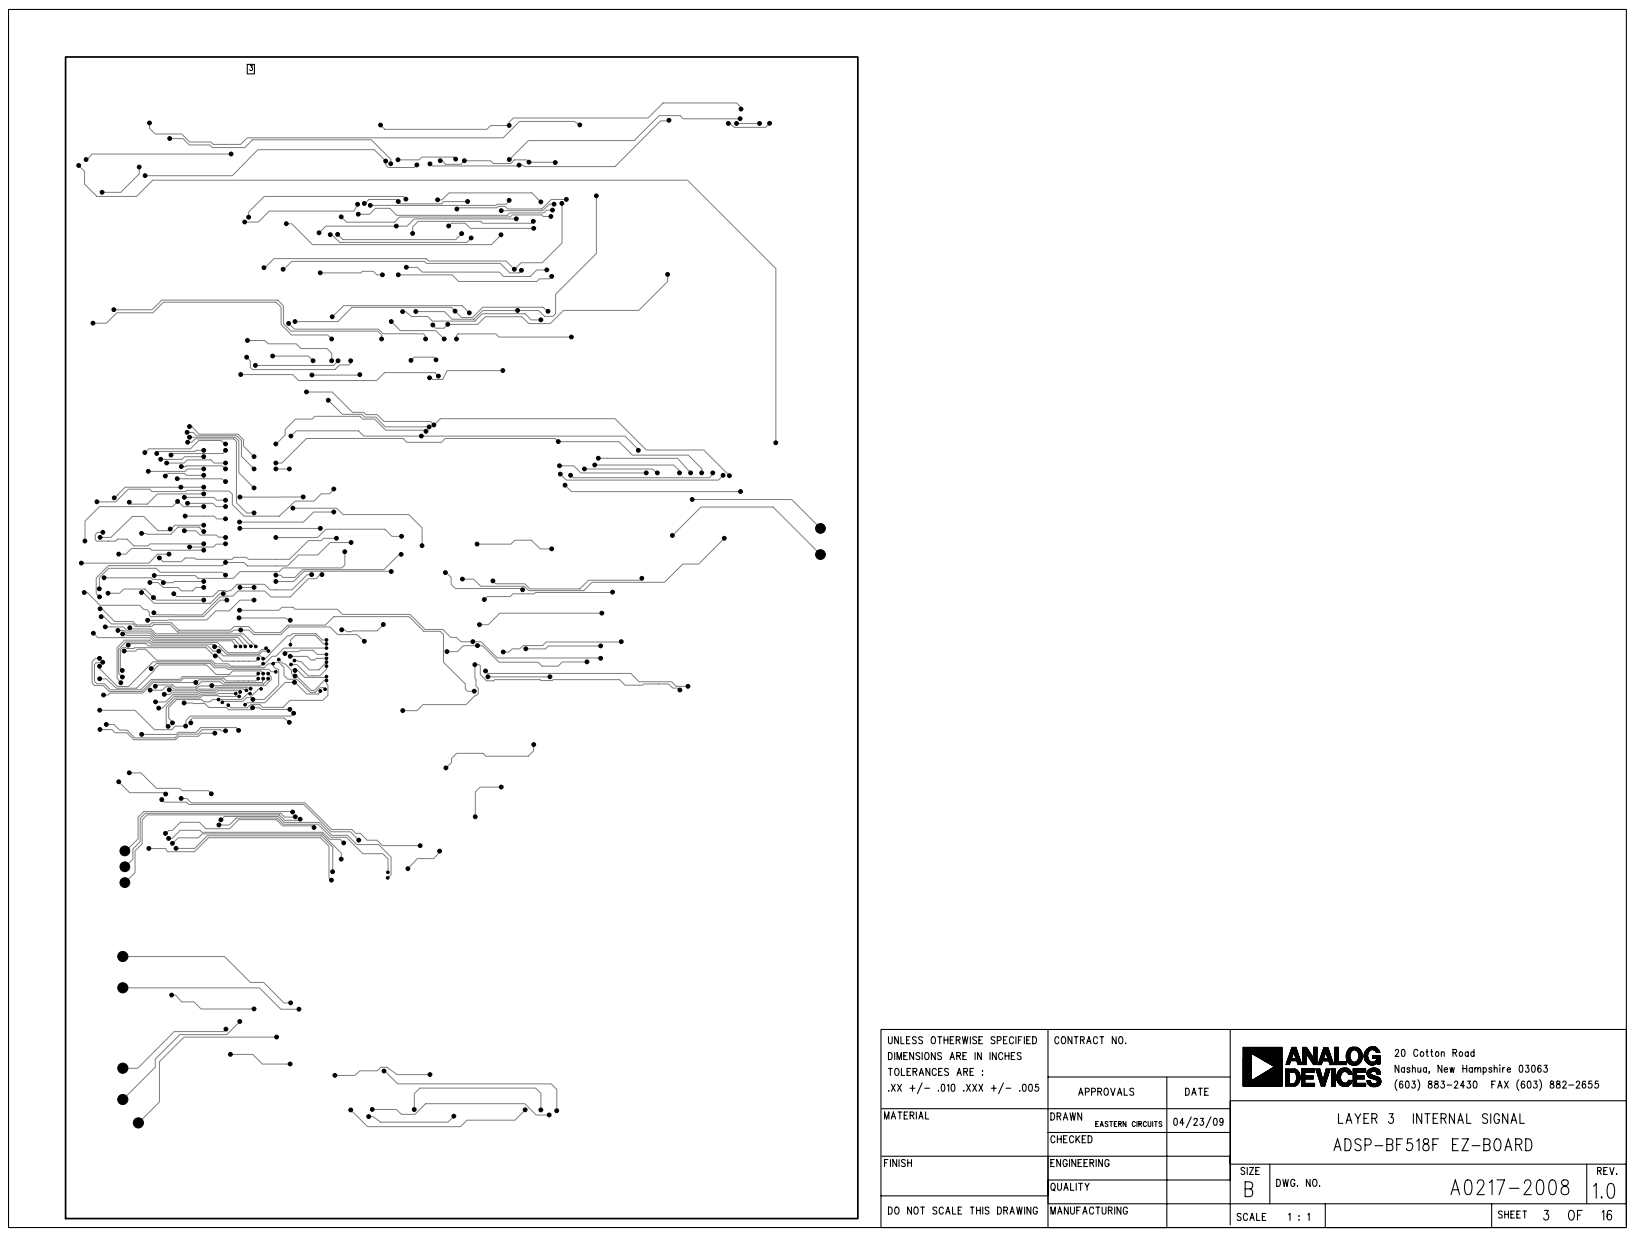
[picture p66: page 8]

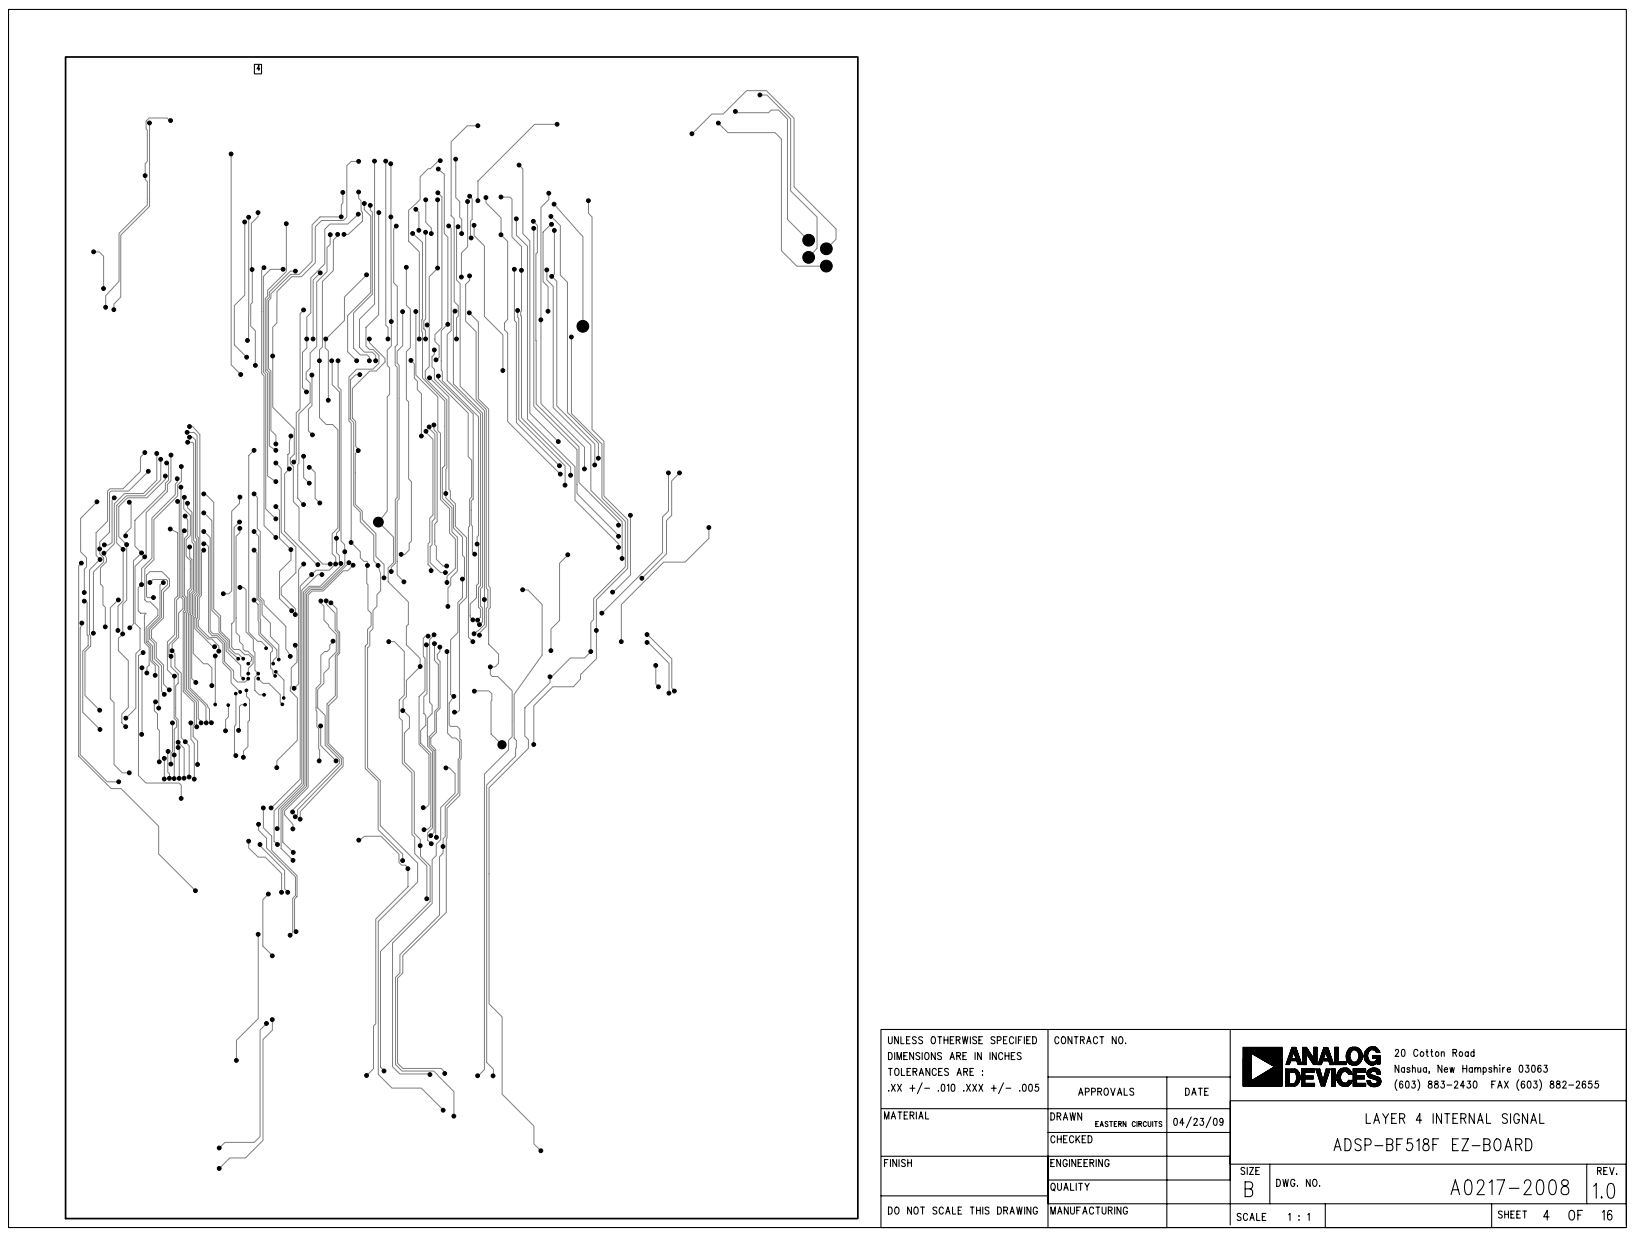
[picture p67: page 9]

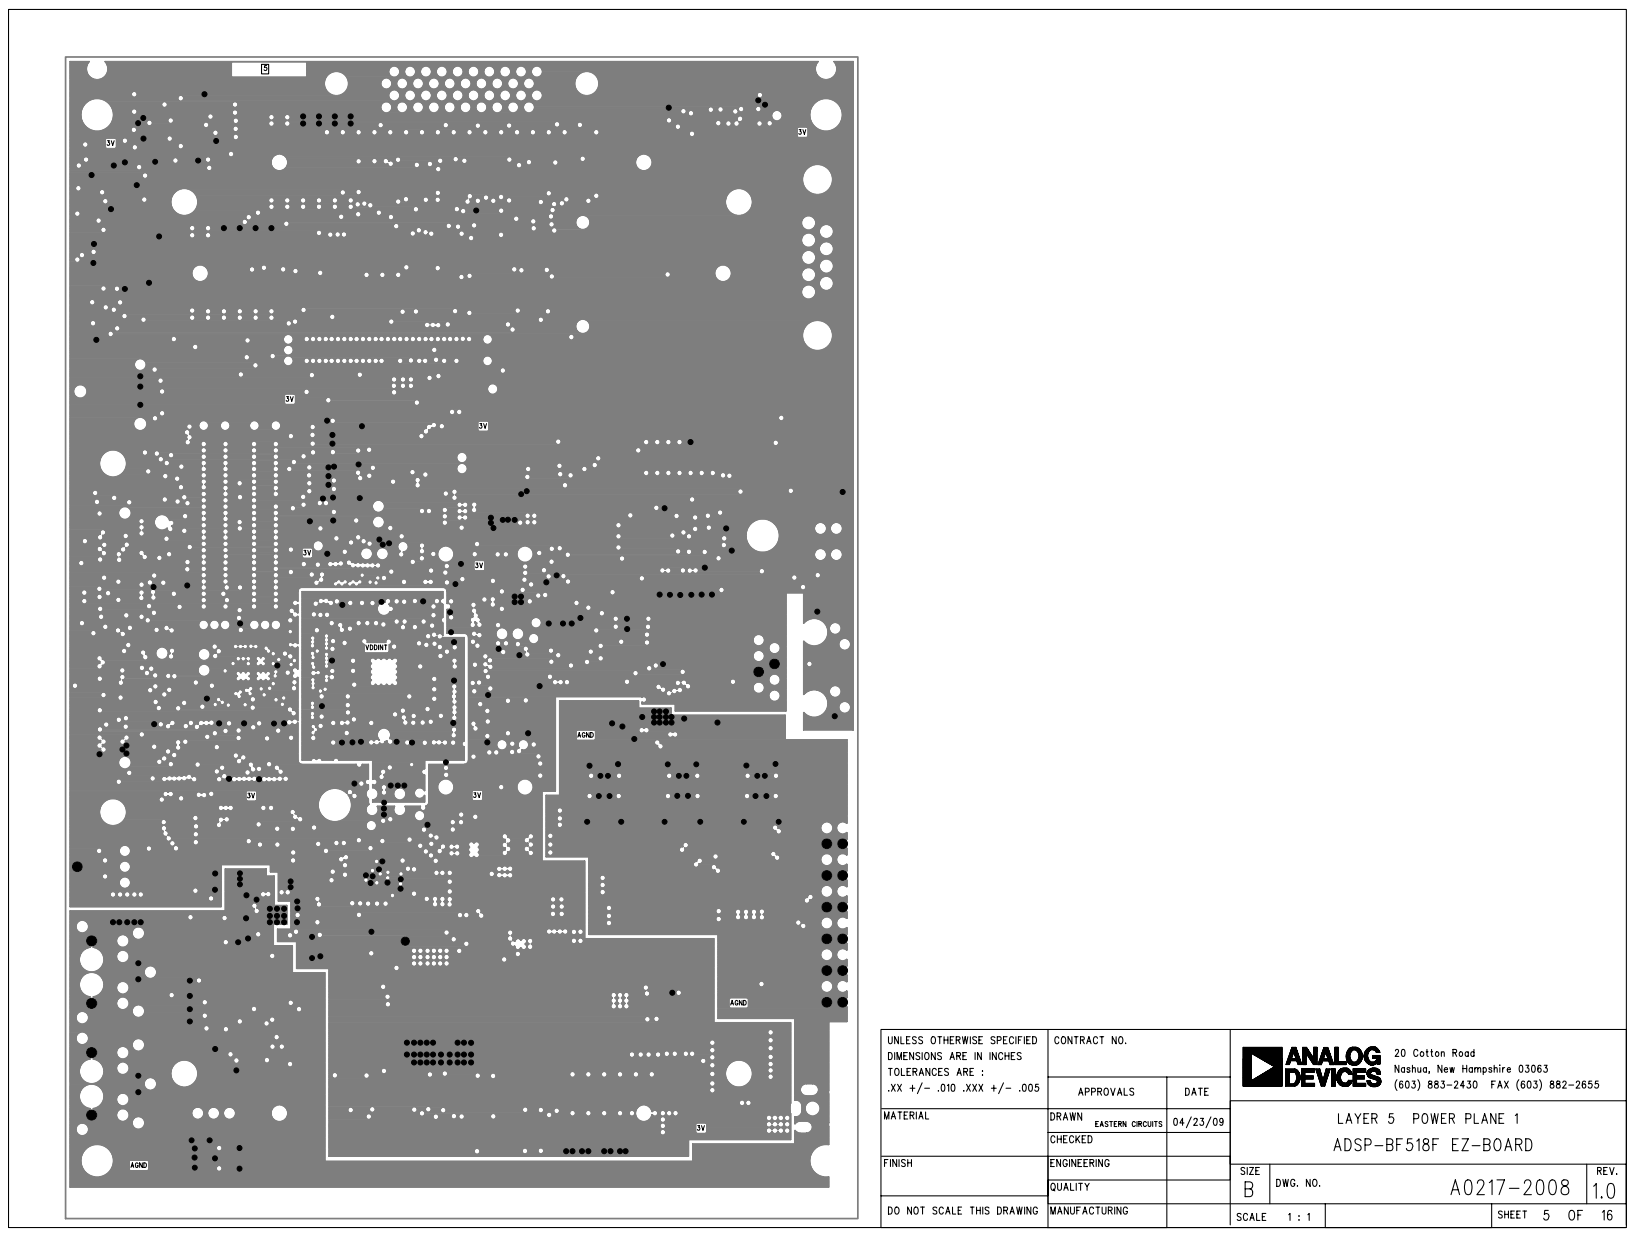
[picture p68: page 10]

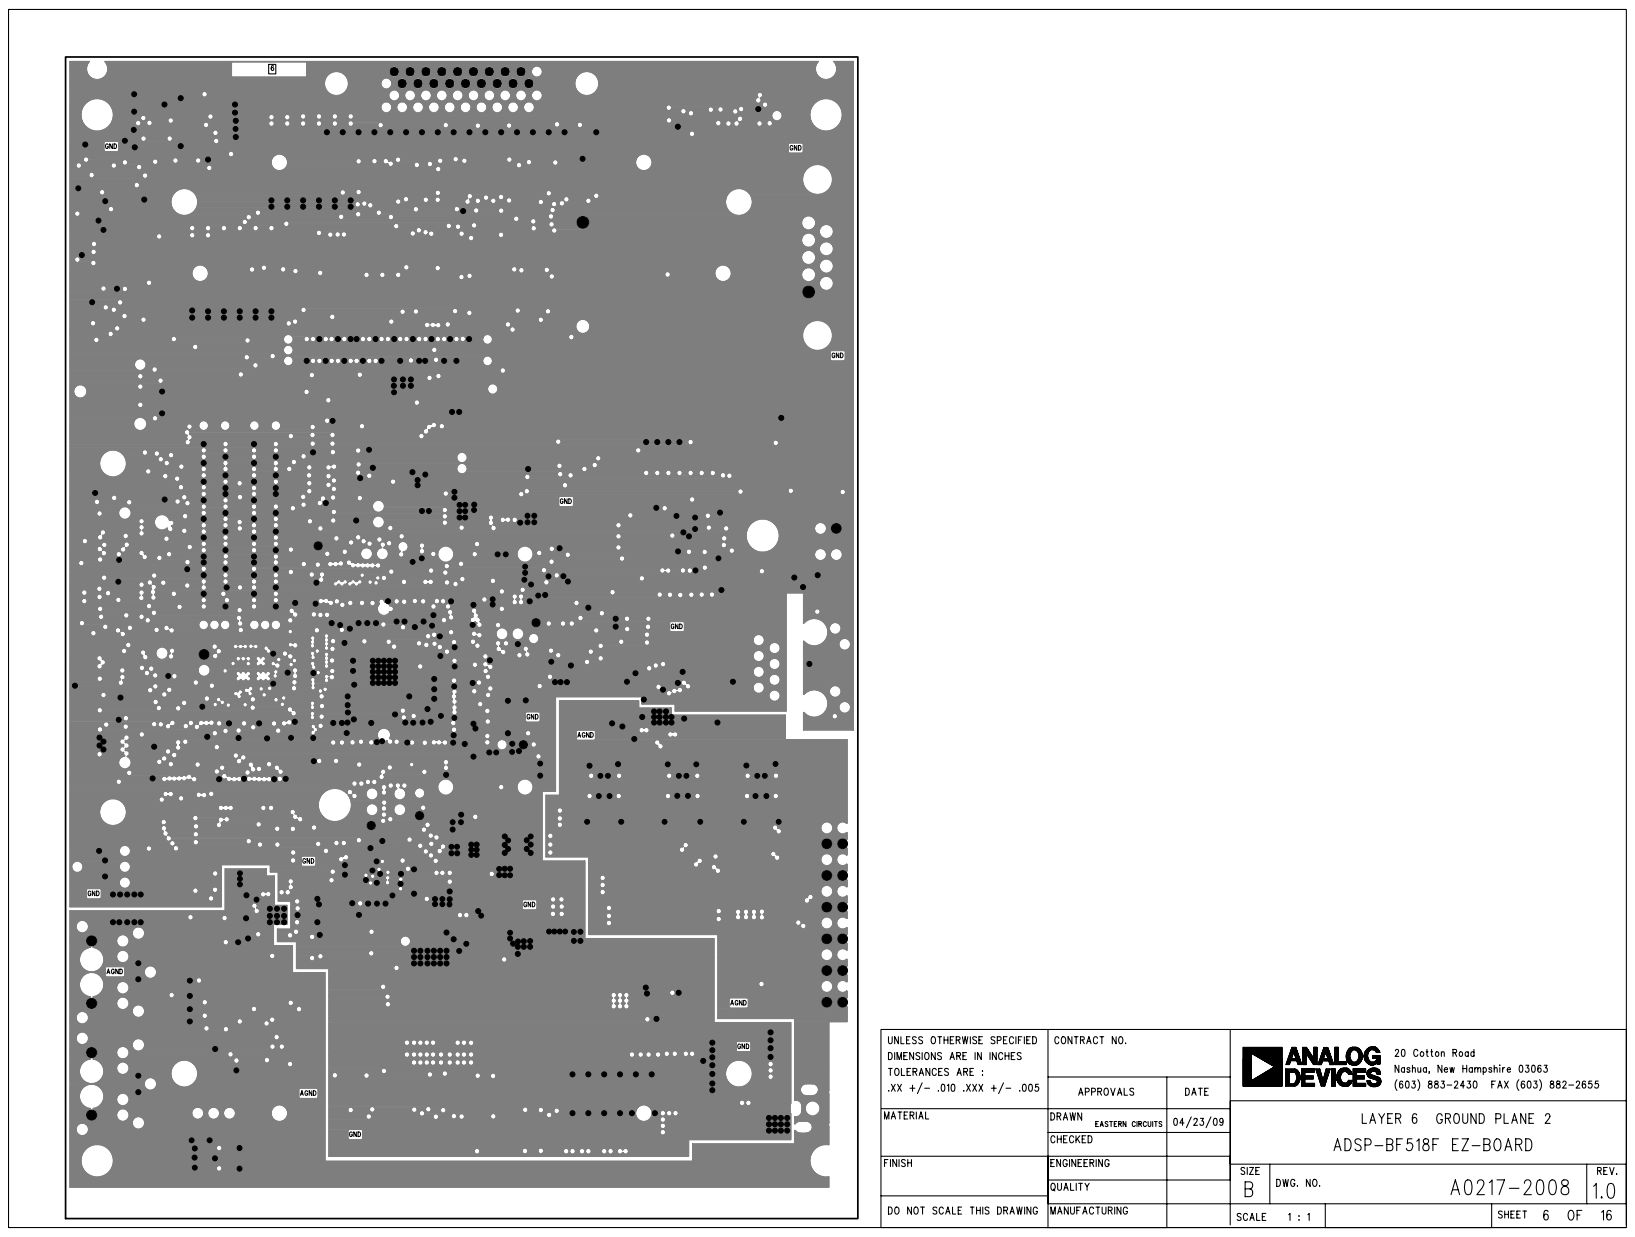
[picture p69: page 11]

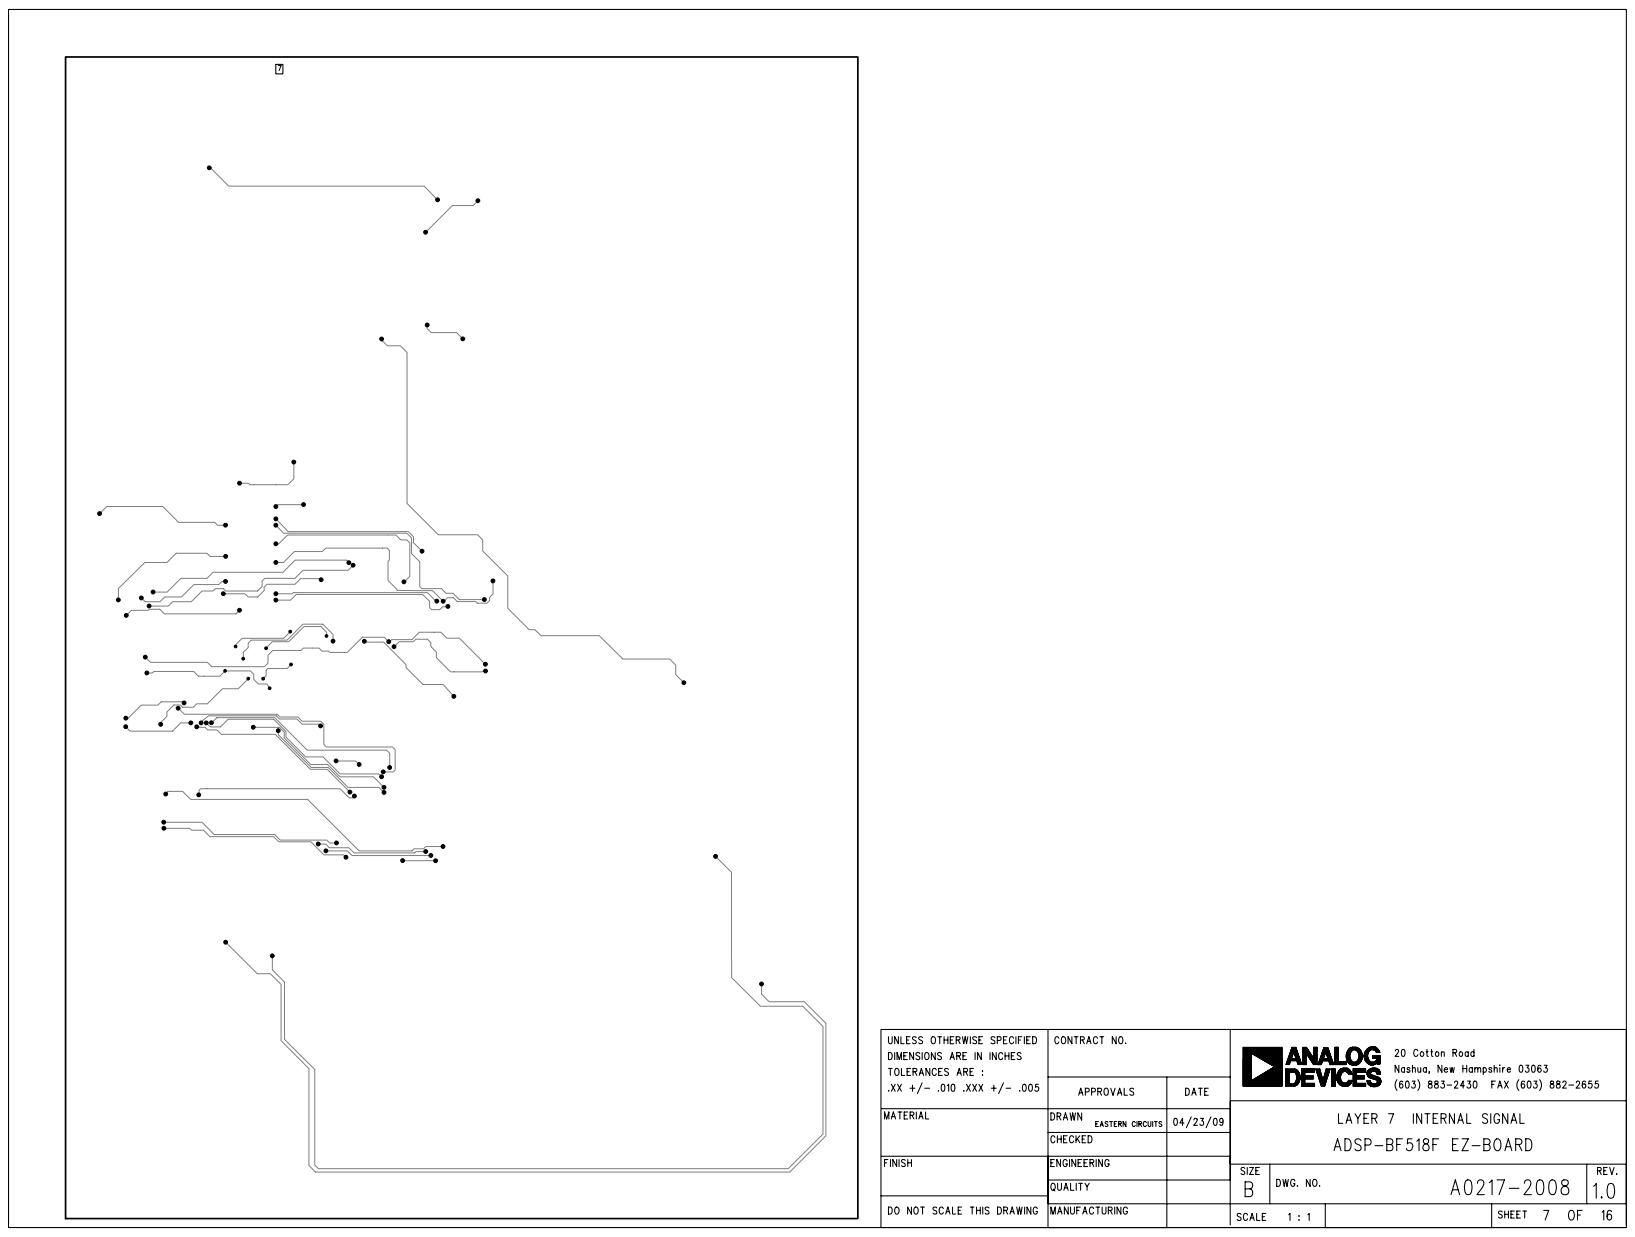
[picture p70: page 12]

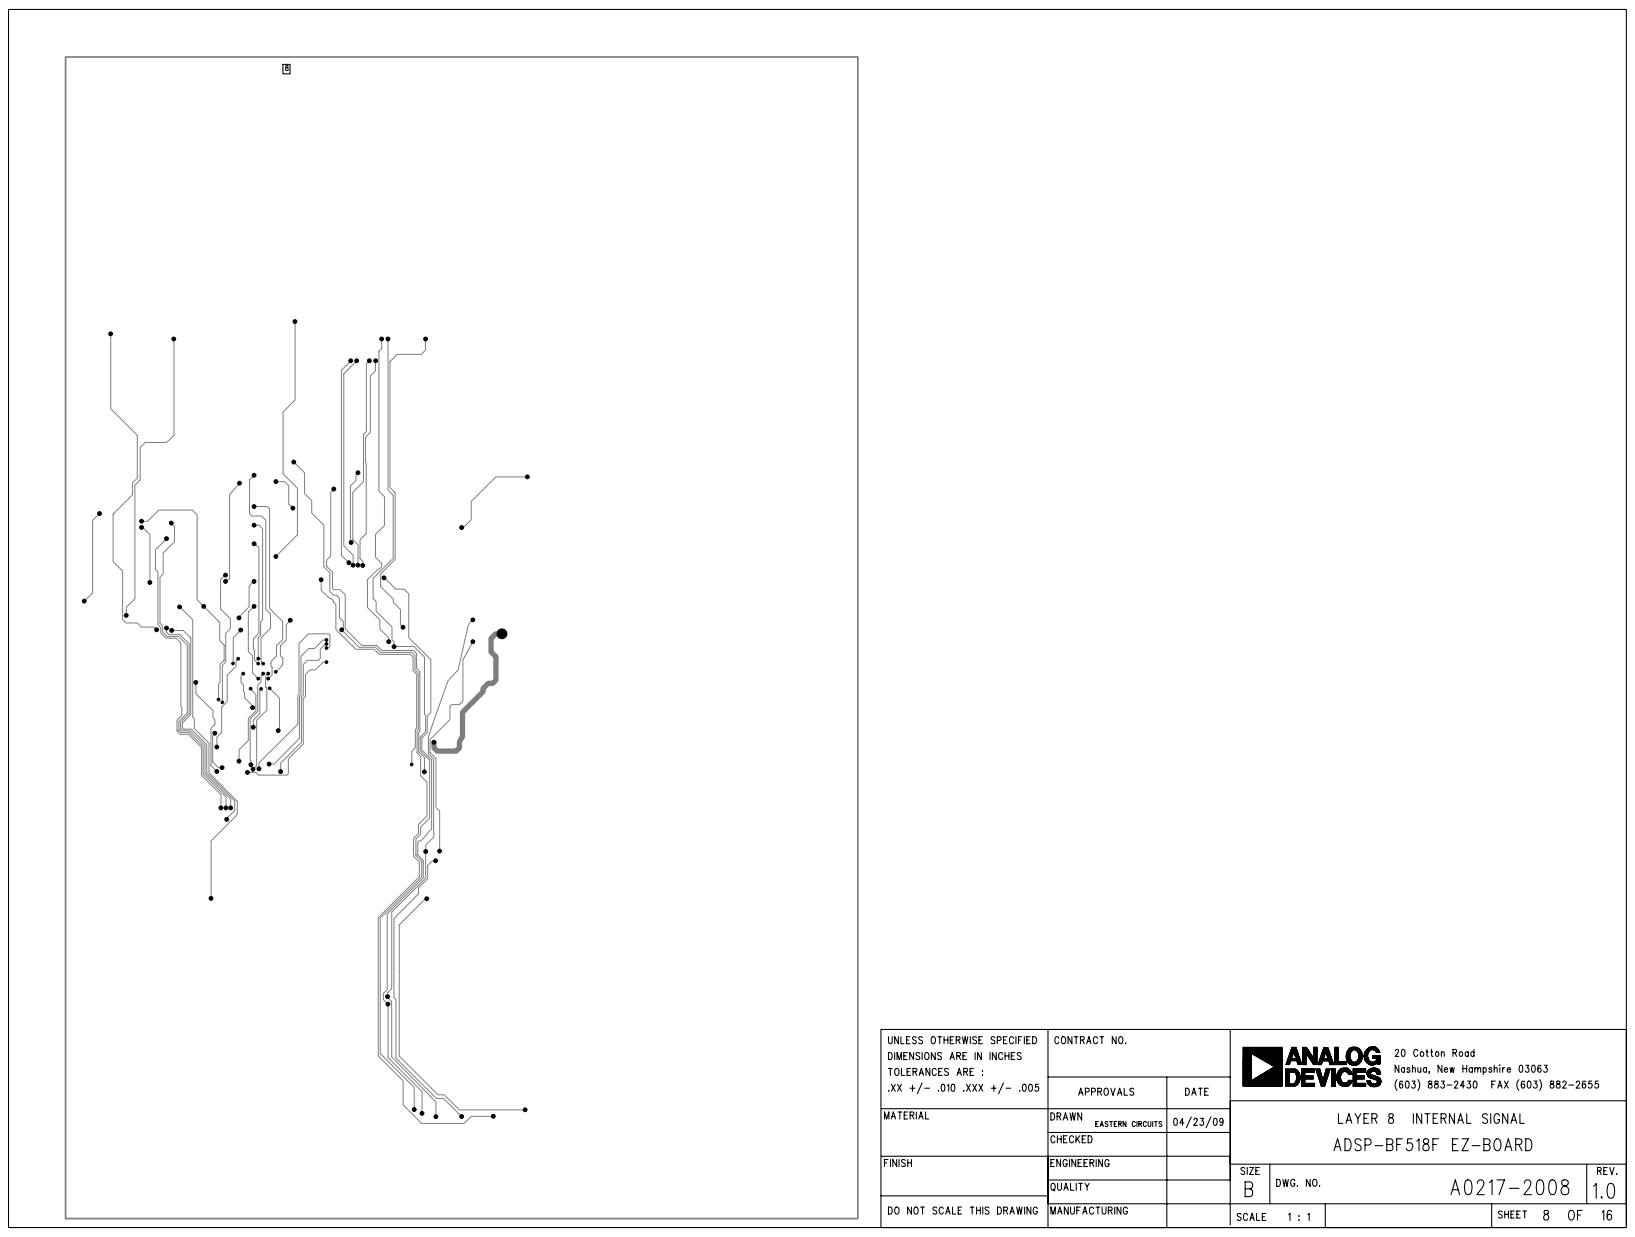
[picture p71: page 13]

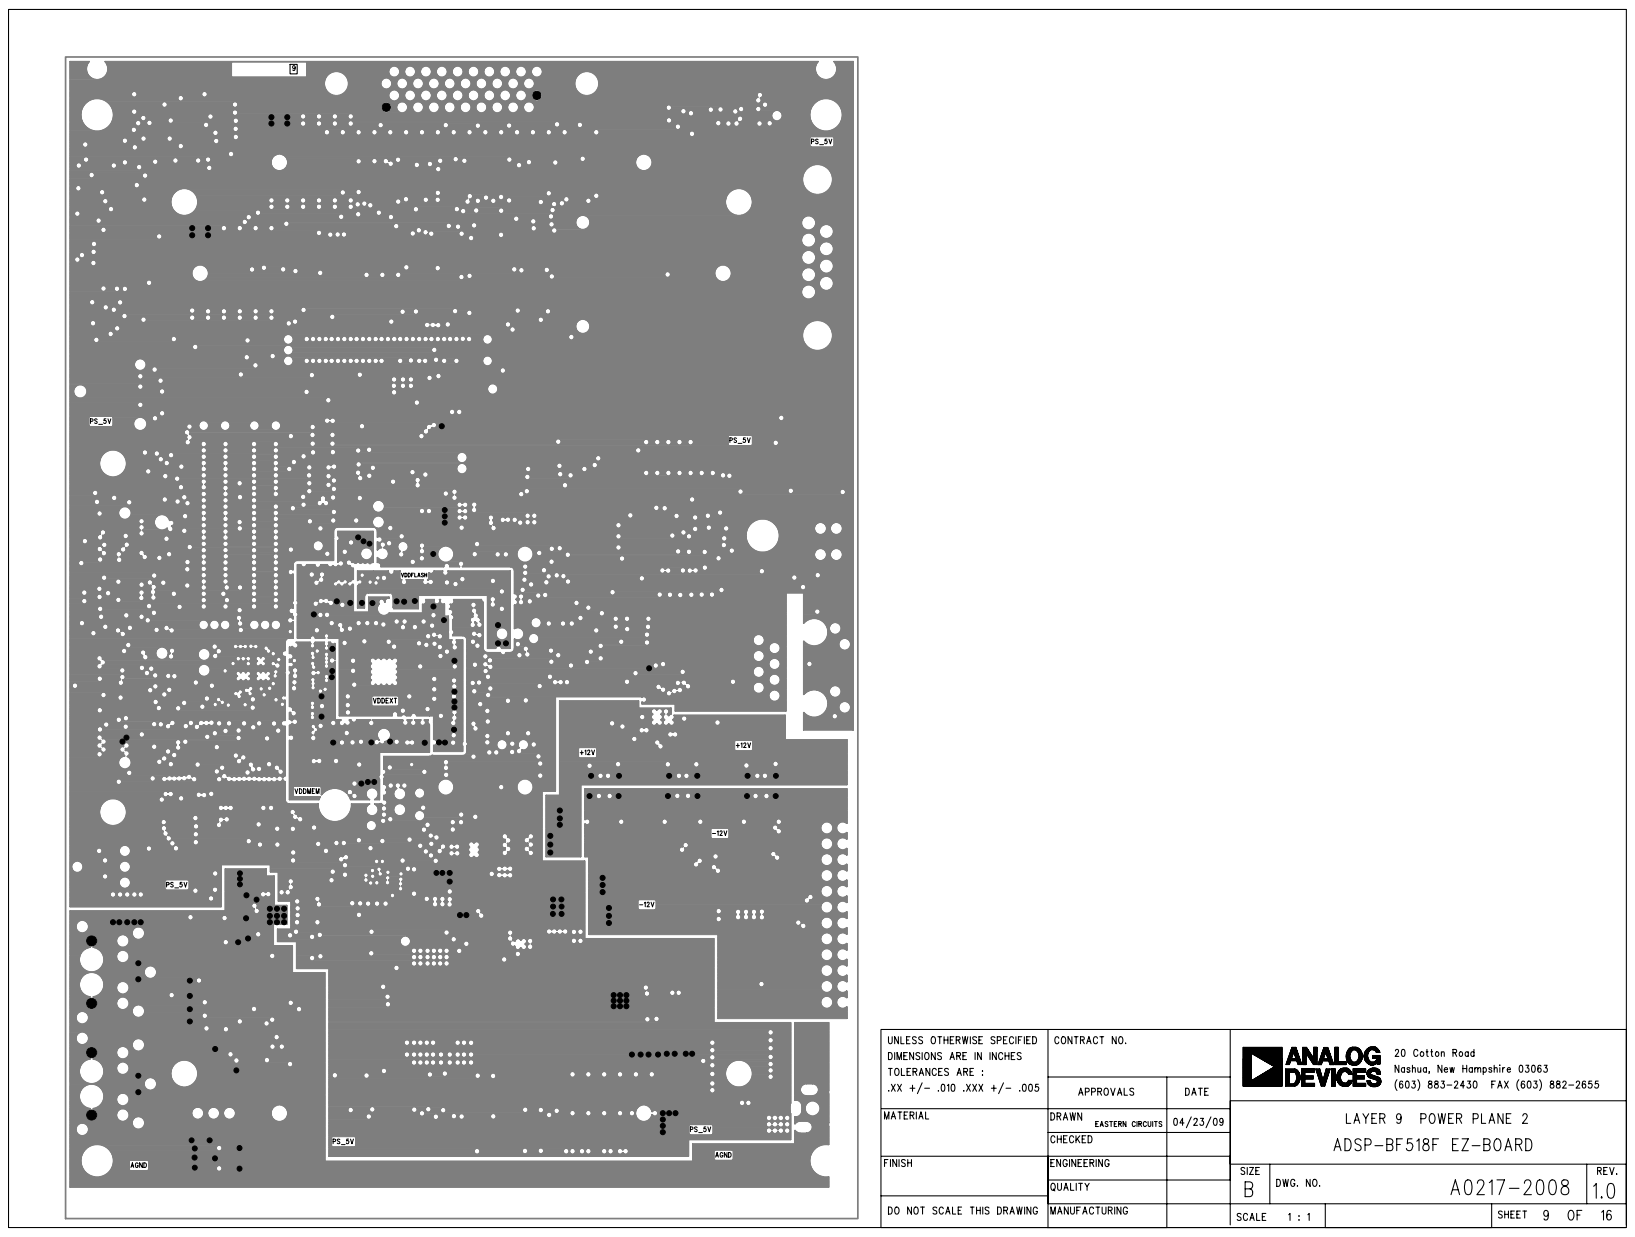
[picture p72: page 14]

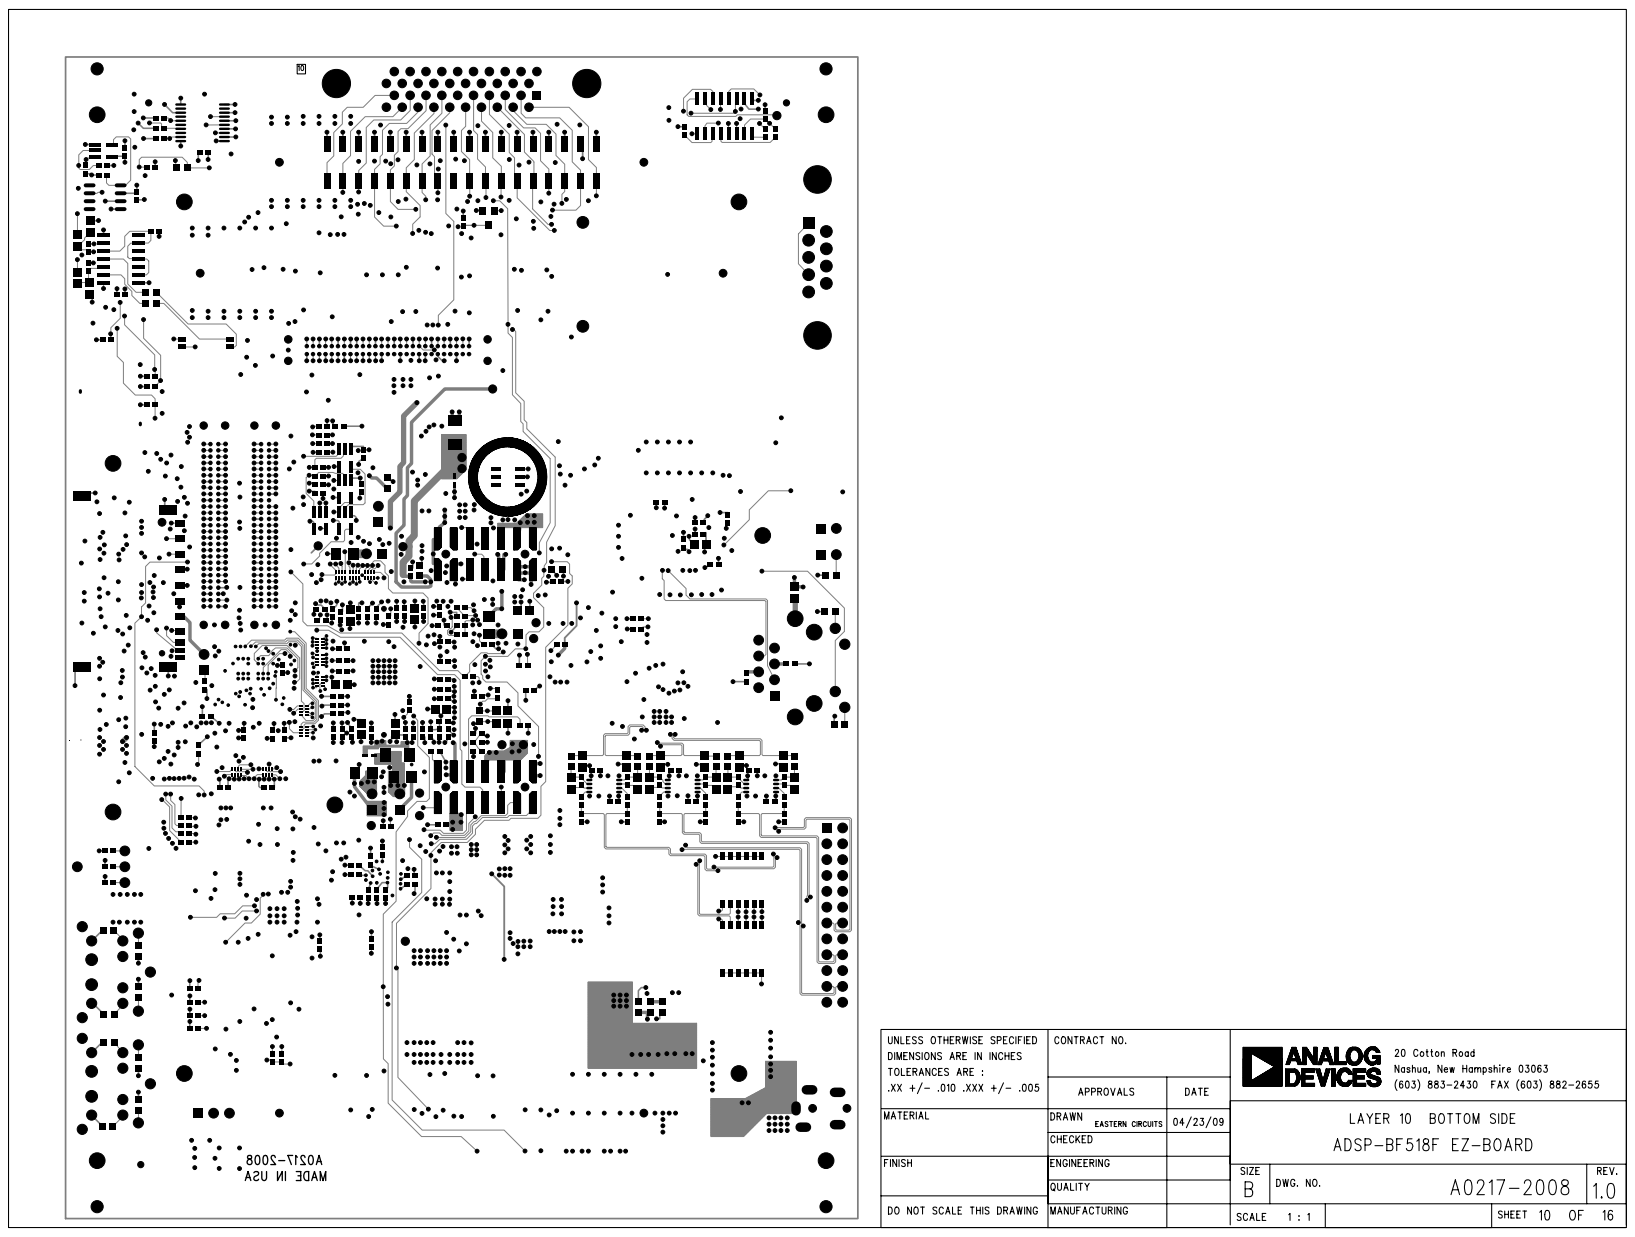
[picture p73: page 15]

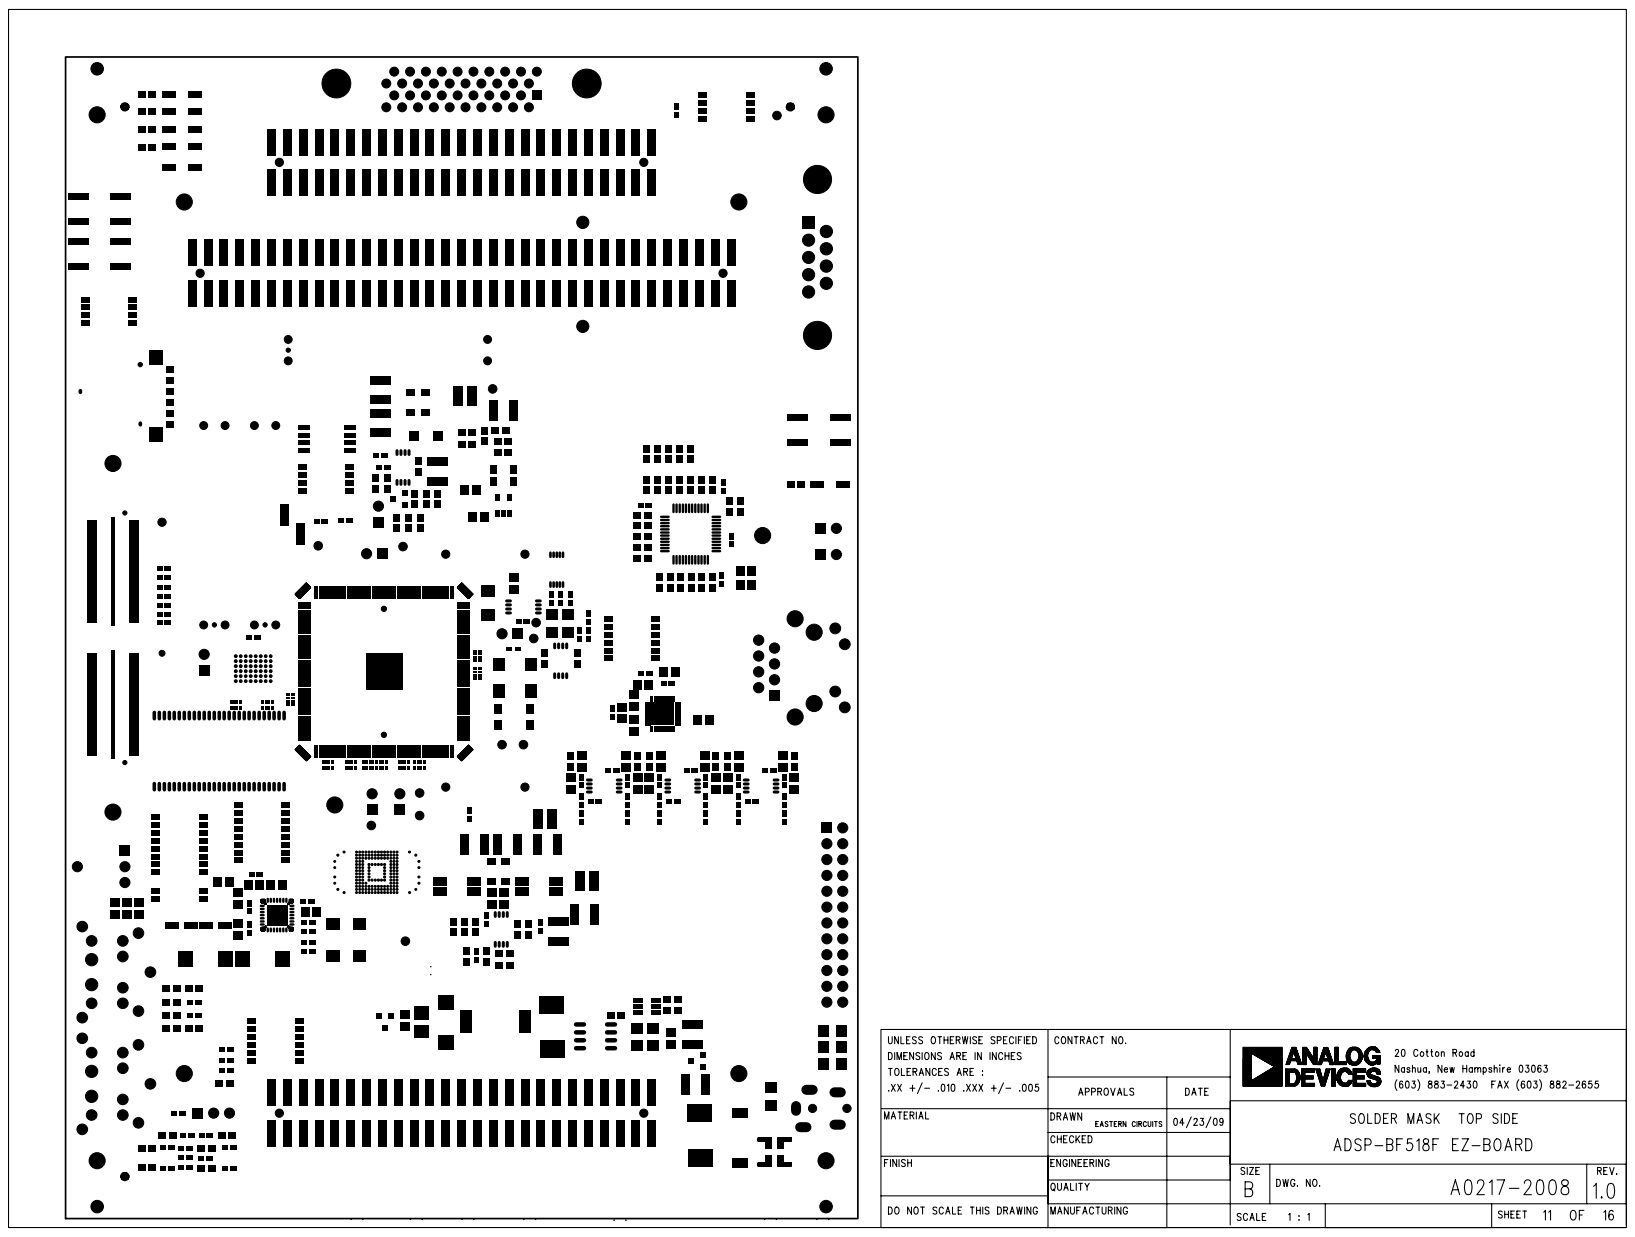
[picture p74: page 16]

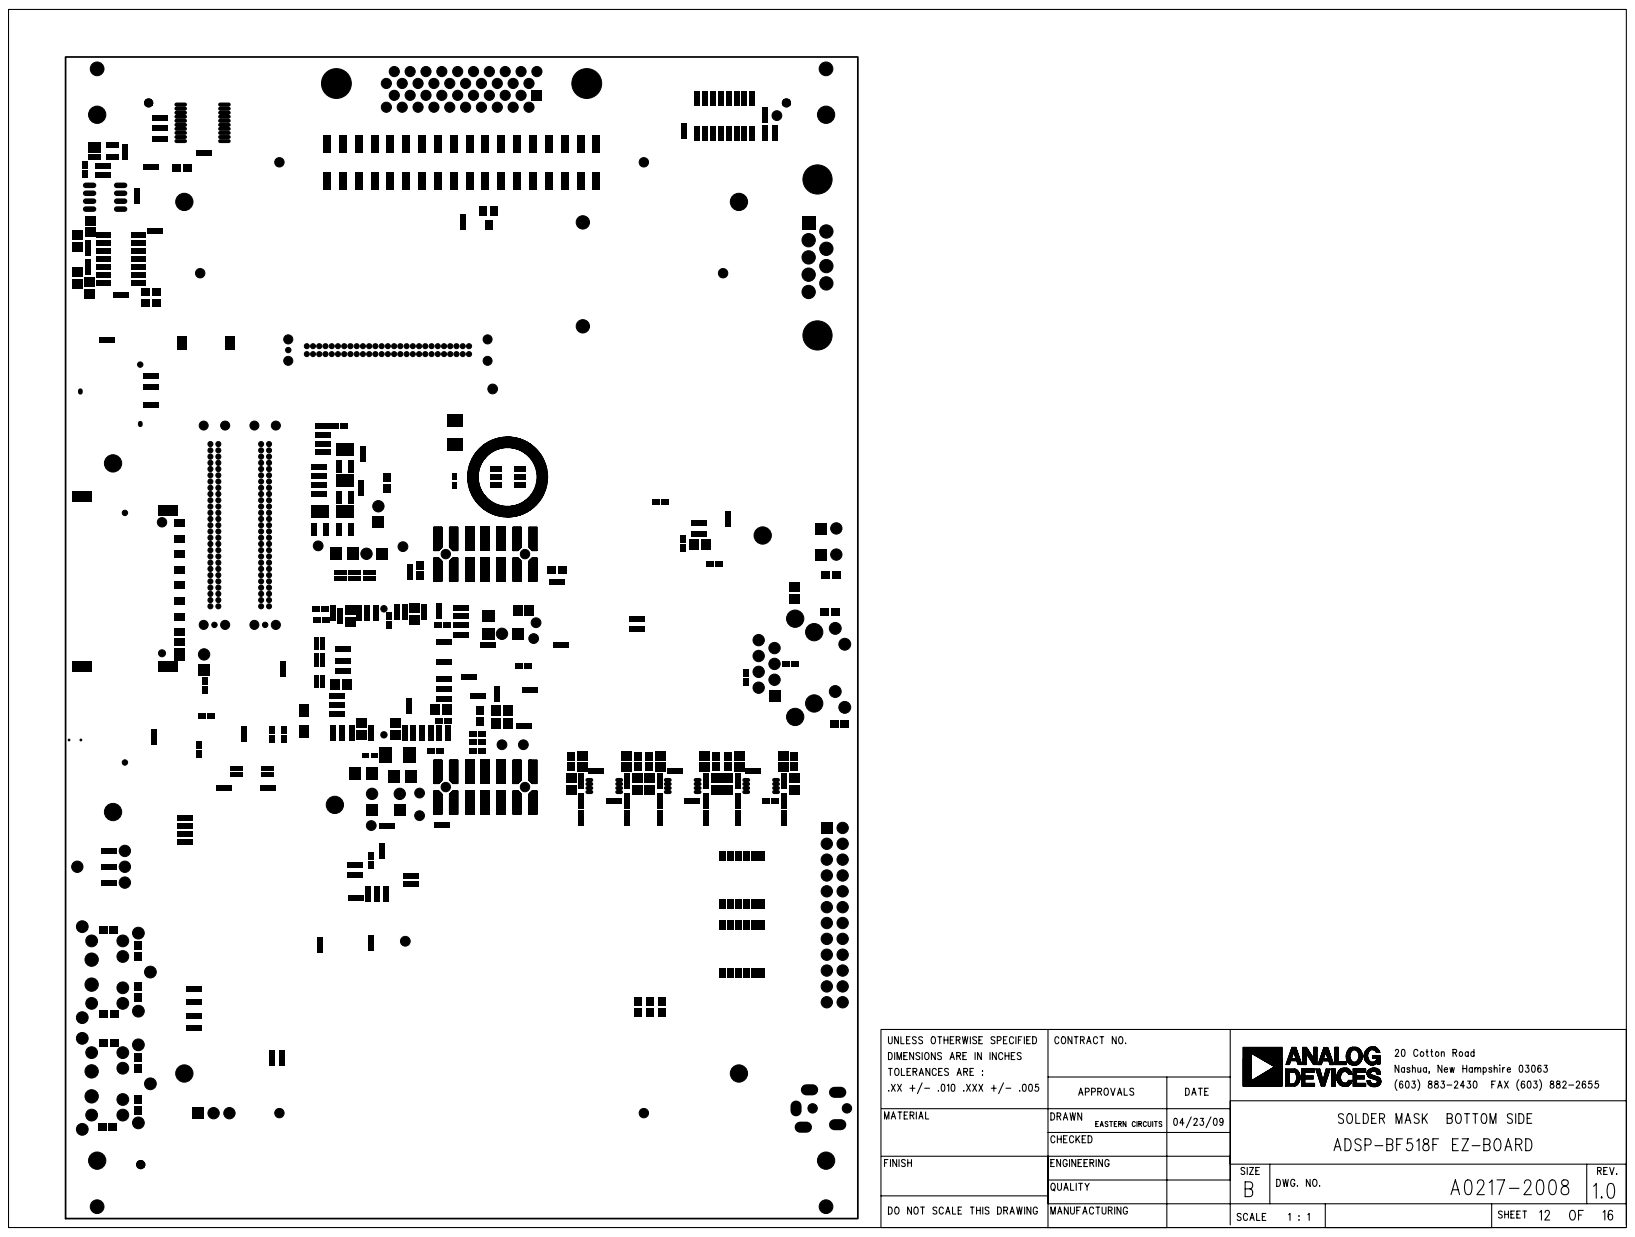
[picture p75: page 17]

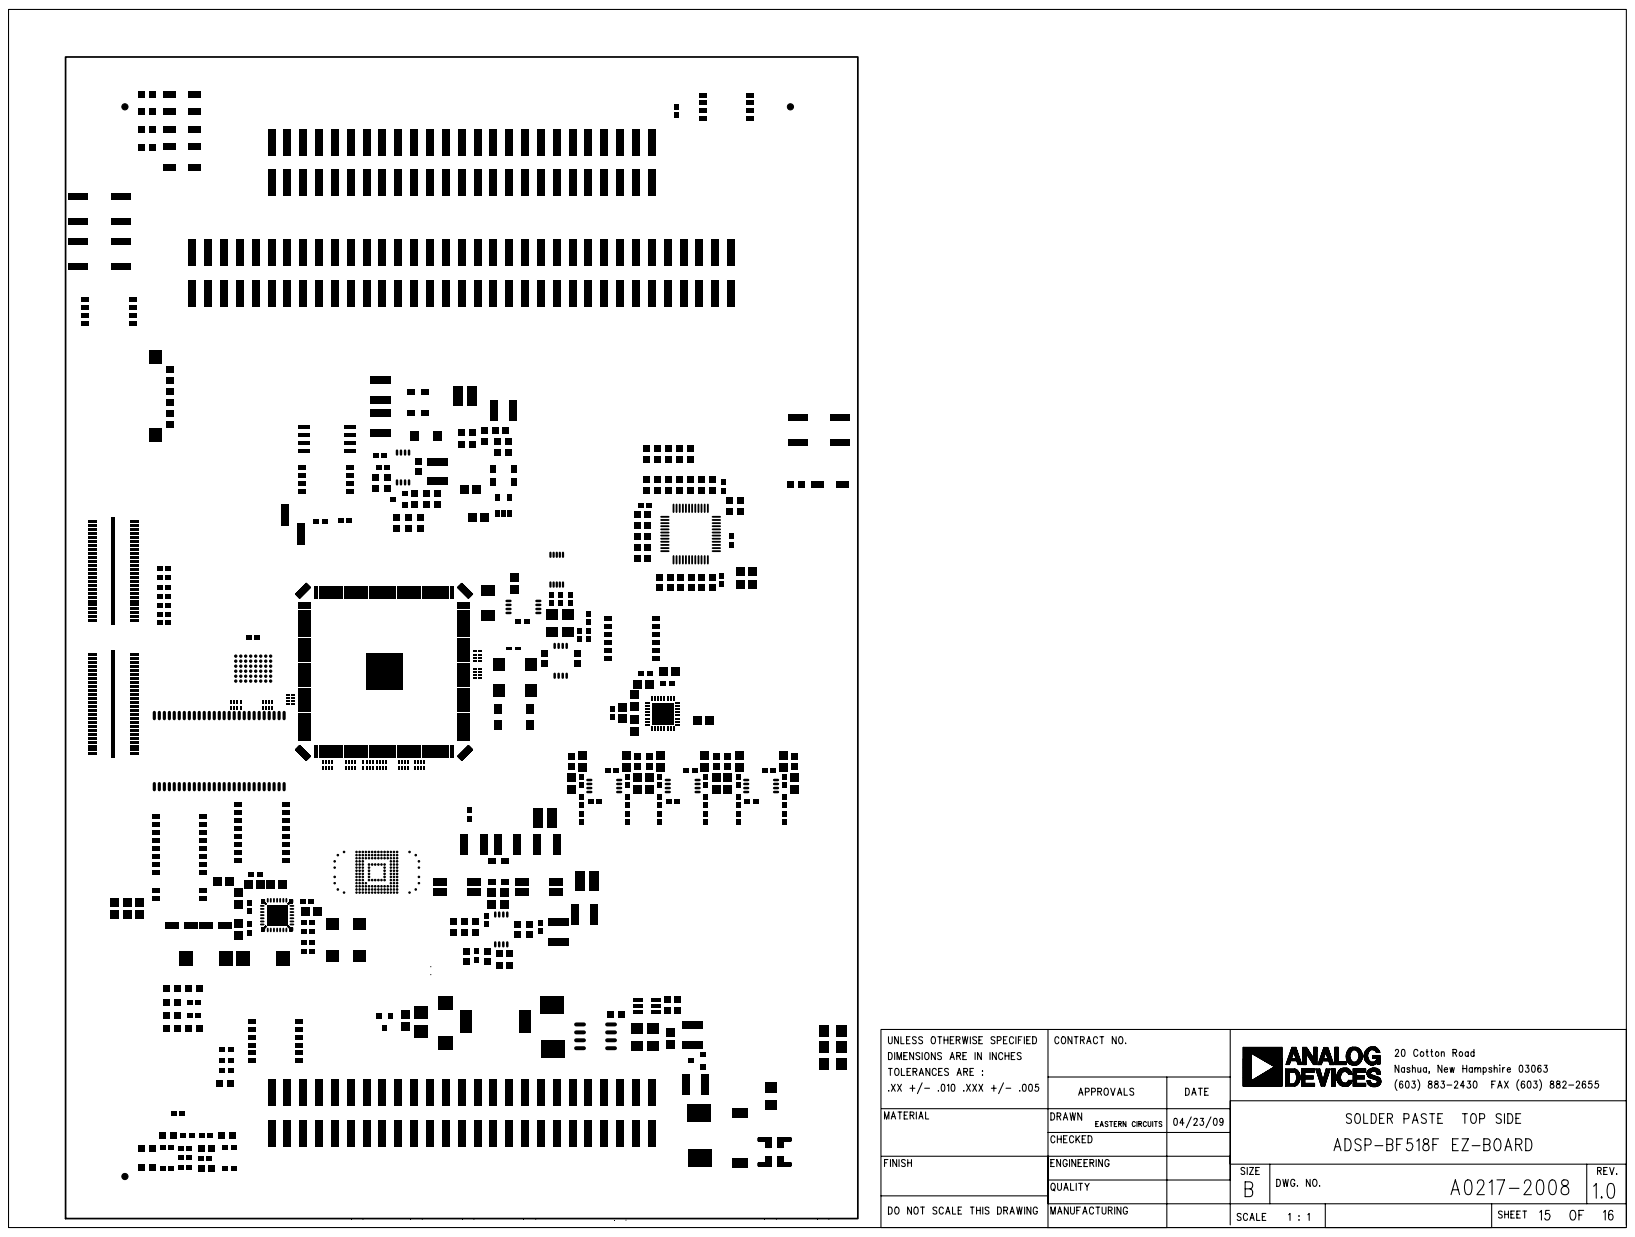
[picture p76: page 18]

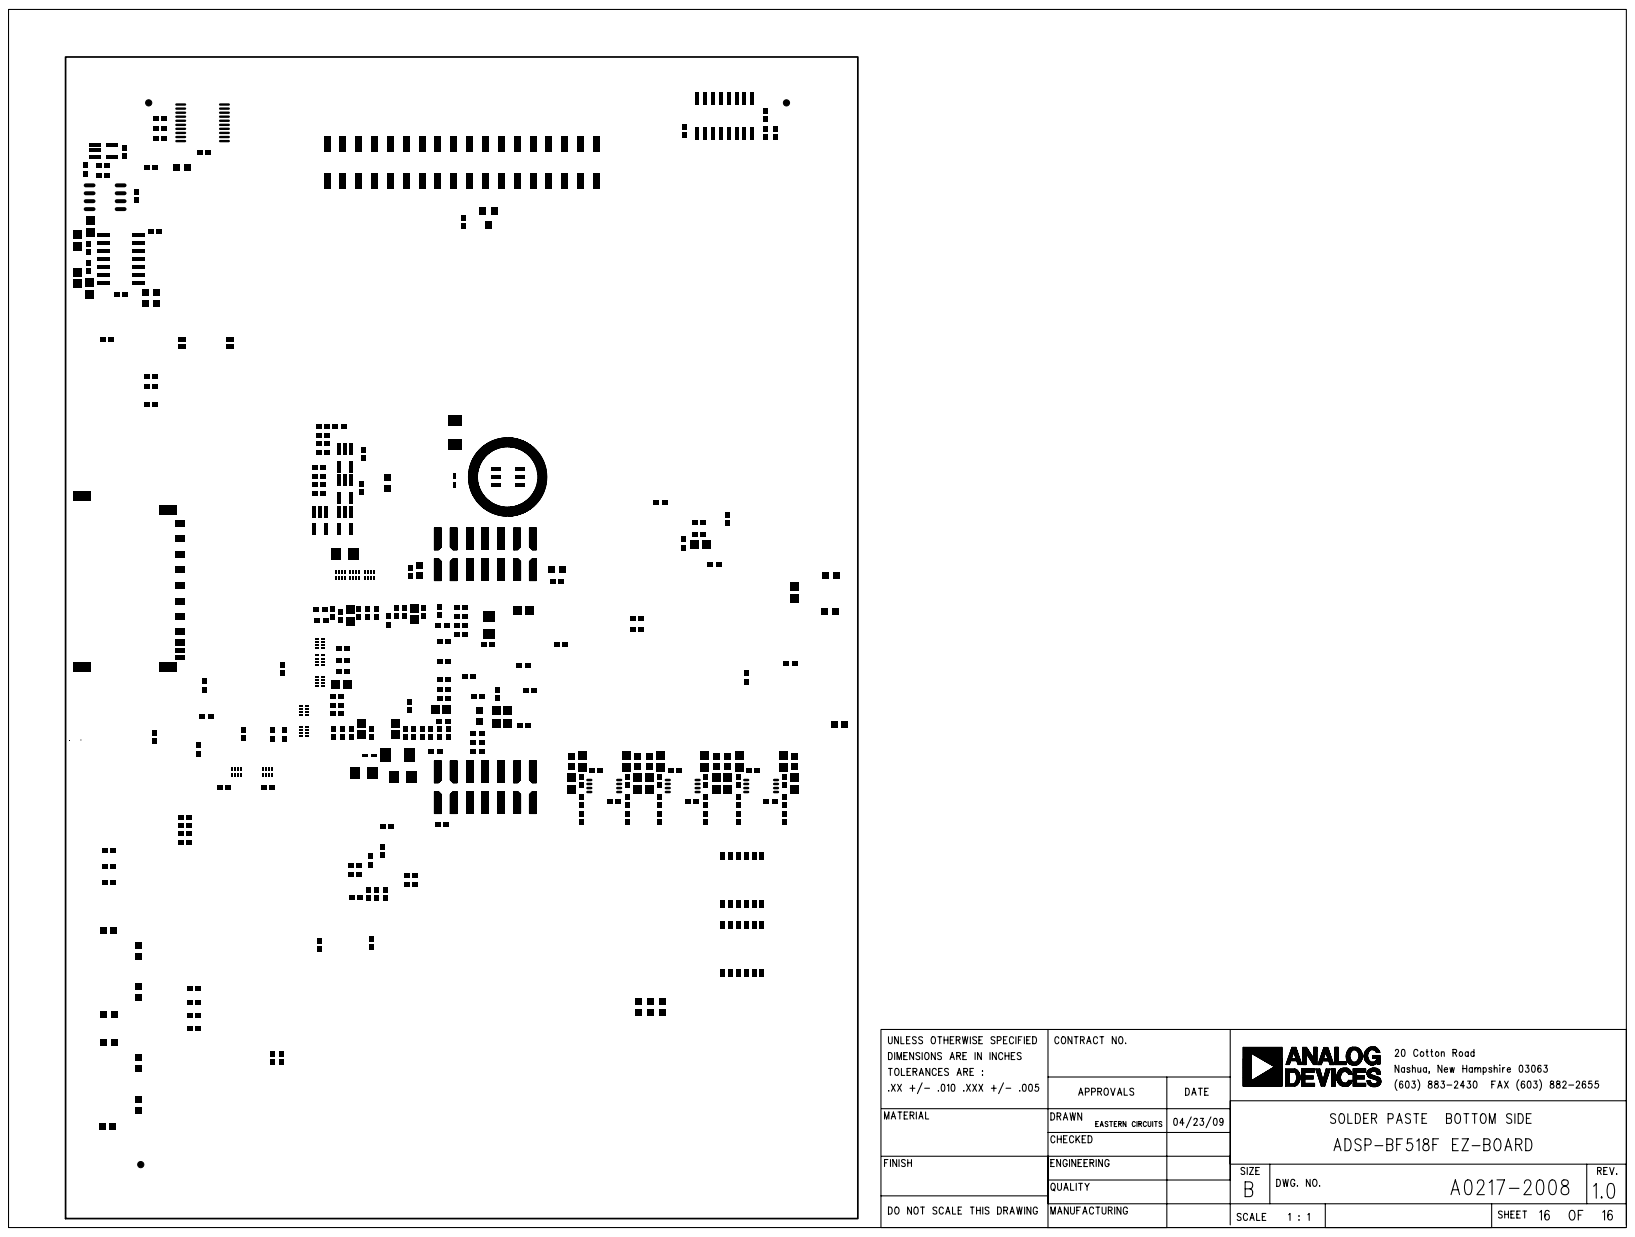
[picture p77: page 19]
