julioamerico/blackfin-ip-phone-hw/pesquisa/connectors/15-91-0140.pdf

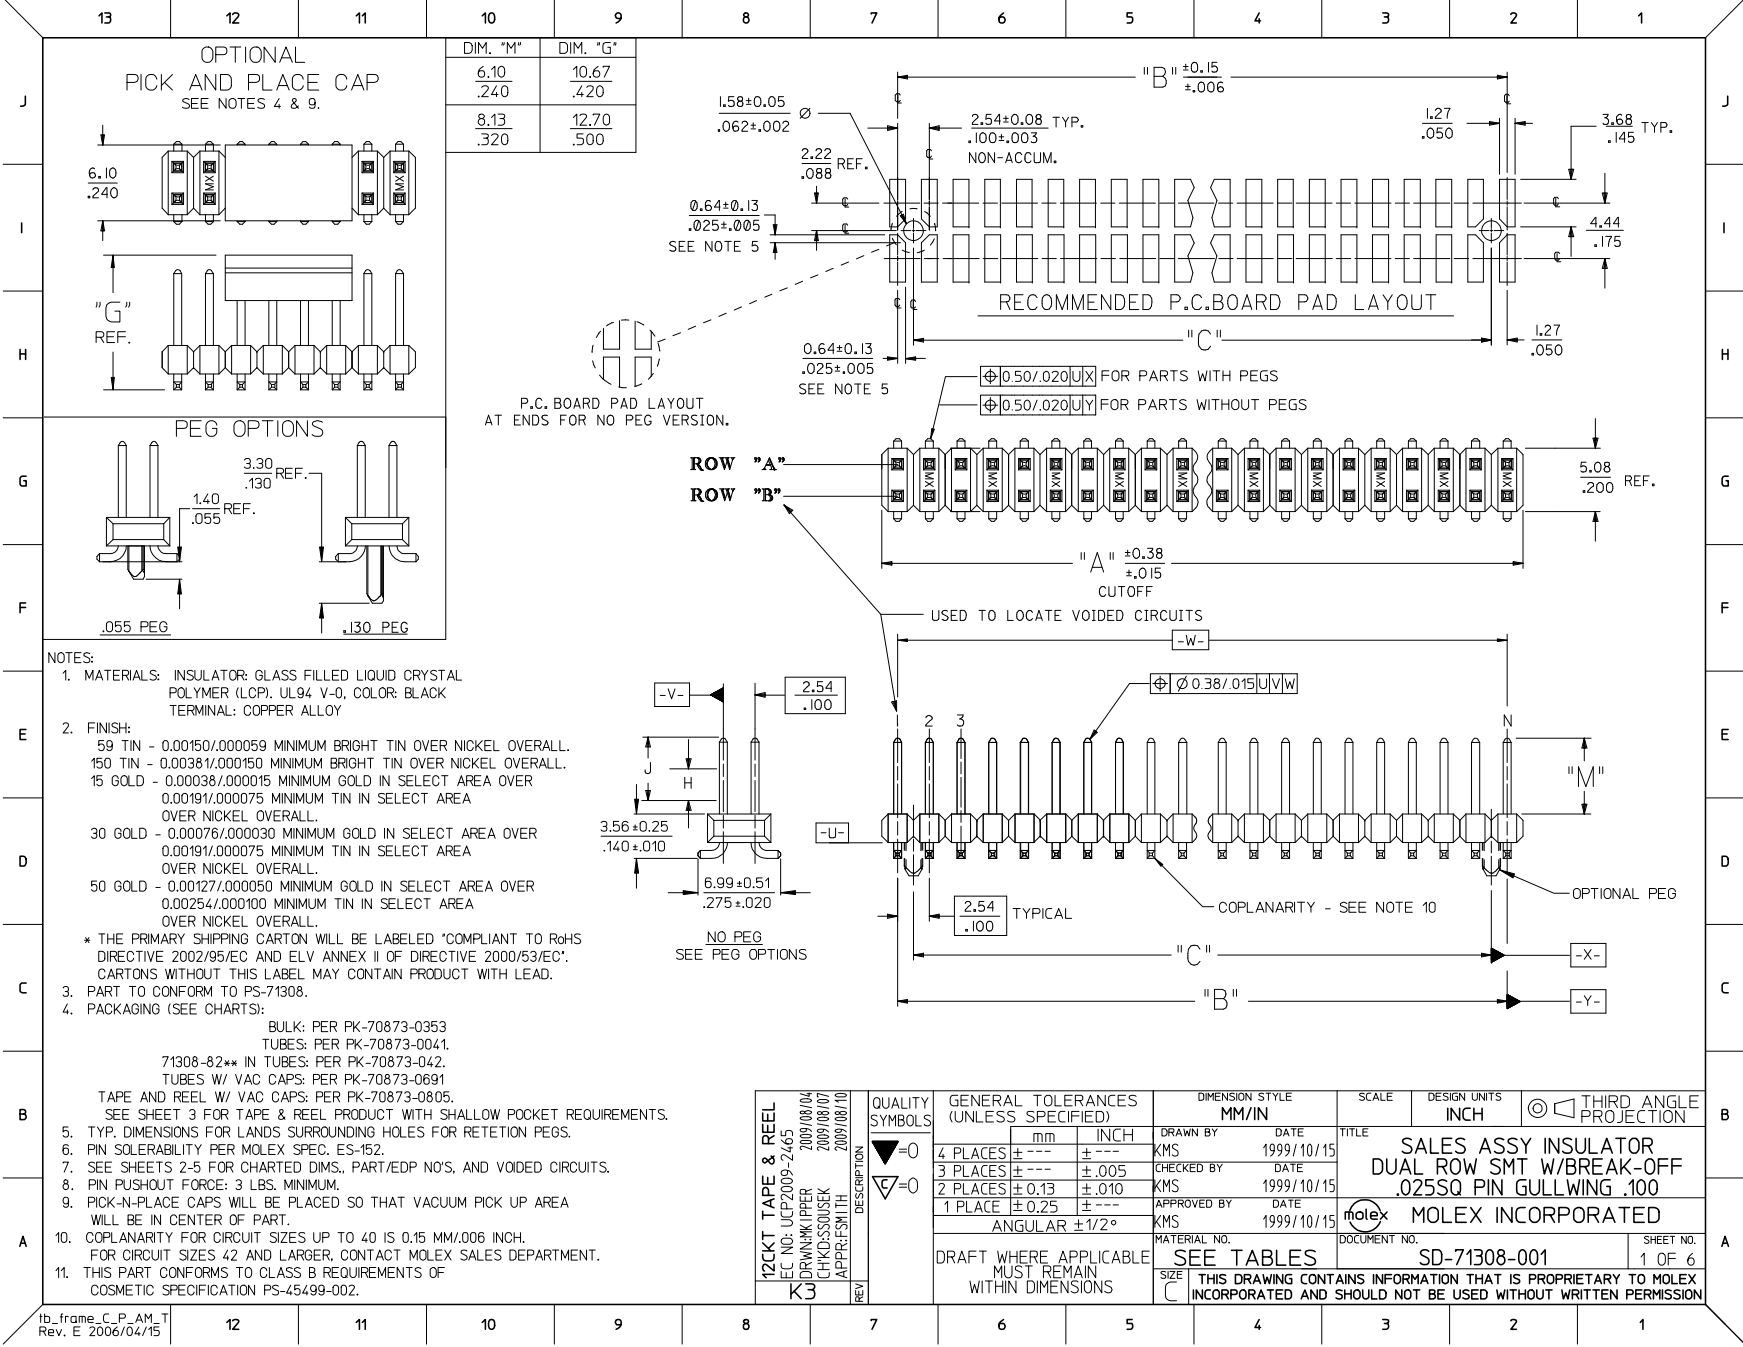
[picture p84: page 1]

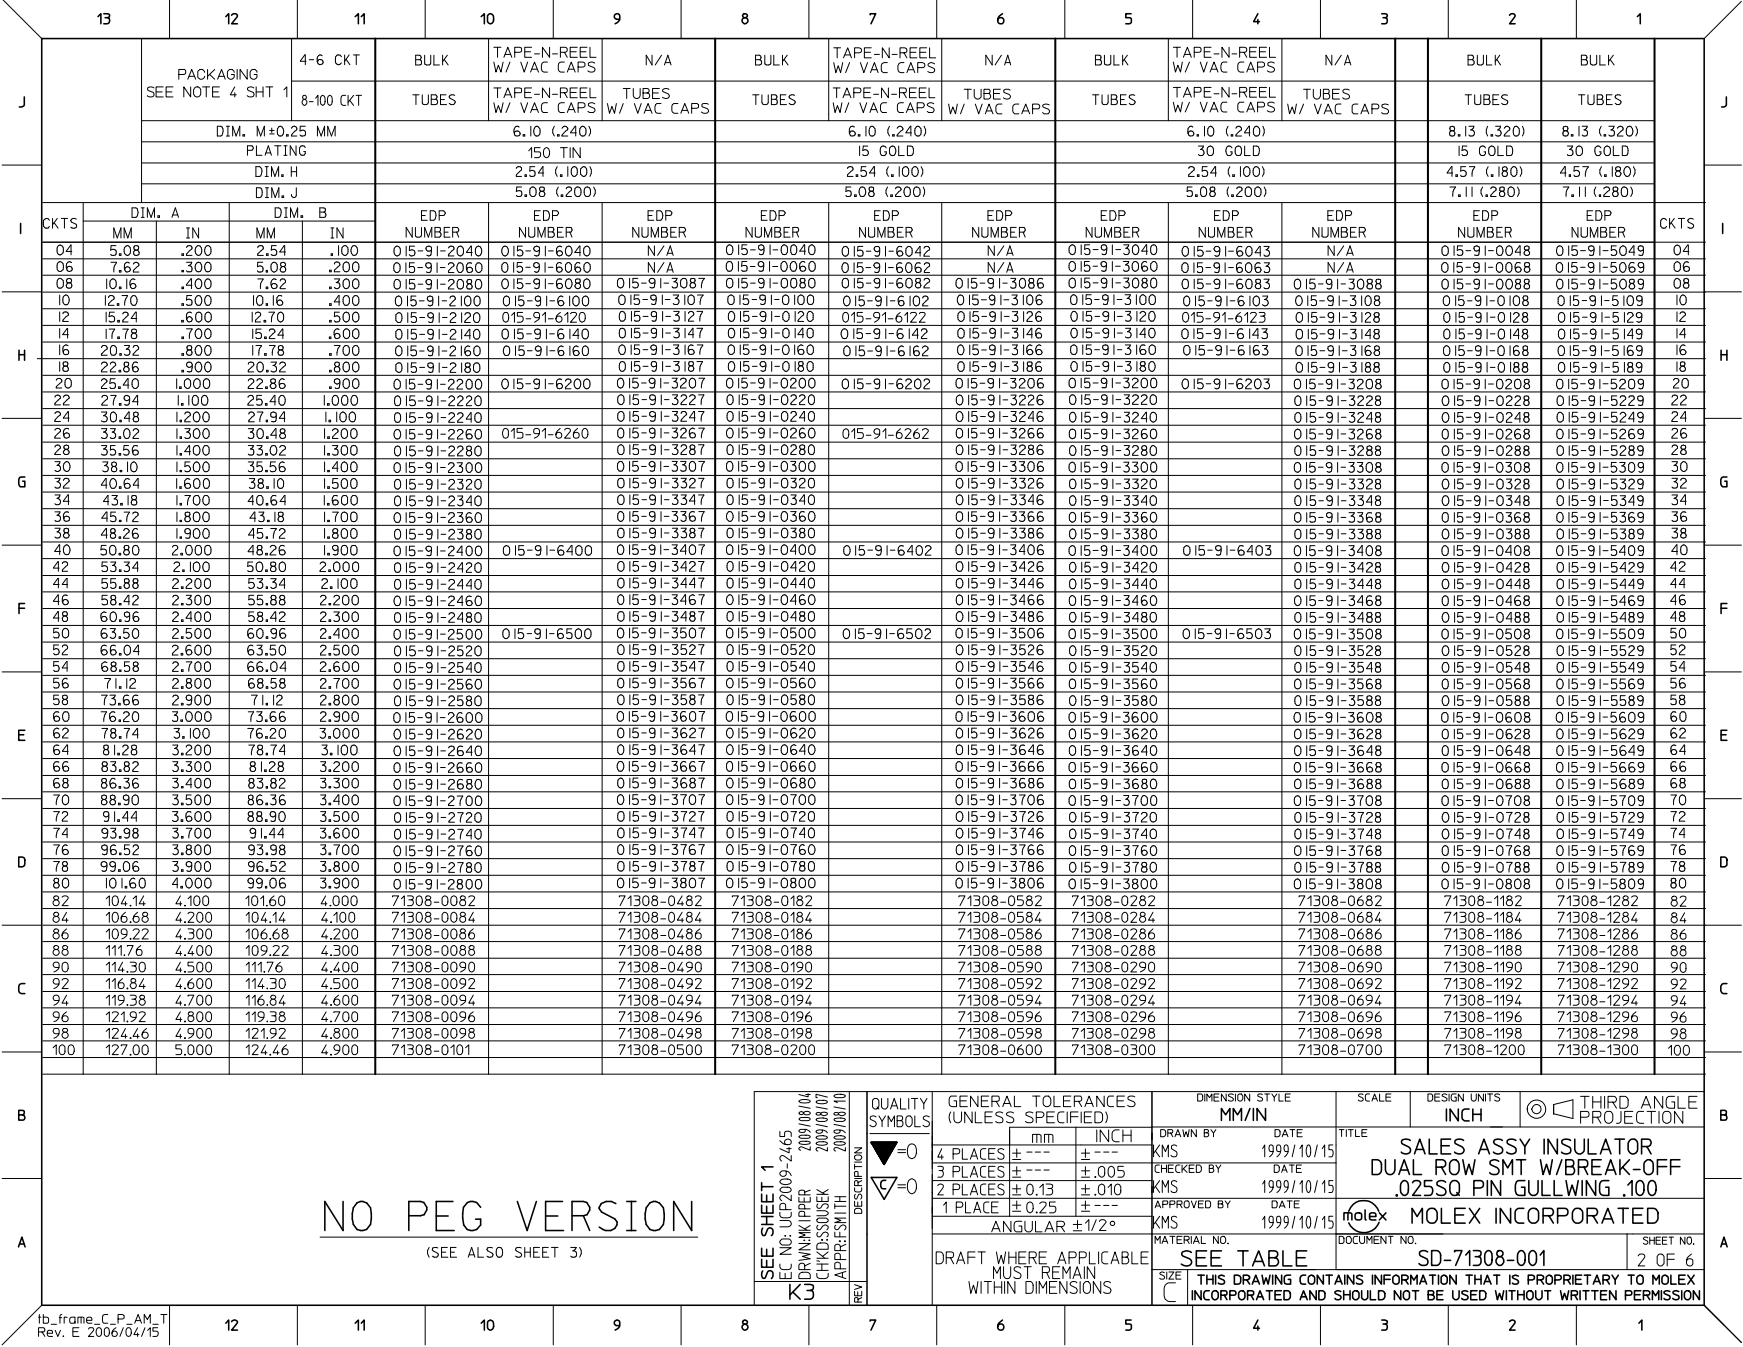
[picture p85: page 2]

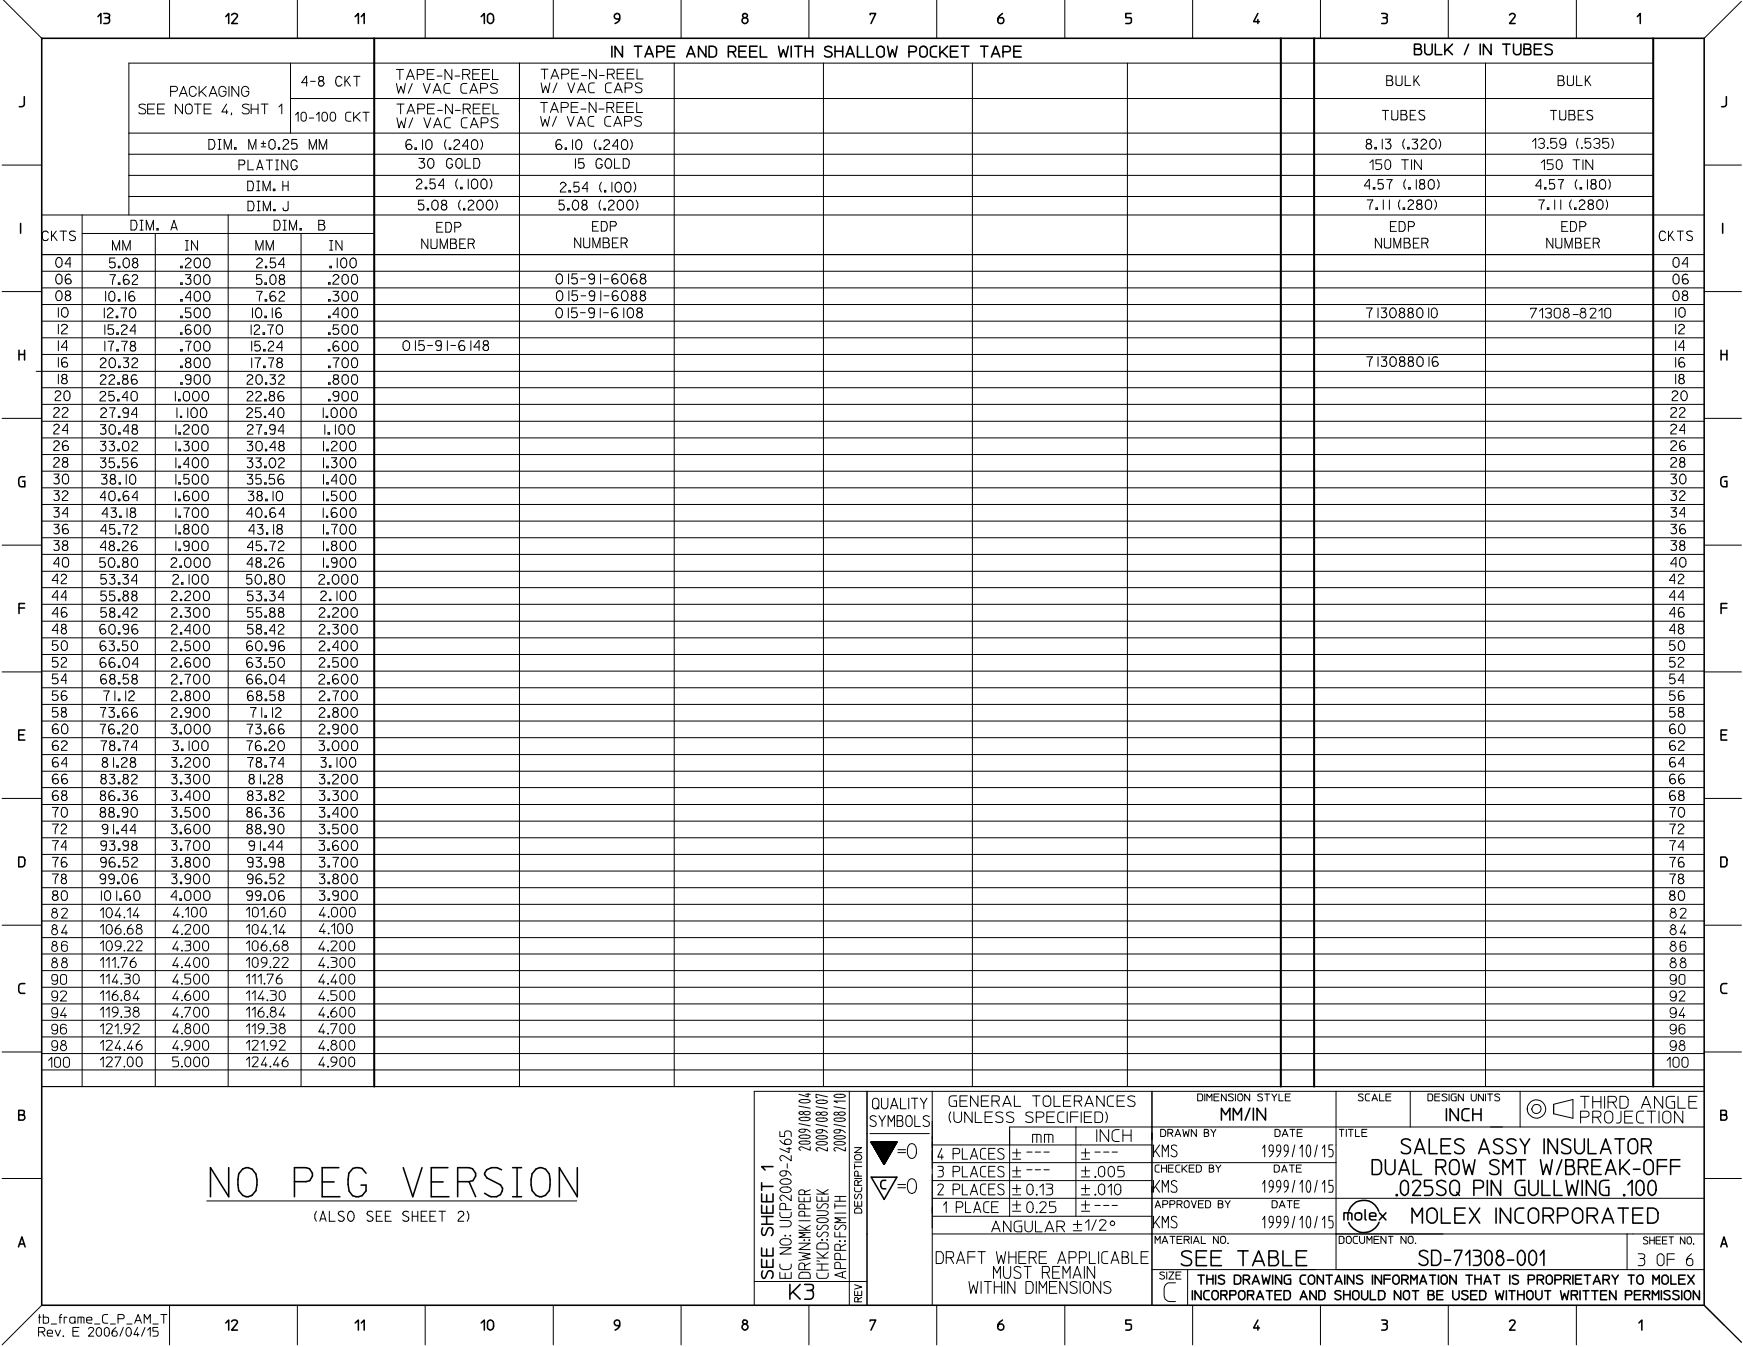
[picture p86: page 3]

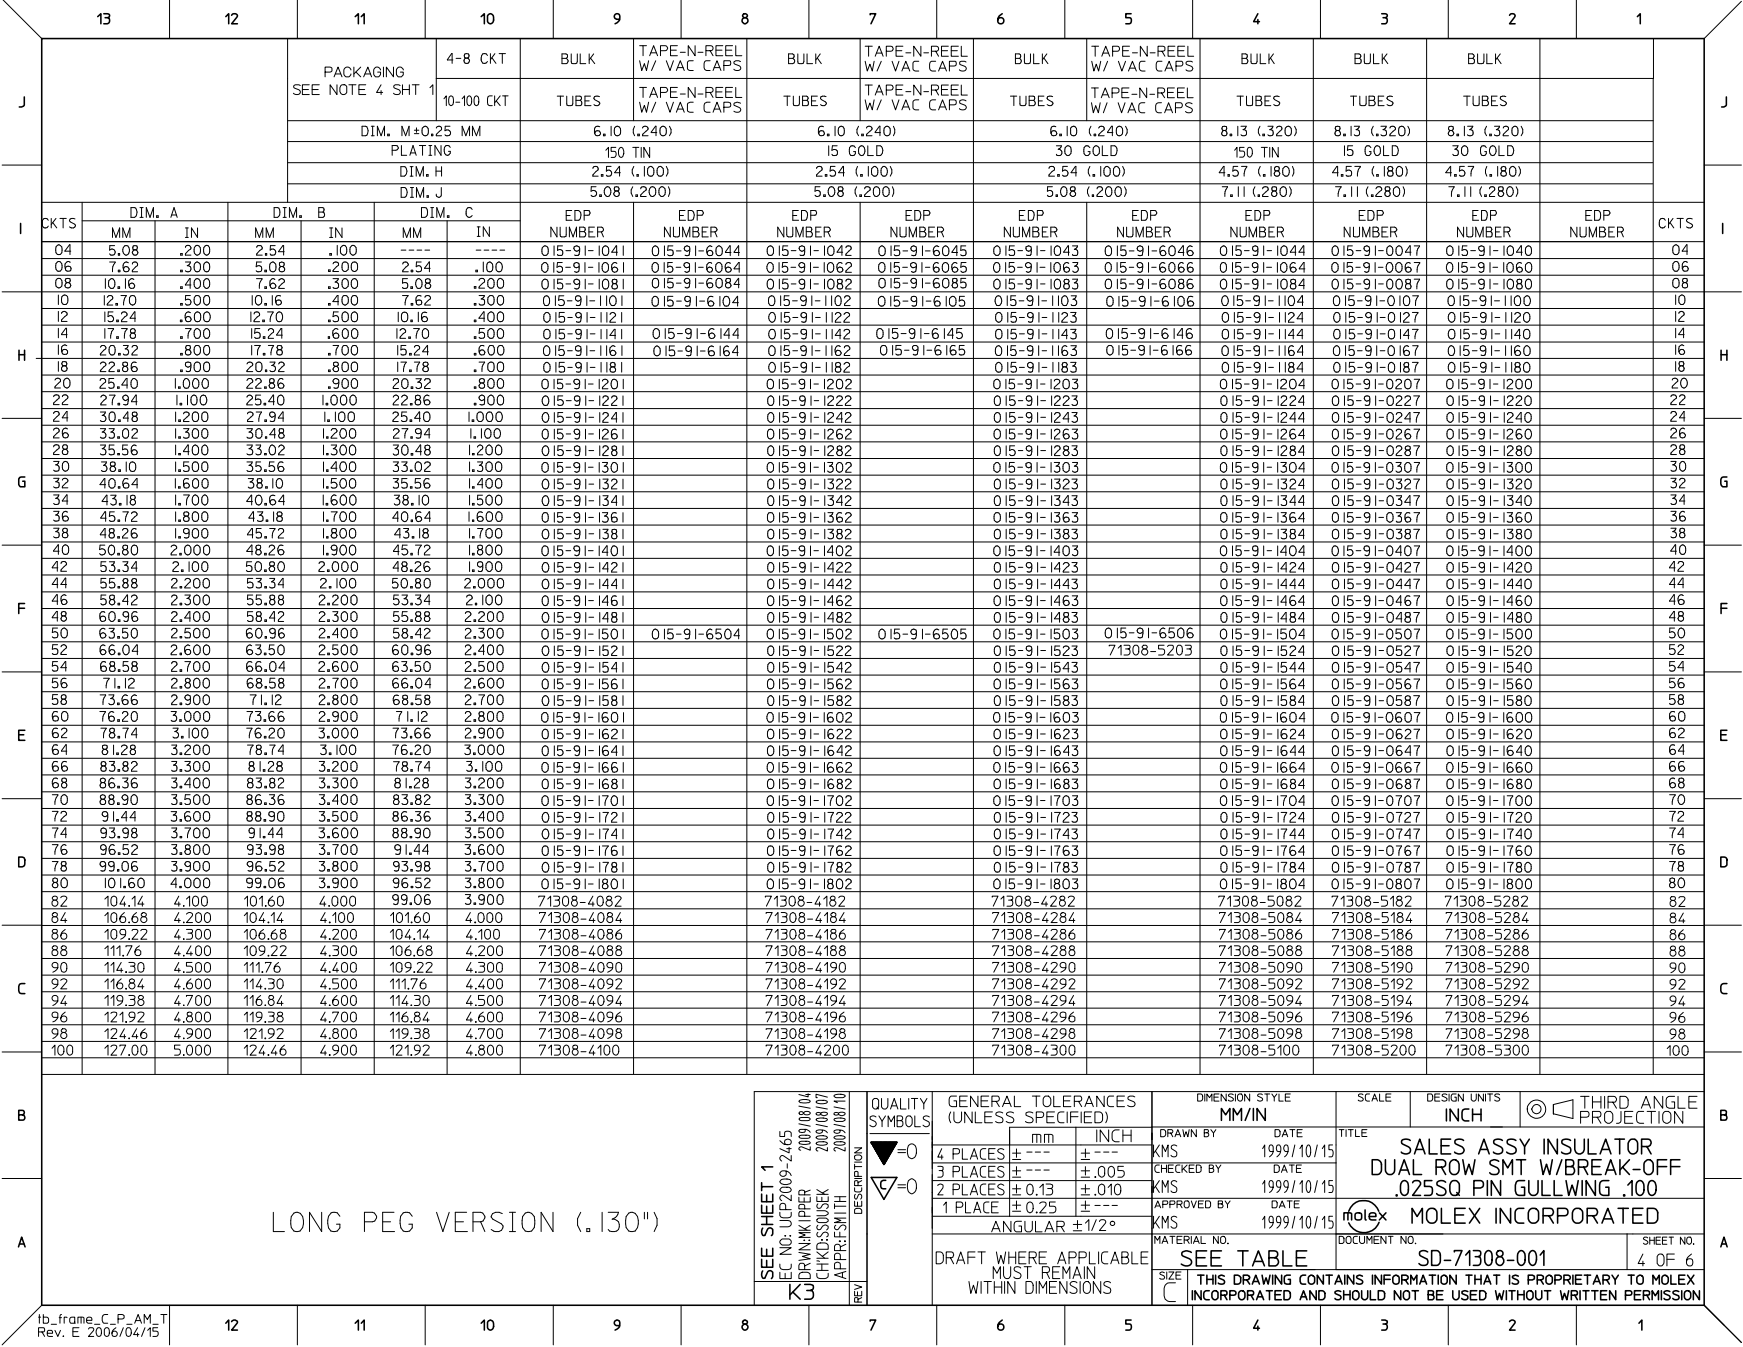
[picture p87: page 4]

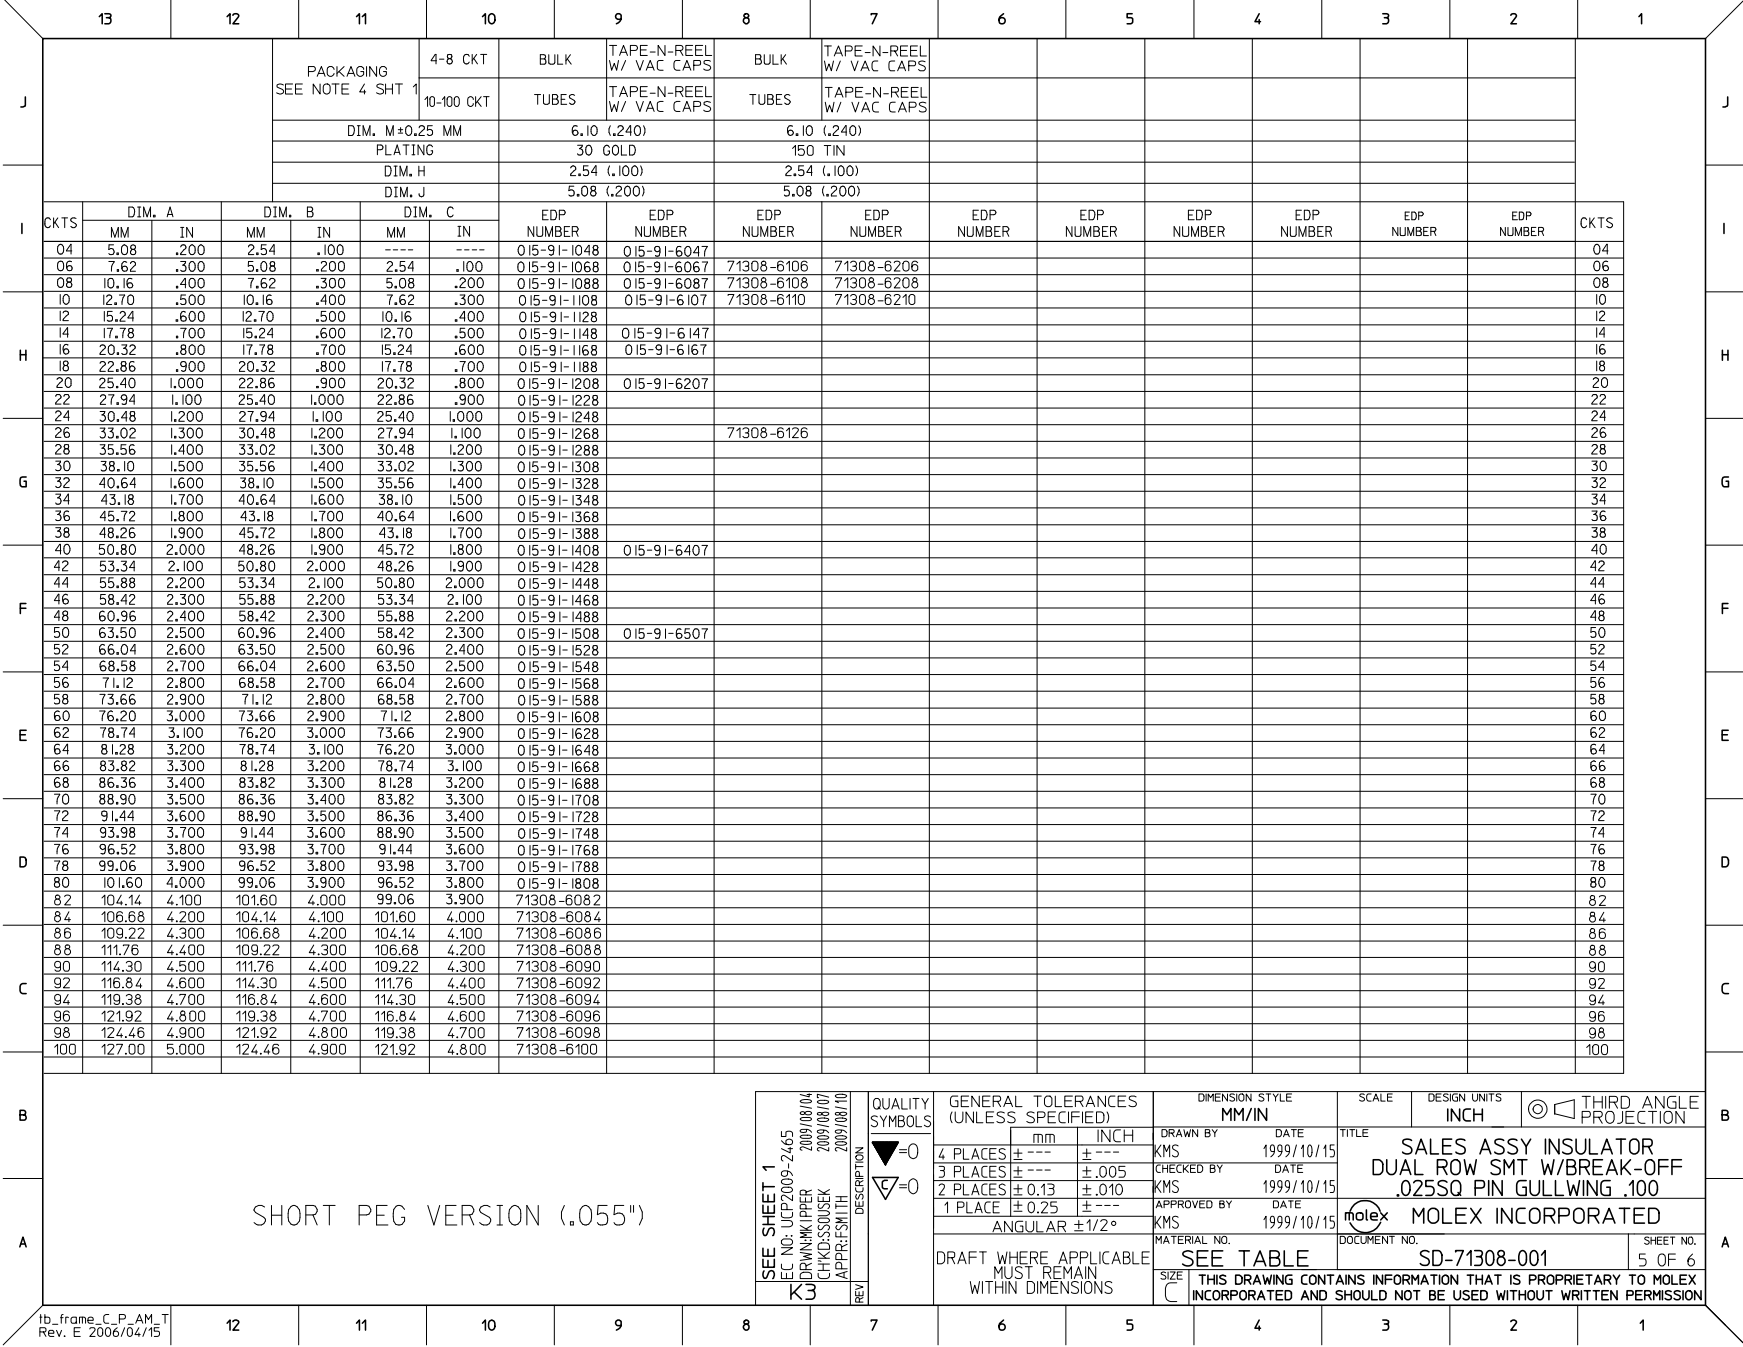
[picture p88: page 5]

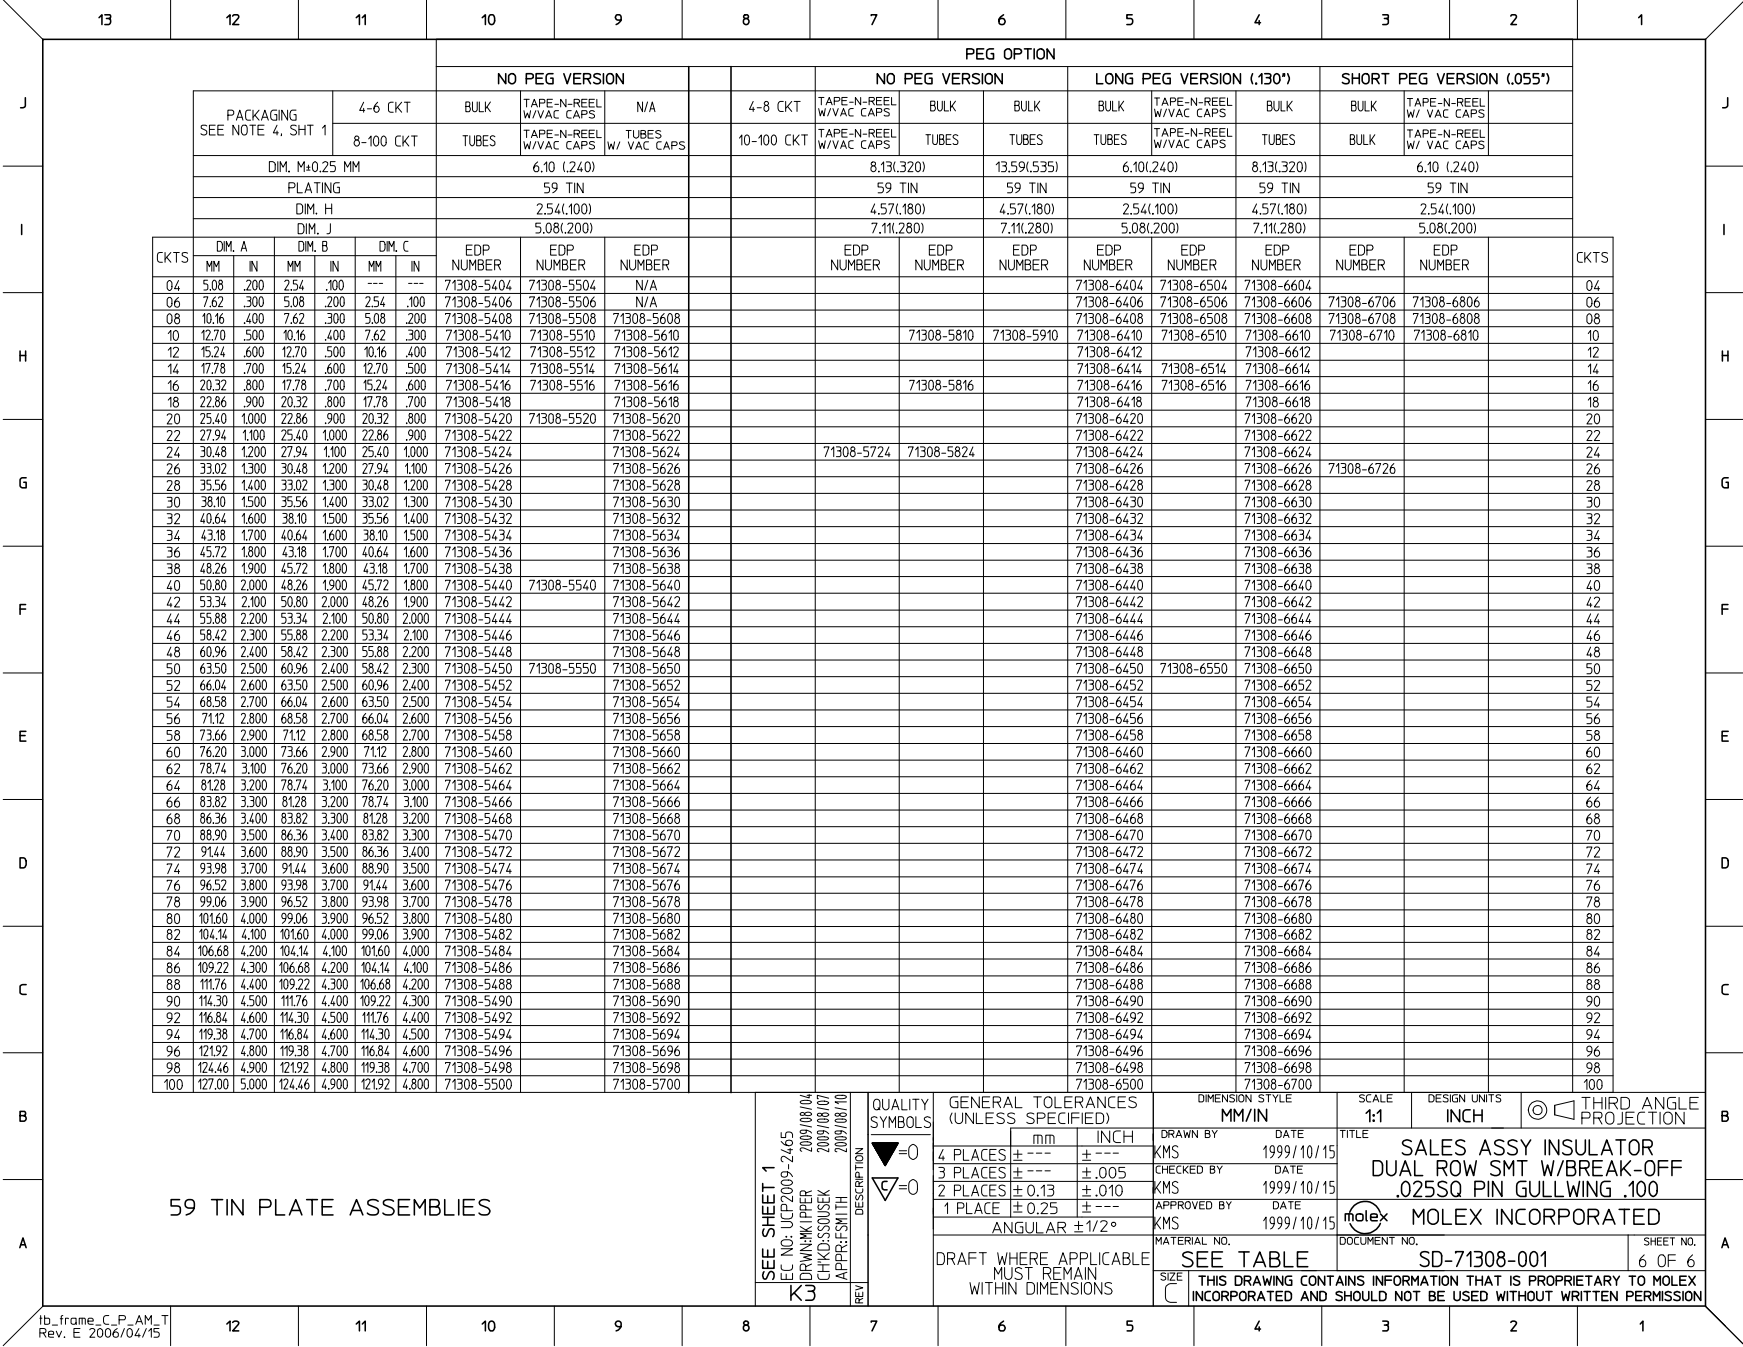
[picture p89: page 6]
