julioamerico/blackfin-ip-phone-hw/(list of files, drawings)

Other design files:
implementação/pcb/blackfin_pcb.PcbDoc
implementação/prj/blackfin.PrjPCB
implementação/sch/blackfin_a_sdram.SchDoc
implementação/sch/blackfin_b_flash_jtag_serial.SchDoc
implementação/sch/blackfin_c_ethernet.SchDoc
implementação/sch/blackfin_d_codec.SchDoc
implementação/sch/blackfin_e_lcd_keypad.SchDoc
implementação/sch/blackfin_f_power.SchDoc
pesquisa/processor/ADSP_BF518F_EZ_Board_Design_Reference_Info(1_0)/layout/A0217-2008.pcb
