julioamerico/blackfin-ip-phone-hw/implementação/fw/uclinux/blackfin-linux-dist/linux-2.6.x/arch/blackfin/mach-bf518/boards/bf518-ipphone.c

/*
 * uClinux porting for Blackfin IP Phone board
 */

#include <linux/device.h>
#include <linux/platform_device.h>
#include <linux/mtd/mtd.h>
#include <linux/mtd/partitions.h>
#include <linux/mtd/physmap.h>
#include <linux/spi/spi.h>
#include <linux/spi/flash.h>
#include <linux/spi/mmc_spi.h>

#include <linux/i2c.h>
#include <linux/i2c/adp5588.h>
#include <linux/irq.h>
#include <linux/interrupt.h>
#include <linux/input.h>
#include <asm/dma.h>
#include <asm/bfin5xx_spi.h>
#include <asm/reboot.h>
#include <asm/portmux.h>
#include <asm/dpmc.h>
#include <asm/bfin_sdh.h>
#include <linux/spi/ad7877.h>
#include <net/dsa.h>

#include <asm/bfin_sport.h>

/*
 * Name the Board for the /proc/cpuinfo
 */
const char bfin_board_name[] = "Blackfin IP Phone";

/*
 *  Driver needs to know address, irq and flag pin.
 */
/*
#if defined(CONFIG_MTD_PHYSMAP) || defined(CONFIG_MTD_PHYSMAP_MODULE)
static struct mtd_partition ezbrd_partitions[] = {
	{
		.name       = "bootloader(nor)",
		.size       = 0x40000,
		.offset     = 0,
	}, {
		.name       = "linux kernel(nor)",
		.size       = 0x6C0000,
		.offset     = MTDPART_OFS_APPEND,
	}, { 
		.name       = "jffs2(nor)",
		.size       = 0x100000,
		.offset     = MTDPART_OFS_APPEND,
	}
};

static struct physmap_flash_data ezbrd_flash_data = {
	.width      = 2,
	.parts      = ezbrd_partitions,
	.nr_parts   = ARRAY_SIZE(ezbrd_partitions),
};

static struct resource ezbrd_flash_resource = {
	.start = 0x20000000,
#if defined(CONFIG_SPI_BFIN) || defined(CONFIG_SPI_BFIN_MODULE)
	.end   = 0x202fffff,
#else
	.end = 0x207fffff,
#endif
	.flags = IORESOURCE_MEM,
};

static struct platform_device ezbrd_flash_device = {
	.name          = "physmap-flash",
	.id            = 0,
	.dev = {
		.platform_data = &ezbrd_flash_data,
	},
	.num_resources = 1,
	.resource      = &ezbrd_flash_resource,
};
#endif*/

#if defined(CONFIG_MTD_M25P80) || defined(CONFIG_MTD_M25P80_MODULE)
static struct mtd_partition bfin_spi_flash_partitions[] = {
  {
    .name       = "bootloader(nor)",
    .size       = 0x40000,
    .offset     = 0,
  }, {
    .name       = "linux kernel(nor)",
    .size       = 0x6C0000,
    .offset     = MTDPART_OFS_APPEND,
  }, { 
    .name       = "jffs2(nor)",
    .size       = 0x100000,
    .offset     = MTDPART_OFS_APPEND,
  }
};

static struct flash_platform_data bfin_spi_flash_data = {
  .name = "m25p80",
  .parts = bfin_spi_flash_partitions,
  .nr_parts = ARRAY_SIZE(bfin_spi_flash_partitions),
  .type = "s25sl064a",
};

/* SPI flash chip (m25p64) */
static struct bfin5xx_spi_chip spi_flash_chip_info = {
  .enable_dma = 0,         /* use dma transfer with this chip*/
  .bits_per_word = 8,
};
#endif

#if defined(CONFIG_RTC_DRV_BFIN) || defined(CONFIG_RTC_DRV_BFIN_MODULE)
static struct platform_device rtc_device = {
	.name = "rtc-bfin",
	.id   = -1,
};
#endif

#if defined(CONFIG_BFIN_MAC) || defined(CONFIG_BFIN_MAC_MODULE)
#include <linux/bfin_mac.h>
static const unsigned short bfin_mac_peripherals[] = {
	P_MII0_ETxD0,
	P_MII0_ETxD1,
	P_MII0_ETxEN,
	P_MII0_ERxD0,
	P_MII0_ERxD1,
	P_MII0_TxCLK,
	P_MII0_PHYINT,
	P_MII0_CRS,
	P_MII0_MDC,
	P_MII0_MDIO,
	0
};

static struct bfin_phydev_platform_data bfin_phydev_data[] = {
	{
#if defined(CONFIG_NET_DSA_KSZ8893M) || defined(CONFIG_NET_DSA_KSZ8893M_MODULE)
		.addr = 3,
#else
		.addr = 1,
#endif
		.irq = IRQ_MAC_PHYINT,
	},
};

static struct bfin_mii_bus_platform_data bfin_mii_bus_data = {
	.phydev_number = 1,
	.phydev_data = bfin_phydev_data,
	.phy_mode = PHY_INTERFACE_MODE_MII,
	.mac_peripherals = bfin_mac_peripherals,
#if defined(CONFIG_NET_DSA_KSZ8893M) || defined(CONFIG_NET_DSA_KSZ8893M_MODULE)
	.phy_mask = 0xfff7, /* Only probe the port phy connect to the on chip MAC */
#endif
};

static struct platform_device bfin_mii_bus = {
	.name = "bfin_mii_bus",
	.dev = {
		.platform_data = &bfin_mii_bus_data,
	}
};

static struct platform_device bfin_mac_device = {
	.name = "bfin_mac",
	.dev = {
		.platform_data = &bfin_mii_bus,
	}
};
#endif

#if defined(CONFIG_MMC_SPI) || defined(CONFIG_MMC_SPI_MODULE)
#define MMC_SPI_CARD_DETECT_INT IRQ_PG11
static int bfin_mmc_spi_init(struct device *dev,
        irqreturn_t (*detect_int)(int, void *), void *data)
{
        return request_irq(MMC_SPI_CARD_DETECT_INT, detect_int,
                IRQF_TRIGGER_FALLING, "mmc-spi-detect", data);
}
 
static void bfin_mmc_spi_exit(struct device *dev, void *data)
{
        free_irq(MMC_SPI_CARD_DETECT_INT, data);
}
 
static struct mmc_spi_platform_data bfin_mmc_spi_pdata = {
        .init = bfin_mmc_spi_init,
        .exit = bfin_mmc_spi_exit,
        .detect_delay = 100, /* msecs */
};
 
static struct bfin5xx_spi_chip mmc_spi_chip_info = {
        .enable_dma = 0,
        .bits_per_word = 8,
};
#endif

#if defined(CONFIG_SPI_SPIDEV) || defined(CONFIG_SPI_SPIDEV_MODULE)
static struct bfin5xx_spi_chip spidev_chip_info = {
	.enable_dma = 0,
	.bits_per_word = 8,
};
#endif

static struct spi_board_info bfin_spi_board_info[] __initdata = {
#if defined(CONFIG_MTD_M25P80) || defined(CONFIG_MTD_M25P80_MODULE)
  {
    /* the modalias must be the same as spi device driver name */
    .modalias = "m25p80", /* Name of spi_driver for this device */
    .max_speed_hz = 25000000,     /* max spi clock (SCK) speed in HZ */
    .bus_num = 0, /* Framework bus number */
    .chip_select = 2, /* On BF518F-EZBRD it's SPI0_SSEL2 */
    .platform_data = &bfin_spi_flash_data,
    .controller_data = &spi_flash_chip_info,
    .mode = SPI_MODE_3,
  },
#endif
#if defined(CONFIG_MMC_SPI) || defined(CONFIG_MMC_SPI_MODULE)
	{
		.modalias = "mmc_spi",
		.max_speed_hz = 20000000,     /* max spi clock (SCK) speed in HZ */
		.bus_num = 0,
		.chip_select = 1,
		.platform_data = &bfin_mmc_spi_pdata,
		.controller_data = &mmc_spi_chip_info,
		.mode = SPI_MODE_3,
	},
#endif
#if defined(CONFIG_SPI_SPIDEV) || defined(CONFIG_SPI_SPIDEV_MODULE)
	{
		.modalias = "spidev",
		.max_speed_hz = 3125000,     /* max spi clock (SCK) speed in HZ */
		.bus_num = 0,
		.chip_select = 1,
		.controller_data = &spidev_chip_info,
	},
#endif
};

/* SPI controller data */
#if defined(CONFIG_SPI_BFIN5XX) || defined(CONFIG_SPI_BFIN5XX_MODULE)
static struct bfin5xx_spi_master bfin_spi0_info = {
	.num_chipselect = 6,
	.enable_dma = 1,  /* master has the ability to do dma transfer */
	.pin_req = {P_SPI0_SCK, P_SPI0_MISO, P_SPI0_MOSI, 0},
};

static struct resource bfin_spi0_resource[] = {
	[0] = {
		.start = SPI0_REGBASE,
		.end   = SPI0_REGBASE + 0xFF,
		.flags = IORESOURCE_MEM,
		},
	[1] = {
		.start = CH_SPI0,
		.end   = CH_SPI0,
		.flags = IORESOURCE_DMA,
	},
	[2] = {
		.start = IRQ_SPI0,
		.end   = IRQ_SPI0,
		.flags = IORESOURCE_IRQ,
	},
};

static struct platform_device bfin_spi0_device = {
	.name = "bfin-spi",
	.id = 0, /* Bus number */
	.num_resources = ARRAY_SIZE(bfin_spi0_resource),
	.resource = bfin_spi0_resource,
	.dev = {
		.platform_data = &bfin_spi0_info, /* Passed to driver */
	},
};
#endif  /* spi master and devices */

#if defined(CONFIG_SERIAL_BFIN) || defined(CONFIG_SERIAL_BFIN_MODULE)
#ifdef CONFIG_SERIAL_BFIN_UART0
static struct resource bfin_uart0_resources[] = {
	{
		.start = UART0_THR,
		.end = UART0_GCTL+2,
		.flags = IORESOURCE_MEM,
	},
	{
		.start = IRQ_UART0_TX,
		.end = IRQ_UART0_TX,
		.flags = IORESOURCE_IRQ,
	},
	{
		.start = IRQ_UART0_RX,
		.end = IRQ_UART0_RX,
		.flags = IORESOURCE_IRQ,
	},
	{
		.start = IRQ_UART0_ERROR,
		.end = IRQ_UART0_ERROR,
		.flags = IORESOURCE_IRQ,
	},
	{
		.start = CH_UART0_TX,
		.end = CH_UART0_TX,
		.flags = IORESOURCE_DMA,
	},
	{
		.start = CH_UART0_RX,
		.end = CH_UART0_RX,
		.flags = IORESOURCE_DMA,
	},
};

unsigned short bfin_uart0_peripherals[] = {
	P_UART0_TX, P_UART0_RX, 0
};

static struct platform_device bfin_uart0_device = {
	.name = "bfin-uart",
	.id = 0,
	.num_resources = ARRAY_SIZE(bfin_uart0_resources),
	.resource = bfin_uart0_resources,
	.dev = {
		.platform_data = &bfin_uart0_peripherals, /* Passed to driver */
	},
};
#endif
#ifdef CONFIG_SERIAL_BFIN_UART1
static struct resource bfin_uart1_resources[] = {
	{
		.start = UART1_THR,
		.end = UART1_GCTL+2,
		.flags = IORESOURCE_MEM,
	},
	{
		.start = IRQ_UART1_TX,
		.end = IRQ_UART1_TX,
		.flags = IORESOURCE_IRQ,
	},
	{
		.start = IRQ_UART1_RX,
		.end = IRQ_UART1_RX,
		.flags = IORESOURCE_IRQ,
	},
	{
		.start = IRQ_UART1_ERROR,
		.end = IRQ_UART1_ERROR,
		.flags = IORESOURCE_IRQ,
	},
	{
		.start = CH_UART1_TX,
		.end = CH_UART1_TX,
		.flags = IORESOURCE_DMA,
	},
	{
		.start = CH_UART1_RX,
		.end = CH_UART1_RX,
		.flags = IORESOURCE_DMA,
	},
};

unsigned short bfin_uart1_peripherals[] = {
	P_UART1_TX, P_UART1_RX, 0
};

static struct platform_device bfin_uart1_device = {
	.name = "bfin-uart",
	.id = 1,
	.num_resources = ARRAY_SIZE(bfin_uart1_resources),
	.resource = bfin_uart1_resources,
	.dev = {
		.platform_data = &bfin_uart1_peripherals, /* Passed to driver */
	},
};
#endif
#endif

#if defined(CONFIG_BFIN_SIR) || defined(CONFIG_BFIN_SIR_MODULE)
#ifdef CONFIG_BFIN_SIR0
static struct resource bfin_sir0_resources[] = {
	{
		.start = 0xFFC00400,
		.end = 0xFFC004FF,
		.flags = IORESOURCE_MEM,
	},
	{
		.start = IRQ_UART0_RX,
		.end = IRQ_UART0_RX+1,
		.flags = IORESOURCE_IRQ,
	},
	{
		.start = CH_UART0_RX,
		.end = CH_UART0_RX+1,
		.flags = IORESOURCE_DMA,
	},
};

static struct platform_device bfin_sir0_device = {
	.name = "bfin_sir",
	.id = 0,
	.num_resources = ARRAY_SIZE(bfin_sir0_resources),
	.resource = bfin_sir0_resources,
};
#endif
#ifdef CONFIG_BFIN_SIR1
static struct resource bfin_sir1_resources[] = {
	{
		.start = 0xFFC02000,
		.end = 0xFFC020FF,
		.flags = IORESOURCE_MEM,
	},
	{
		.start = IRQ_UART1_RX,
		.end = IRQ_UART1_RX+1,
		.flags = IORESOURCE_IRQ,
	},
	{
		.start = CH_UART1_RX,
		.end = CH_UART1_RX+1,
		.flags = IORESOURCE_DMA,
	},
};

static struct platform_device bfin_sir1_device = {
	.name = "bfin_sir",
	.id = 1,
	.num_resources = ARRAY_SIZE(bfin_sir1_resources),
	.resource = bfin_sir1_resources,
};
#endif
#endif

#if defined(CONFIG_I2C_BLACKFIN_TWI) || defined(CONFIG_I2C_BLACKFIN_TWI_MODULE)
static struct resource bfin_twi0_resource[] = {
	[0] = {
		.start = TWI0_REGBASE,
		.end   = TWI0_REGBASE,
		.flags = IORESOURCE_MEM,
	},
	[1] = {
		.start = IRQ_TWI,
		.end   = IRQ_TWI,
		.flags = IORESOURCE_IRQ,
	},
};

static struct platform_device i2c_bfin_twi_device = {
	.name = "i2c-bfin-twi",
	.id = 0,
	.num_resources = ARRAY_SIZE(bfin_twi0_resource),
	.resource = bfin_twi0_resource,
};
#endif

/* I/O Expander - ADP5588 */

#if defined(CONFIG_KEYBOARD_ADP5588) || defined(CONFIG_KEYBOARD_ADP5588_MODULE)
static const unsigned short adp5588_keymap[ADP5588_KEYMAPSIZE] = {
  [0]  = KEY_F1,
  [1]  = KEY_F2,
  [2]  = KEY_F3,
	[10] = KEY_F4,
	[11] = KEY_F5,
  [12] = KEY_F6,
  [20] = KEY_F7,
	[21] = KEY_F8,
	[22] = KEY_F9,
	[30] = KEY_KPASTERISK,
	[31] = KEY_F10,
	[32] = KEY_DOT,
};

static const struct adp5588_gpi_map adp5588_gpimap[] = {
        /* Navigation Switch (TPA511GLFS) */
        {
                .pin    = GPI_PIN_ROW4, /* left */
		.sw_evt = KEY_1,
        }, {
                .pin    = GPI_PIN_ROW5, /* right */
		.sw_evt = KEY_2,
        }, {
                .pin    = GPI_PIN_ROW6, /* down */
		.sw_evt = KEY_3,
        }, {
                .pin    = GPI_PIN_ROW7, /* up */
		.sw_evt = KEY_4,
        }, {
                .pin    = GPI_PIN_COL9, /* select */
		.sw_evt = KEY_5,
        }, {
        /* GP Buttons */
                .pin    = GPI_PIN_COL6, /* right GP button (designator S502)*/
		.sw_evt = KEY_6,
        }, {
                .pin    = GPI_PIN_COL7, /* left GP button (designator S503)*/
		.sw_evt = KEY_7,
        }
};

static const struct adp5588_gpio_platform_data adp5588_gpomap = {
        .gpio_start = 50,
};

static struct adp5588_kpad_platform_data adp5588_kpad_data = {
	.rows		= 4,
	.cols		= 3,
	.keymap		= adp5588_keymap,
	.keymapsize	= ARRAY_SIZE(adp5588_keymap),
	.repeat		= 0,
	.gpimap		= adp5588_gpimap,
	.gpimapsize	= ARRAY_SIZE(adp5588_gpimap),
	.gpio_data	= &adp5588_gpomap,
};
#endif

/* Devices allocation on I2C bus */

static struct i2c_board_info __initdata bfin_i2c_board_info[] = {
#if defined(CONFIG_KEYBOARD_ADP5588) || defined(CONFIG_KEYBOARD_ADP5588_MODULE)
	{
		I2C_BOARD_INFO("adp5588-keys", 0x34),
		.irq = IRQ_PH6,
		.platform_data = (void *)&adp5588_kpad_data,
	},
#endif
};

static const unsigned int cclk_vlev_datasheet[] =
{
	VRPAIR(VLEV_100, 400000000),
	VRPAIR(VLEV_105, 426000000),
	VRPAIR(VLEV_110, 500000000),
	VRPAIR(VLEV_115, 533000000),
	VRPAIR(VLEV_120, 600000000),
};

static struct bfin_dpmc_platform_data bfin_dmpc_vreg_data = {
	.tuple_tab = cclk_vlev_datasheet,
	.tabsize = ARRAY_SIZE(cclk_vlev_datasheet),
	.vr_settling_time = 25 /* us */,
};

static struct platform_device bfin_dpmc = {
	.name = "bfin dpmc",
	.dev = {
		.platform_data = &bfin_dmpc_vreg_data,
	},
};

#if defined(CONFIG_SND_BF5XX_I2S) || defined(CONFIG_SND_BF5XX_I2S_MODULE)

#define SPORT_REQ(x) \
	[x] = {P_SPORT##x##_TFS, P_SPORT##x##_DTPRI, P_SPORT##x##_TSCLK, \
		P_SPORT##x##_RFS, P_SPORT##x##_DRPRI, P_SPORT##x##_RSCLK, 0}

static const u16 bfin_snd_pin[][7] = {
	SPORT_REQ(0),
	SPORT_REQ(1),
};

static struct bfin_snd_platform_data bfin_snd_data[] = {
	{
		.pin_req = &bfin_snd_pin[0][0],
	},
	{
		.pin_req = &bfin_snd_pin[1][0],
	},
};

#define BFIN_SND_RES(x) \
	[x] = { \
		{ \
			.start = SPORT##x##_TCR1, \
			.end = SPORT##x##_TCR1, \
			.flags = IORESOURCE_MEM \
		}, \
		{ \
			.start = CH_SPORT##x##_RX, \
			.end = CH_SPORT##x##_RX, \
			.flags = IORESOURCE_DMA, \
		}, \
		{ \
			.start = CH_SPORT##x##_TX, \
			.end = CH_SPORT##x##_TX, \
			.flags = IORESOURCE_DMA, \
		}, \
		{ \
			.start = IRQ_SPORT##x##_ERROR, \
			.end = IRQ_SPORT##x##_ERROR, \
			.flags = IORESOURCE_IRQ, \
		} \
	}

static struct resource bfin_snd_resources[][4] = {
	BFIN_SND_RES(0),
	BFIN_SND_RES(1),
};
#endif

#if defined(CONFIG_SND_BF5XX_I2S) || defined(CONFIG_SND_BF5XX_I2S_MODULE)
static struct platform_device bfin_i2s_pcm = {
	.name = "bfin-i2s-pcm-audio",
	.id = -1,
};
#endif

#if defined(CONFIG_SND_BF5XX_SOC_AD73311) || defined(CONFIG_SND_BF5XX_SOC_AD73311_MODULE)
static const unsigned ad73311_gpio[] = {
	GPIO_PH7,
};

static struct platform_device bfin_ad73311_machine = {
	.name = "bfin-snd-ad73311",
	.id = 1,
	.dev = {
		.platform_data = (void *)ad73311_gpio,
	},
};
#endif

#if defined(CONFIG_SND_SOC_AD73311) || defined(CONFIG_SND_SOC_AD73311_MODULE)
static struct platform_device bfin_ad73311_codec_device = {
	.name = "ad73311",
	.id = -1,
};
#endif

#if defined(CONFIG_SND_BF5XX_SOC_I2S) || defined(CONFIG_SND_BF5XX_SOC_I2S_MODULE)
static struct platform_device bfin_i2s = {
	.name = "bfin-i2s",
	.id = CONFIG_SND_BF5XX_SPORT_NUM,
	.num_resources = ARRAY_SIZE(bfin_snd_resources[CONFIG_SND_BF5XX_SPORT_NUM]),
	.resource = bfin_snd_resources[CONFIG_SND_BF5XX_SPORT_NUM],
	.dev = {
		.platform_data = &bfin_snd_data[CONFIG_SND_BF5XX_SPORT_NUM],
	},
};
#endif

static struct platform_device *stamp_devices[] __initdata = {

	&bfin_dpmc,

#if defined(CONFIG_RTC_DRV_BFIN) || defined(CONFIG_RTC_DRV_BFIN_MODULE)
	&rtc_device,
#endif

#if defined(CONFIG_BFIN_MAC) || defined(CONFIG_BFIN_MAC_MODULE)
	&bfin_mii_bus,
	&bfin_mac_device,
#endif

#if defined(CONFIG_SPI_BFIN5XX) || defined(CONFIG_SPI_BFIN5XX_MODULE)
	&bfin_spi0_device,
#endif

#if defined(CONFIG_SERIAL_BFIN) || defined(CONFIG_SERIAL_BFIN_MODULE)
#ifdef CONFIG_SERIAL_BFIN_UART0
	&bfin_uart0_device,
#endif
#ifdef CONFIG_SERIAL_BFIN_UART1
	&bfin_uart1_device,
#endif
#endif

#if defined(CONFIG_BFIN_SIR) || defined(CONFIG_BFIN_SIR_MODULE)
#ifdef CONFIG_BFIN_SIR0
	&bfin_sir0_device,
#endif
#ifdef CONFIG_BFIN_SIR1
	&bfin_sir1_device,
#endif
#endif

#if defined(CONFIG_I2C_BLACKFIN_TWI) || defined(CONFIG_I2C_BLACKFIN_TWI_MODULE)
	&i2c_bfin_twi_device,
#endif
/*
#if defined(CONFIG_MTD_PHYSMAP) || defined(CONFIG_MTD_PHYSMAP_MODULE)
	&ezbrd_flash_device,
#endif
*/
#if defined(CONFIG_SND_BF5XX_I2S) || defined(CONFIG_SND_BF5XX_I2S_MODULE)
	&bfin_i2s_pcm,
#endif

#if defined(CONFIG_SND_BF5XX_SOC_AD73311) || defined(CONFIG_SND_BF5XX_SOC_AD73311_MODULE)
	&bfin_ad73311_machine,
#endif

#if defined(CONFIG_SND_SOC_AD73311) || defined(CONFIG_SND_SOC_AD73311_MODULE)
	&bfin_ad73311_codec_device,
#endif

#if defined(CONFIG_SND_BF5XX_SOC_I2S) || defined(CONFIG_SND_BF5XX_SOC_I2S_MODULE)
	&bfin_i2s,
#endif
};

static int __init ezbrd_init(void)
{
	printk(KERN_INFO "%s(): registering device resources\n", __func__);
	i2c_register_board_info(0, bfin_i2c_board_info,
				ARRAY_SIZE(bfin_i2c_board_info));
	platform_add_devices(stamp_devices, ARRAY_SIZE(stamp_devices));
	spi_register_board_info(bfin_spi_board_info, ARRAY_SIZE(bfin_spi_board_info));
	/* 
setup BF518-EZBRD GPIO pin PG11 to AMS2, PG15 to AMS3.
	peripheral_request(P_AMS2, "ParaFlash");
#if !defined(CONFIG_SPI_BFIN5XX) && !defined(CONFIG_SPI_BFIN5XX_MODULE)
	peripheral_request(P_AMS3, "ParaFlash");
#endif
*/
	return 0;
}

arch_initcall(ezbrd_init);

static struct platform_device *ezbrd_early_devices[] __initdata = {

#if defined(CONFIG_SERIAL_BFIN_CONSOLE) || defined(CONFIG_EARLY_PRINTK)
#ifdef CONFIG_SERIAL_BFIN_UART0
	&bfin_uart0_device,
#endif
#ifdef CONFIG_SERIAL_BFIN_UART1
	&bfin_uart1_device,
#endif
#endif
};

void __init native_machine_early_platform_add_devices(void)
{
	printk(KERN_INFO "register early platform devices\n");
	early_platform_add_devices(ezbrd_early_devices,
		ARRAY_SIZE(ezbrd_early_devices));
}

void native_machine_restart(char *cmd)
{
	/* workaround reboot hang when booting from SPI */
	if ((bfin_read_SYSCR() & 0x7) == 0x3)
		bfin_reset_boot_spi_cs(P_DEFAULT_BOOT_SPI_CS);
}

void bfin_get_ether_addr(char *addr)
{
	/* the MAC is stored in OTP memory page 0xDF */
	u32 ret;
	u64 otp_mac;
	u32 (*otp_read)(u32 page, u32 flags, u64 *page_content) = (void *)0xEF00001A;

	ret = otp_read(0xDF, 0x00, &otp_mac);
	if (!(ret & 0x1)) {
		char *otp_mac_p = (char *)&otp_mac;
		for (ret = 0; ret < 6; ++ret)
			addr[ret] = otp_mac_p[5 - ret];
	}
}
EXPORT_SYMBOL(bfin_get_ether_addr);
