julioamerico/blackfin-ip-phone-hw/(commit log)

2010-02-16 Criação da pasta, já contendo todos os arquivos do projeto da placa de referência.
    [A0217-2008.pcb, ASSYDWGBOT.dwg, ASSYDWGTOP.dwg, CENTROID.xls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]
2010-02-23 Inserido o documento.
    [CODEC Selection Guide (Analog Devices).xls]
2010-02-27 - Criados todos os documentos do Altium associados ao projeto. - Inseridas geometria e simbologia do processador.
    [blackfin.PrjPCB, blackfin_a_sdram.SchDoc, blackfin_b_flash.SchDoc, blackfin_c_ethernet.SchDoc, blackfin_d_codec.SchDoc, blackfin_pcb.PcbDoc]
2010-02-27 - Definido o uso do CODEC AD73311L. - Retirado o PHY KSZ8041NL, pois tem encaspulamento QFN, o que vai contra as especificações do projeto.
2010-02-27 Inseridos datasheet e reference design do PHY DP8348C.
    [national_dp83848jandk_bom.xlsx]
2010-03-01 - Alterada a cor de fundo do sheet. - Inserido o bloco A da simbologia do processador.
    [blackfin_a_sdram.SchDoc]
2010-03-01 - Alterada a cor de fundo do sheet. - Inserido o bloco B da simbologia do processador.
    [blackfin_b_flash.SchDoc]
2010-03-01 - Alterada a cor de fundo do sheet. - Inseridos a simbologia do bloco C processador, RJ-45. - Inserida a simbologia do PHY e feitas as ligações de alguns de seus pinos. - Inserido o oscilador de 25MH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
    [blackfin_c_ethernet.SchDoc]
2010-03-01 - Alterada a cor de fundo do sheet. - Inserida a simbologia do CODEC.
    [blackfin_d_codec.SchDoc]
2010-03-01 - Alterada a cor de fundo do sheet. - Inserida a simbologia do bloco D do processador.
    [blackfin_e_power.SchDoc]
2010-03-01 Criados os footprints C_0402, C_0603, C_0805, C_CASE_A, LQFP-48, L_0402, L_0603, L_0805, OSC_25MHZ, RJ-45, R_0402, R_0603, R_0805 e SOIC-20.
2010-03-01 Criadas as simbologias AD73311L, ADSP-BF516, Capacitor, Capacitor_Pol, DP83848C, Inductor, LED, Oscillator, Resistor, RJ-45 e XTAL.
2010-03-01 - Foi feita a ligação dos sinais UTP ao RJ-45 - Inserido o FBEAD entre GND e EARTH. - Inserido resistor NP no pino 40 do PHY, o que pode configurar os leds para outros modos de funcionamento.
    [blackfin_c_ethernet.SchDoc]
2010-03-01 O sheet blackfin_e_power.schdoc foi incluído no projeto.
    [blackfin.PrjPCB]
2010-03-02 - Inseridos os parâmetros dos resistores de 50R e 49R9. - Conectados os capacitores de 100nF aos taps dos transformadores do RJ-45. - Inseridos os resistores de 50R nas linhas output da interface MII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
    [blackfin_c_ethernet.SchDoc]
2010-03-03 Associado o footprint LED_0603 a simbologia LED.
2010-03-03 Criado o footprint LED_0603.
2010-03-03 - Inseridas notas PCB Guideline (Route), PCB Guideline (Placement) e Strap Options (PHY Ethernet). - Inserido LED e resistor série de 130R ligados ao pino LED_ACT/COL. - Inseridos ports RESET, PWR_DO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
    [blackfin_c_ethernet.SchDoc]
2010-03-04 Inserido o port PHY_OPT_CLK.
    [blackfin_a_sdram.SchDoc]
2010-03-04 - Inserido o net PHY_INT. - Inserido o port PHY_OPT_CLK.
    [blackfin_c_ethernet.SchDoc]
2010-03-07 - Inseridos os ports da interface SPORT. - Inseridos os resistores de terminação série. - Inseridas as notas PCB Guideline (Placement). - Inserido o oscilador de 16.384MHz.
    [blackfin_d_codec.SchDoc]
2010-03-07 - Inserido o DIP Switch para seleção de BOOT MODE. - Inseridos os ports da interface SPORT. - Inserida a memória FLASH. - Inseridos os ports da interface SPI. - Inserido o RS-232 Transceiver, bem com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
    [blackfin_b_flash.SchDoc]
2010-03-07 - Alterado o tipo elétrico do port PWR_DOWN para INPUT. - Inseridos resistores para terminação série em todas as linhas da interface MII. - Inseridos os ports das interfaces UART e SPI. - Inseridos o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
    [blackfin_c_ethernet.SchDoc]
2010-03-07 - Criados os footprints DIP SWITCH, ISC_16.384MHZ, SO-16, SOIC-8 e TP.
2010-03-07 - Criadas as simbologias DIP Switch, Oscillator_16.384MHz, RS-232 Transceiver, S25FL032P e Test Point.
2010-03-07 - Retirado o bloco SDCARD e sua interface de conexão, RSI, do processador. - Alterada a interface SPORT0 para SPORT1, a qual está conectada ao CODEC de áudio. - Alterado o P/N do RS-232 Transceiver. 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
2010-03-09 Alterado o nome do footprint de SOIC-8 para SOIC-16.
2010-03-09 Após correção do nome do footprint, foi associado o footprint SOIC-16 a simbologia RS-232 Transceiver.
2010-03-09 Após correção do nome do footprint e inserção na simbologia, foi associado o footprint SOIC-16 ao SN65C3232EDR.
    [blackfin_b_flash.SchDoc]
2010-03-09 Inserida a simbologia JTAG Connector.
2010-03-09 - Inseridos resistores de pull-up nas linhas SPI_MISO e SPI_MOSI. - Inserido resistor de pull-down na linha SPI_CLK. - Substituídos os resistores de pull-up das linhas SPI por 10K. - Inserido o conec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
    [blackfin_b_flash.SchDoc]
2010-03-09 Inserido o footprint Header_2x7.
2010-03-09 Especificados os resistores de 10K.
    [blackfin_b_flash.SchDoc]
2010-03-21 Inserido o footprint TSOP-54 da memória SDRAM.
2010-03-21 Inseridas as simbologias FT2232D e K4S561632J. Além disso foram preenchidos os parâmetros desses componentes e atribuído seu footprint.
2010-03-21 Foram feitas todas as ligações entre a memória SDRAM e o processador.
    [blackfin_a_sdram.SchDoc]
2010-03-21 - Inseridos testpoint nos pinos do processador que dão suporte a memória assíncrona. - Pino NMI# (147) do processador foi posto em pull-up.
    [blackfin_a_sdram.SchDoc]
2010-03-21 - Inserido o FT2232D e circuitos adjacentes. - Inseridos símbolos de NO ERC em alguns pinos do SN65C3232EDR.
    [blackfin_b_flash.SchDoc]
2010-03-21 Ligado o port RESET# (output) ao pino 34 do processador.
    [blackfin_c_ethernet.SchDoc]
2010-03-21 Criados os footprints SOIC-8 e USB Connector.
2010-03-21 Criadas as simbologias AT93C56A, FT2232D, K4S561632J e USB Connector.
2010-03-25 Alterado o nome do arquivo para blackfin_b_flash_jtag_serial.
    [blackfin_b_flash_jtag_serial.SchDoc]
2010-03-25 Alterado o nome do sheet blackfin_b.
    [blackfin.PrjPCB]
2010-03-25 Alterado o nome do sheet blackfin_f.
    [blackfin_f_power.SchDoc]
2010-03-25 Inserido o sheet blackfin_e_lcd_keypad no repositório.
    [blackfin_e_lcd_keypad.SchDoc]
2010-03-25 Associado o sheet blackfin_e_lcd_keypad ao projeto.
    [blackfin.PrjPCB]
2010-03-26 Criada a seção AMPLIFICADORES DE ÁUDIO e o link da Analog Devices contendo seus dispositivos.
2010-03-28 - Inseridas as simbologias CAT811S, Keypad, LCD e Push Button. - Associado o footprint OSC_25MHz a simbologia Oscillator_25MHz após alterações. - Associado o footprint XTAL_32.768kHz a simbologia XTA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
2010-03-28 - Alterado o footprint OSC_25MHz. - Inseridos os footprints OSC_16.384MHz, Push Button, SOT-143 e XTAL_32.768kHz.
2010-03-28 - Inserido o oscilador de 25MHz bem como seu capacitor de desacoplamento e resistor série na saída. - Inserido TP no pino XTAL (144) do processador. - Inseridos os ports POWER_GOOD e EXT_WAKE a serem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
    [blackfin_a_sdram.SchDoc]
2010-03-28 Inserida nota na seção de notas PCB Guideline (Routing).
    [blackfin_c_ethernet.SchDoc]
2010-03-28 - Inseridos os capacitores de desacoplamento - Inserida uma nota temporária indicando a necessidade de utilizar os ports POWER_GOOD e EXT_WAKE.
    [blackfin_f_power.SchDoc]
2010-03-28 Elaborado parte do circuito de alimentação do RTC.
    [blackfin_f_power.SchDoc]
2010-03-28 Inseridos os footprints SOT-26 e Supercapacitor.
2010-04-01 Inserido o documento 87759-0614 (RS-232 connector) no repositório.
2010-04-01 Criada a pasta linear and switching regulators e inserido o documento AME8800AEETZ no repositório.
2010-04-01 - Renomeada a pasta embedded systems. - Criada a pasta specifications and standards. - Inserido o arquivo The I2C Bus Specification.
2010-04-01 - Criada a pasta lcd e inserido o datasheet NHD-0420D3Z-FL-GBW no repositório. - Inseridos os datasheets DW-03-13-F-S-845, DW-05-13-F-S-845, DW-06-13-F-S-845 (LCD headers) e SSM-116-L-SV (LCD recepta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
2010-04-01 - Inseridos os ports SCL e SDA bem como os resistores de pull-up e terminação série nessas linhas. - Inserida a nota PCB Guideline (Routing) relativa ao dimensionamento dos resistores de terminação s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
    [blackfin_b_flash_jtag_serial.SchDoc]
2010-04-01 As nets e ports do projeto foram configuradas para serem do tipo global. Desse modo, foram excluídos os nets redundantes nas linhas UART_TX e UART_RX.
    [blackfin_b_flash_jtag_serial.SchDoc]
2010-04-01 Foi alterada a configuração do projeto para que todas as nets e ports sejam globais e os ports possam nomear as nets, de modo que é desnecessário o uso simultâneo de ports e nets numa mesma linha.
    [blackfin.PrjPCB]
2010-04-01 Foram associados TPs aos pinos 36, 37 e 38 do processador.
    [blackfin_c_ethernet.SchDoc]
2010-04-02 Preenchidos alguns campos da legenda do sheet.
    [blackfin_a_sdram.SchDoc]
2010-04-02 - Preenchidos alguns campos da legenda do sheet. - Inseridos os itens SCREW (para LCD e Keypad), SPACER (para LCD e Keypad), BOARD FOOT. - Inseridos o LCD e o Keypad. - Todos os itens inseridos já co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
    [blackfin_e_lcd_keypad.SchDoc]
2010-04-02 - Inseridas as simbologias ADP5588, AME8800AEETZ, Board Foot, Keypad_Connector, LCD_Connector, LCD_Header_1x3, LCD_Header_1x5, LCD_Header_1x6, Screw e Spacer. - Alteradas as simbologias LCD e Keypad.
2010-04-02 Inseridas as simbologias Board Foot, Header_2x3, QFN-24 e SOT-23.
2010-04-03 Inseridos os blocos do FTDI, USB Connector, Keypad e LCD.
2010-04-06 - Inseridos os resistores de 22R nas linhas da SDRAM. - Criada a seção PCB Guideline (Placement) e inserida a nota relativa ao posicionamento dos resistore para terminação série de 22R.
    [blackfin_a_sdram.SchDoc]
2010-04-06 O led e o resistor associados a tensão VCC3V3_USB foram indicados como não populados (NP).
    [blackfin_b_flash_jtag_serial.SchDoc]
2010-04-08 Alterada a disposição dos componentes no sheet para facilitar a visualização.
    [blackfin_a_sdram.SchDoc]
2010-04-09 Foi feita a imagem para facilitar a visualização da montagem do lcd, keypad e da placa.
    [blackfin_e_lcd_keypad.SchDoc]
2010-04-10 Concluída a visualização 3D do sistema feita no esquemático para melhor compreensão de como os elementos desse esquemático serão montados.
    [blackfin_e_lcd_keypad.SchDoc]
2010-04-10 Foram feitas pequenas modificações na visualização 3D.
    [blackfin_e_lcd_keypad.SchDoc]
2010-04-10 Renomeado o documento RJ-45.pdf para J1012F01C.pdf.
2010-04-11 Alterados os parâmetros do LCD.
    [blackfin_e_lcd_keypad.SchDoc]
2010-04-11 Especificado resistor de 470R.
    [blackfin_b_flash_jtag_serial.SchDoc]
2010-04-14 - Alterada a tensão de alimentação do ADP5588 para VCC2V5. - Criada a pasta doc e inserida a planilha Power Supply.xlsx.
    [Power Supply.xlsx, blackfin_e_lcd_keypad.SchDoc]
2010-04-18 Criados os fooprints KEYPAD, LCD, SOCKET_1X7 e SOCKET_1X16.
2010-04-19 - Associados os footprints as simbologias KEYPAD, LCD e LCD_CONNECTOR. - Inseridos os parâmetros das simbologias KEYPAD_CONNECTOR. - Criada a simbologia KEYPAD_HEADER_1X7.
2010-04-19 Definidas as dimensões da placa e posicionados os footprints do LCD e do KEYPAD.
    [blackfin_pcb.PcbDoc]
2010-04-19 - Inserida a simbologia KEYPAD_HEADER_1X7. - Associados os footprints aos componentes LCD, KEYPAD, LCD_CONNECTOR e KEYPAD_CONNECTOR.
    [blackfin_e_lcd_keypad.SchDoc]
2010-04-22 Corrigido o parâmetro Part# do resistor de 470R.
    [blackfin_b_flash_jtag_serial.SchDoc]
2010-04-22 Corrigido o parâmetro eVendor do cristal de 32.768KHz.
    [blackfin_a_sdram.SchDoc]
2010-05-10 Criada a pasta 12-04-2010 e inseridos os documentos referentes a 1a compra.
    [Planilha.xls]
2010-05-13 Inserido o arquivo estoque.xls no repositório.
    [estoque.xls]
2010-05-17 Excluída a pasta 04-12-2010.
    [Planilha.xls]
2010-05-17 Inseridos no estoque as amostras de conectores SAMTEC.
    [estoque.xls]
2010-05-28 Retirados 4 resistores de 130R e 1 push button.
    [estoque.xls]
2010-05-30 Excluído o circuito do RTC. Será refeito posteriormente utilizando menos componentes.
    [blackfin_f_power.SchDoc]
2010-05-30 Alterada a alimentação do controlador de keypad devido a incompatibilidade de tensões. Além disso, foram colocadas as dimensões da PCB na figura ilustrativa.
    [blackfin_e_lcd_keypad.SchDoc]
2010-05-30 Documento Estimating Power for ADSP-BF534BF536BF537 Blackfin Processors.pdf inserido no repositório.
2010-05-30 Inserida no repositório a pasta "Estimating Power for ADSP-BF534BF536BF537 Blackfin Processors".
    [External Power Spreadsheet (Examples).xls, External Power Spreadsheet (Power Graphs).xls]
2010-05-31 Inseridas os valores das correntes de core e consumo externo do processador na planilha Power Supply.xlsx.
    [Power Supply.xlsx]
2010-05-31 Foi feita uma tabela na planilha "External Power Spreadsheet (Examples).xls" indicando o consumo dos periféricos para o projeto Blackfin IP Phone.
    [External Power Spreadsheet (Examples).xls]
2010-06-05 Inseridos no estoque os componentes comprados pelo Fábio Araújo em MAIO de 2010.
    [estoque.xls]
2010-06-13 Inserido link contendo exemplos de código para o processador Blackfin.
2010-06-13 As seguintes alterações foram decorrentes da alteração do processador a ser utilizado no projeto. - Renomeados os documentos ADSP-BF518.pdf e ADSP-BF518 Blackfin Processor Hardware Reference.pdf. - I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
2010-06-13 Devido a troca do processador do projeto, foi necessária a troca do nome do processador na arquitetura de hardware.
2010-06-13 Um dia após ser feita a compra na AVNET, foi alterado o Manufacturer Leat Time, que assumiu um valor que inviabilizaria o projeto. Por isso, foi cancelado o pedido do processador ADSP-BF516BSWZ-3. O 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
2010-06-13 Inserido no repositório o invoice da compra realizada em 18/05/2010. Essa compra foi realizada pelo Fábio Araújo e não foi necessário acrescentar valores de impostos.
    [Planilha.xls]
2010-06-13 - Foi feita a troca do processador em todos os sheets. - A descrição do footprint LQFP-176 foi alterada na pcblib. - Alteradas as simbologias dos conectores JTAG e serial para facilitar a visualizaçã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
    [blackfin_a_sdram.SchDoc, blackfin_b_flash_jtag_serial.SchDoc, blackfin_c_ethernet.SchDoc, blackfin_f_power.SchDoc]
2010-07-02 Criada a pasta linear and switching regulators e inseridos os documentos ESR, Stability, and the LDO Regulator.pdf, Linear and Switching Voltage Regulator Fundamentals.pdf e Understanding Noise in Li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
2010-07-02 Inserido o circuito da fonte do core.
    [blackfin_f_power.SchDoc]
2010-07-02 Criado o footprint SOT-223.
2010-07-02 O template sch_template_a3.SchDot, a ser inserido no repositório na pasta tpl, foi associado a todos os sheets do projeto.
    [blackfin_a_sdram.SchDoc, blackfin_b_flash_jtag_serial.SchDoc, blackfin_c_ethernet.SchDoc, blackfin_d_codec.SchDoc, blackfin_e_lcd_keypad.SchDoc, blackfin_f_power.SchDoc]
2010-07-02 Criado o documento bom_fields.txt para auxiliar na geração da BOM.
2010-07-02 Inseridos alguns parâmetros de todos os conectores SAMTEC.
    [blackfin_e_lcd_keypad.SchDoc]
2010-07-02 Corrigido um dos parâmetros do push-button. O mesmo estava causando problemas na geração da BOM.
    [blackfin_a_sdram.SchDoc]
2010-07-03 Excluído o fooprint SOIC-20, pois esse era o fooptrint associado ao CODEC de áudio. A alteração do part# desse item exige alteração do footprint.
2010-07-03 Criado o footprint TSSOP-20.
2010-07-03 Inseridos todos os parâmetros do AD73311L e alterado seu footprint.
    [blackfin_d_codec.SchDoc]
2010-07-03 - Excluído o footprint SO-16, pois o mesmo era do S25FL032P0XMFI001. A memória FLASH foi alterada para S25FL032P0XMFI010, o que exigiu alteração do footprint. - Criado o footprint SO-8, do S25FL032P0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
2010-07-03 - Alterados os parâmetros e footprint do AD73311LARUZ. - Excluída a simbologia CMXSH-3. - Inseridos os parâmetros de todos os conectores SAMTEC. - Alterado um dos parâmetros do push-button. O mesmo e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
2010-07-03 Alterada a memória FLASH.
    [blackfin_b_flash_jtag_serial.SchDoc]
2010-07-03 Alterada a descrição do footprint TSOP-54 e o formato dos pads.
2010-07-03 Alterada a memória SDRAM.
    [blackfin_a_sdram.SchDoc]
2010-07-03 Inseridos os resistores de configuração do LCD.
    [blackfin_e_lcd_keypad.SchDoc]
2010-07-03 Criada a 1a versão da BOM.
    [blackfin_bom.xls]
2010-07-03 Alterada a posição da pequena tabela contendo os valores de 1 placa, de 1000 placas e a quantidade total de componentes.
2010-07-04 Inseridos os silkscreens dos componentes SMDs passivos (resistores, capacitores e indutores).
2010-07-04 Alterada a simbologia BOARD FOOT.
    [blackfin_e_lcd_keypad.SchDoc]
2010-07-04 Alterada a cor da simbologia do processador.
    [blackfin_a_sdram.SchDoc, blackfin_b_flash_jtag_serial.SchDoc, blackfin_c_ethernet.SchDoc, blackfin_f_power.SchDoc]
2010-07-04 Inserido o documento blackfin_sch.pdf, que é uma versão do esquema elétrico em PDF.
2010-07-05 Alterados os parâmetros do resistor de 10M.
    [blackfin_a_sdram.SchDoc]
2010-07-05 Atualizado o estoque.
    [estoque.xls]
2010-07-05 Criado o footprint BOARD_ID.
2010-07-05 Criadas as simbologias Board e Board_ID.
2010-07-06 Criadas as simbologias Board_Name e Fiducial.
2010-07-06 Criado o footprint Fiducial.
2010-07-06 Inseridos Board_ID, Fiduciais, Board e Board_Name.
    [blackfin_e_lcd_keypad.SchDoc]
2010-07-06 Criadas as simbologias Power_Cord e AC_Adapter.
2010-07-06 Inseridas as simbologias Power_Cord e AC_Adapter.
    [blackfin_f_power.SchDoc]
2010-07-06 Criado o documento Power Supply 3V3 @ 2A.pdf.
2010-07-07 - Associado o footprint Inductor_22uH a simbologia Inductor. - Criada a simbologia TPS5420MDREP.
2010-07-07 Criados os footprints Inductor_22uH, Case_430 e SOIC-8 (TPS5420MDREP).
2010-07-07 Atribuído o footprint C_Case_Y a simbologia Capacitor_Pol.
2010-07-07 Criado o footprint C_Case_Y.
2010-07-07 Foi feita a fonte de 3V3.
    [blackfin_f_power.SchDoc]
2010-07-07 Criado o footprint R_2512.
2010-07-07 Associado o footprint R_2512 a simbologia Resistor.
2010-07-07 Corrigida a ligação do diodo schottky da fonte de 3V3.
    [blackfin_f_power.SchDoc]
2010-07-07 Inserido comentário PCB Guideline (Routing) e criada parte da fonte de 5V.
    [blackfin_f_power.SchDoc]
2010-07-08 Feito o circuito de delay ligado ao pino POWER GOOD do processador.
    [blackfin_a_sdram.SchDoc]
2010-07-08 - Concluídas as fontes chaveadas. - Verificado que não é necessário o uso do port POWER_GOOD, que foi removido e substituído por um circuito de delay no sheet blackfin_a_sdram.SchDoc.
    [blackfin_f_power.SchDoc]
2010-07-10 Criada a geometria Power_Jack.
2010-07-10 Criada a simbologia Power_Jack.
2010-07-10 Corrigido o footprint do Power_Jack.
2010-07-11 Criado o footprint R_1206.
2010-07-11 Associado o footprint R_1206 a simbologia Resistor.
2010-07-11 - Inserido o conector de entrada da fonte, led e diodo schottky. - Pinos de ENABLE dos reguladores foram deixados desconectados.
    [blackfin_f_power.SchDoc]
2010-07-13 Criados os footprints MSOP-10 e SOIC-8 (SSM2211).
2010-07-13 - Inseridos os componentes Phone_Jack, SSM2211, SSM2167 e componentes passivos adjacentes a eles. - Alterado o aterramento do AD73311L. - Inserido resistor NP entre as linhas RX_SYNC e TX_SYNC. - Ins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
    [blackfin_d_codec.SchDoc]
2010-07-15 Criados os footprints MICROPHONE e SPEAKER.
2010-07-15 - Inseridos o microfone e o speaker. - Concluído o sheet blackfin_d_codec.SchDoc.
    [blackfin_d_codec.SchDoc]
2010-07-15 Foi feito o annotate schematic sheet.
    [blackfin_a_sdram.SchDoc, blackfin_b_flash_jtag_serial.SchDoc, blackfin_c_ethernet.SchDoc, blackfin_d_codec.SchDoc, blackfin_e_lcd_keypad.SchDoc, blackfin_f_power.SchDoc]
2010-07-15 Inseridos os capacitores de desacoplamento da SDRAM.
    [blackfin_a_sdram.SchDoc]
2010-07-15 Inseridos os parâmetros dos componentes R148 e C101.
    [blackfin_a_sdram.SchDoc]
2010-07-15 Alterados os parâmetros do componentes BOARD para facilitar na geração da BOM.
    [blackfin_e_lcd_keypad.SchDoc]
2010-07-15 Atualizada a BOM.
    [blackfin_bom.xls]
2010-07-15 Alteradas as referências (0,0) de alguns footprints.
2010-07-15 Iniciado o placement.
    [blackfin_pcb.PcbDoc]
2010-07-15 - Criada a regra para os silks dos componentes passivos. - Feito o pré-placement de alguns componentes. - Alteradas algumas regras devido a erros no DRC.
    [blackfin_pcb.PcbDoc]
2010-07-16 - Foi feito o placement de: # todos os componentes críticos; # todos os conectores; # capacitores de desacoplamento do processador; # capacitores de desacoplamento da SDRAM; # fontes chaveadas e font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
    [blackfin_pcb.PcbDoc]
2010-07-16 Alteradas as referências (0,0) de alguns footprints para facilitar o placement.
2010-07-16 Retirado o led na saída do regulador de tensão. O mesmo é desnecessário já que há um led na entrada do regulador.
    [blackfin_b_flash_jtag_serial.SchDoc]
2010-07-16 Corrigida a simbologia do ADP5588.
    [blackfin_e_lcd_keypad.SchDoc]
2010-07-16 Para facilitar o placement, foram alteradas as ordens dos componentes D601, R610 e D603.
    [blackfin_f_power.SchDoc]
2010-07-16 - Feito o placement de diversos componentes passivos, chaves, cristais, osciladores. - Alterado o placement da fonte da tensão de core. - Alterado o placement dos resistores de terminação série das l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
    [blackfin_pcb.PcbDoc]
2010-07-16 Inseridas as notas NP em alguns resistores de terminação série das linhas de endereço.
    [blackfin_a_sdram.SchDoc]
2010-07-18 Corrigida a ligação dos capacitores de desacoplamento do SSM2167. Os mesmos estavam ligados ao GND, e não ao EARTH.
    [blackfin_d_codec.SchDoc]
2010-07-18 - Alteradas as dimensões da placa para 11 x 15 cm. - Feito o placement de todos os componentes. - Roteada uma parte da memória SDRAM.
    [blackfin_pcb.PcbDoc]
2010-07-18 Substituídas as linhas A11, A14, A15, A16 e A17 por TPs.
    [blackfin_a_sdram.SchDoc]
2010-07-18 Além dos ports UART_TX e UART_RX precisaram ser inseridas as nets UART_TX e UART_RX no circuito da interface serial.
    [blackfin_b_flash_jtag_serial.SchDoc]
2010-07-18 Substituído o port #PWR_DOWN por uma net com o mesmo nome.
    [blackfin_c_ethernet.SchDoc]
2010-07-18 Além dos ports SCL e SDA precisaram ser inseridas as nets SCL e SDA para a comunicação com o LCD.
    [blackfin_e_lcd_keypad.SchDoc]
2010-07-18 Commit do arquivo blackfin.PrjPCB após ter concluído o placement de todos os componentes.
    [blackfin.PrjPCB]
2010-07-19 - Rotacionada a SDRAM. - Feito o placement do circuito de áudio. - Roteado uma parte do circuito de áudio.
    [blackfin_pcb.PcbDoc]
2010-07-19 O conector serial foi espelhado para facilitar o roteamento.
    [blackfin_b_flash_jtag_serial.SchDoc]
2010-07-19 - Roteado uma parte dos circuitos do FT2232D e serial. - Iniciada uma alteração no roteamento da SDRAM para permitir o roteamento dos sinais da interface SPORT pela camada top.
    [blackfin_pcb.PcbDoc]
2010-07-20 - Roteado o cristal do RTC e o oscilador do processador. - Roteado uma parte do PHY ethernet. - Roteado uma parte do conector JTAG e do FT2232D.
    [blackfin_pcb.PcbDoc]
2010-07-31 Inseridos no estoque os componentes que foram comprados em JULHO de 2010 na Digikey.
    [estoque.xls]
2010-07-31 Inseridas no estoque 6 unidades do processador compradas em JUNHO de 2010 através da Analog Devices.
    [estoque.xls]
2010-08-01 Atualizada a planilha de estoque.
    [estoque.xls]
2010-08-19 Criada a pasta 01-07-2010 e inseridos o invoice e a planilha contendo os gastos.
    [Planilha.xls]
2010-09-04 Inseridos nas bibliotecas footprint e simbologia do Conector MicroSD.
2010-09-04 Alterados os parâmetros dos resistores de casamento de impedância.
    [blackfin_a_sdram.SchDoc]
2010-09-04 - Inserido o conector MicroSD. - Alterados os parâmetros dos resistores de casamento de impedância.
    [blackfin_b_flash_jtag_serial.SchDoc]
2010-09-04 - Inserido o port SPI_CS_MICROSD. - Alterados os parâmetros dos resistores de casamento de impedância.
    [blackfin_c_ethernet.SchDoc]
2010-09-04 Alteradas as propriedades de alguns itens para que os mesmos não apareçam na BOM.
    [blackfin_e_lcd_keypad.SchDoc]
2010-09-05 - Inserido resistor de pull-up R239 na linha KEYPAD_INT. - Corrigida a ligação do conector MicroSD. Inseridos os nets relativos a interface SPI próximos a simbologia do conector MicroSD e da Flash.
    [blackfin_b_flash_jtag_serial.SchDoc]
2010-09-05 Inserido resistor de pull-up R328 na linha #RESET.
    [blackfin_c_ethernet.SchDoc]
2010-09-05 Roteado uma parte do PHY ethernet, o conector MicroSD e serial.
    [blackfin_pcb.PcbDoc]
2010-09-06 Roteada toda a fonte.
    [blackfin_pcb.PcbDoc]
2010-09-07 Corrigido o posicionamento dos resistores de terminação série da SDRAM que foram alterados para 0402.
    [blackfin_pcb.PcbDoc]
2010-09-07 Alteradas as nets EARTH para EARTH_ETH para que sejam separadas das nets EARTH do circuito de áudio.
    [blackfin_c_ethernet.SchDoc]
2010-09-07 Inseridos os botões e leds.
    [blackfin_e_lcd_keypad.SchDoc]
2010-09-07 Alteradas as notas PCB Guideline.
    [blackfin_a_sdram.SchDoc]
2010-09-07 Corrigida a posição dos pads do footprint PUSH_BUTTON.
2010-09-07 - Alterada a posição do circuito serial, do conector do MicroSD, do cristal RTC e do oscilador do processador. - Feito o placement e roteamento dos botões de uso geral. - Criados os planos de EARTH, 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
    [blackfin_pcb.PcbDoc]
2010-09-10 - Alterado o placement do PHY. - Roteados os LEDs de propósito geral na borda inferior da placa. - Feito o placement dos fiduciais e do logo do projeto.
    [blackfin_pcb.PcbDoc]
2010-09-10 Commit do projeto após alteração da versão do Altium.
    [blackfin.PrjPCB]
2010-09-10 - Alterado o tipo de alguns componentes como MECHANICAL. - Alterada a posição dos designatos de espaçadores e parafusos. - Alterada a disposição e quantidade dos LEDs de uso geral. - Atribuiído o foo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
    [blackfin_e_lcd_keypad.SchDoc]
2010-09-10 Alterado o tipo de alguns componentes para MECHANICAL.
    [blackfin_f_power.SchDoc]
2010-09-12 Concluído o roteamento. 0 Error, 0 Warning!!! Pronto para iniciar otimização do layout.
    [blackfin.PrjPCB]
2010-09-12 Inserido o silk correspondente ao board foot hemisférico.
2010-09-12 - Alterados os parâmetros e footprint do board foot. - Alterado o designator do conector MicroSD para CON?.
2010-09-12 Preenchidos os valores corretos dos designators nas notas PCB Guideline.
    [blackfin_c_ethernet.SchDoc]
2010-09-12 Alterados os parâmetros e footprint do board foot.
    [blackfin_e_lcd_keypad.SchDoc]
2010-09-14 Inseridos os componentes S500, S501 e S502 bem como resistores de pull-up e TP500.
    [blackfin_pcb.PcbDoc]
2010-09-14 Criado o footprint TPA511GLFS.
2010-09-28 Incluídos no estoque os itens adquiridos em 24-08-2010.
    [estoque.xls]
2010-10-06 Inserida a imagem PCB Top Layer.jpg no repositório.
2010-10-11 Equalizadas as linhas de dados da SDRAM.
    [blackfin_pcb.PcbDoc]
2010-10-19 O port SPI_CS_FLASH foi configurado como saída.
    [blackfin_c_ethernet.SchDoc]
2010-10-19 Corrigidas as notas PCB Guideline.
    [blackfin_d_codec.SchDoc]
2010-10-19 Atualizado o arquivo PCB Top Layer.jpg.
2010-11-13 Criada a pasta ibis contendo os modelos IBIS de todos os componentes do projeto.
2010-11-13 - Foi feito o dimensionamento do stack-up. - Criada regra para controle de impedância com 60 ohms +- 10%.
    [blackfin_pcb.PcbDoc]
2010-11-14 Criada regra para ignorar erros referentes a espessura de trilhas diferentes de 10mils.
    [blackfin_pcb.PcbDoc]
2010-11-15 Net EARTH alterado para EARTH_USB.
    [blackfin_b_flash_jtag_serial.SchDoc]
2010-11-15 Retirados ferrites de costura entre GND e EARTH. Como indicado no datasheet do codec deve existir somente um ponto de costura.
    [blackfin_d_codec.SchDoc]
2010-11-15 - Inserido ferrite de costura para o codec de áudio. - Separados os EARTH da USB e circuito de áudio. - Invertida a polaridade do microfone.
    [blackfin_pcb.PcbDoc]
2010-11-15 Inserido o footprint ESD.
2010-11-15 Inseridos os componentes ESD500 e ESD501.
    [blackfin_e_lcd_keypad.SchDoc]
2010-11-15 Feito o circuito da fonte de 2V5 para alimentação dos pinos OTP.
    [blackfin_f_power.SchDoc]
2010-11-15 Conectado o pino de alimentação do RTC.
    [blackfin_pcb.PcbDoc]
2010-11-15 Alterado o C413 para 100nF.
    [blackfin_d_codec.SchDoc]
2010-11-15 Alterados a configuração dos TPs para Standard (No BOM) para que não apareçam na BOM.
    [blackfin_a_sdram.SchDoc, blackfin_c_ethernet.SchDoc, blackfin_e_lcd_keypad.SchDoc]
2010-11-15 Corrigida a BOM.
    [blackfin_bom.xls]
2010-11-16 Alterado o comment do D601.
    [blackfin_f_power.SchDoc]
2010-11-16 Corrigido o campo eVendorPrice do componente D300.
    [blackfin_c_ethernet.SchDoc]
2010-11-20 Corrigido footprint MICRO_SD. Área proibida foi feita utilizando Top Overlay ao invés de Top Layer.
2010-11-20 Feito o update do footprint do conector Micro_SD.
    [blackfin_pcb.PcbDoc]
2010-11-20 Inserido o port SPI_DET.
    [blackfin_c_ethernet.SchDoc]
2010-11-20 Corrigido o circuito do conector MicroSD.
    [blackfin_b_flash_jtag_serial.SchDoc]
2010-11-20 - Inserido resistor de pull-up na linha SPI_DET. - Port SPI_DET declarado como saída.
    [blackfin_b_flash_jtag_serial.SchDoc]
2010-11-20 Alterado o footprint do MicroSD. Atribuídos os pinos 9 e 10 como COM e SD_DET, respectivamente.
2010-11-20 Inseridos resistores de 0R nas linhas do circuito do conector MicroSD.
    [blackfin_b_flash_jtag_serial.SchDoc]
2011-01-23 Alterada a simbologia do conector MicroSD para melhor representação no esquema elétrico.
2011-01-23 Corrigido novamente o circuito do conector MicroSD. Esse circuito já foi validado!
    [blackfin_b_flash_jtag_serial.SchDoc]
2011-01-24 - Corrigido novamente o circuito do conector MicroSD. Esse circuito já foi validado! - Iniciada a equalização das linhas de endereço da SDRAM.
    [blackfin_pcb.PcbDoc]
2011-01-24 Alterados os footprints LOGO e BOARD_ID.
2011-01-24 Concluída a equalização das linhas de endereço da SDRAM.
    [blackfin_pcb.PcbDoc]
2011-01-24 Alterado o placement do oscilador de 25MHz.
    [blackfin_pcb.PcbDoc]
2011-01-24 Criada a pasta grb e inseridos os arquivos para manufatura da placa.
    [blackfin_pcb.DRL, blackfin_pcb.GBL, blackfin_pcb.GBO, blackfin_pcb.GBP, blackfin_pcb.GBS, blackfin_pcb.GKO, blackfin_pcb.GTL, blackfin_pcb.GTO]
2011-04-25 Foram feitas pequenas alterações na formatação da BOM para incluí-la na documentação do projeto.
    [blackfin_bom.xls]
2011-05-16 Criada a pasta "Relatório de Fabricação das Placas".
2011-06-27 - Inserida versão .docx de tcc_monografia. - Atualizado o arquivo tcc_monografia.pdf.
2011-07-12 Inserido no repositório o driver D2XX do FTDI para o Linux
2011-07-24 Inserido no repositório o código fonte original do uboot.
    [imximage.cfg, kwbimage.cfg]
2011-08-12 Para adaptação da placa ao U-Boot foram editados os arquivos desse commit.
    Após o commit será verificado se é possível fazer o build com sucesso.
    A imagem gerada está de acordo com o boot pela memória flash, além de suportar a interface de rede.
2011-08-12 Inserido no repositório o relatório de firmware.
2011-08-24 - Criada a árvore de diretórios para o código fonte do uClinux. OBS: todos os arquivos que estão sendo comitados correspondem a um perfil básico baseado na placa de referência. Logo deverão ser alter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
2011-09-03 - Alterada a linha de comando referente a carga do bootloader na memoria SDRAM. - Alterado o comando de apagamento da memoria flash. Foi alterado o comprimento do bloco a ser apagado para 0x400000.
2011-10-22 Alterado o arquivo de configuração da placa para suporte pleno do ADP5588 (teclado matricial, botões direcionais, botões de uso geral e LEDs).
2011-10-24 Inseridos no repositório alguns arquivos relacionados ao módulo LCD. - LCDAssistant.zip: aplicativo para geração de caracteres a partir de imagens bitmap. - Serial_LCD.txt: algoritmo com exemplo de u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
2011-11-05 Inseridos no repositório as aplicações de teste do codec, expansor de IOs e LCD.
2011-11-11 - Feitas pequenas alterações na aplicação de teste do LCD. - Criadas outras funções para suporte a outras funcionaildadeso do driver do LCD.
2011-12-26 - Atualizado o arquivo de alocação de recursos de dispositivos da placa. - Inseridas as linhas de alocação do codec de audio.
2012-01-02 Movido o relatório de firmware para a pasta doc.
2012-01-03 Escrita a seção 9.3 que trata sobre a integração entre os códigos-fonte e o repositório.
2012-01-10 Alterado o Makefile para compilação de bf518-ipphone.c.
2012-01-12 Inseridos no repositório os arquivos Makefile.local e Kconfig.local. Os mesmos estão localizados em espaço de usuário onde encontram-se as aplicações do usuário.
2012-01-12 Foi feita a atualização da configuração padrão do kernel. Após essa atualização, as configurações foram copiadas para os arquivos que estão sendo comitados.
2012-01-24 - Criada a pasta da aplicação do projeto. Inicialmente deverá ser feita uma prova de conceito para posterior criação do diretório final onde a aplicação deverá estar localizada. - Início da escrita d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
2012-01-25 Criados os arquivos queue.c e queue.h, que correspondem a implementação da fila de eventos. Essa implementação ainda não foi testada!
2012-01-25 Concluída a escrita da prova de conceito da máquina de estados e da fila de eventos. Essa implementação ainda não foi testada!
2012-02-01 Foram feitas pequenas correções. Ainda há um problema com o ponteiro para função definido em fsm.h.
    [main.c]
2012-02-01 Corrigida a recursividade entre a estrutura da máquina de estados e o typedef das funções em fsm.h.
    [main.c]
2012-02-01 Escritos os Makefiles. A poc da máquina de estados foi compilada com sucesso. Ainda precisa testar!
2012-02-02 - POC da máquina de estados e da fila de eventos realizada com sucesso!!! :D - Foi feita correção na função queue_insert em queue.c. - Retirado o parâmetro relativo ao estado do ponteiro para função 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
2012-02-06 Renomeada a pasta Relatório de Firmware para Firmware, onde deverão ser colocados todos os documentos relacionados ao firmware.
2012-02-08 - Foi realizada a integração entre o LCD e a aplicação. - Criada uma camada de código entre a aplicação e o driver do LCD. - Alterados os Makefiles para suportar a integração do LCD.
2012-02-09 Corrigido o delay no sinal de reset.
2012-02-13 Criado no menu de configuração a aplicação de teste USER_BLACKFIN_IP_PHONE.
2012-02-14 Alteradas as definições de botões do adp5588.
2012-02-15 - Criados os eventos associados a todos os botões. - Para teste, foram escritas as funções fsm_st_idle e fsm_st_menu. - Escrito o código de integração entre o driver do adp5588 e a aplicação. - Escri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
2012-02-15 Feitas pequenas alterações para estudo do driver do adp5588 antes da integração com a aplicação.
2012-02-17 Feita uma pequena alteração no laço que permitirá a execução de instruções relacionadas a um estado sempre que houver mudança de estado. Isso é feito através da comparação entre o estado atual e o an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
2012-02-24 - Alterada a condição de execução da máquina de estados após a criação do evento FSM_EVNT_QUEUE_IS_EMPTY. - Excluído o protótipo comentado de uma função que não será implementada em expander.c. - Con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
2012-02-29 comitados os arquivos do linphone que foram alterados
2012-05-09 Excluidos os artefatos do bootloader. Serão comitados apenas os artefatos relevantes, considerando a árvore de diretórios conveniente.
    [imximage.cfg, kwbimage.cfg]
2012-05-31 A memória S25FL032P (4 MB) foi alterada para a memória S25FL064P (8 MB).
2012-06-04 Alterado "queue_t" por "main_queue_t" para evitar conflitos com a implementação de fila utilizada pelo Linphone.
2012-06-04 alterado para suportar integração com a lib ipphone
2012-06-04 inclusão das funções de inserçao de eventos na fila
2012-06-04 alteração para suporte da lib ipphone
2012-06-18 alteração das funções de autenticação
2012-06-18 Alteração em edit_screen_move_cursor: - troca do tipo de dado de 'int' para 'Position'
2012-06-26 campo stacksize alterado para 0x90000
2012-06-27 - Escritos os estados fsm_st_contacts_list e fsm_st_contact_delete. - Concluída a escrita do estado fsm_st_contact_add. - Iniciada a escrita do estado fsm_st_call_status (o código que está comentado).
2012-07-03 - Concluída a integração do Linphone para chamadas de saída (em fsm.c). - Criado o evento FSM_EVNT_LINPHONE_CALL_FAIL (em fsm.h). - Integrados os eventos do Linphone com a aplicação através das strin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
2012-07-04 criação das funções para suporte a edição de campos
2012-07-05 correção de bug em "fsm_st_dialing"
2012-07-06 - Criado o evento FSM_EVNT_CALL_IN_CONNECTED. - fsm_st_idle: suporte a apresentação de data e hora na tela de repouso. - fsm_st_call_status: suporte a apresentação do tempo de chamada para ligações r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
2012-07-09 Criada a função print_sublist_call_logs.
2012-07-09 suporte a busca de contatos
2012-07-09 Feitas alterações para validar os estados relacionados a call log.
2012-07-10 Concluída a implementação e teste das funções de call log.
2012-07-10 Associadas a máquina de estados as funções relacionadas ao estado fsm_st_menu_settings.
2012-07-10 Alterado o menu de configurações.
2012-07-11 salvo o password na estrutura de autenticação(fsm_st_settings_account)
2012-07-11 Salvos o número do telefone e o servidor SIP após alteração da configuração de conta (fsm_st_settings_account).
2012-07-12 criação de funções para suporte dos estados "fsm_st_settings_network" e "fsm_st_network_static"
2012-07-13 - Alterada a ordem de chamada das funções de init na main. - Alterada a função fsm_st_idle para apresentação do nome do usuário na tela inicial.
2012-07-13 Alterado o estado fsm_st_idle para apresentação do ramal na tela de repouso.
2012-07-13 Incluido o evento de incoming call em todos os estados.
2012-07-19 alterações para suportar o novo estado "FSM_ST_CALL_LOGS_VIEW"
2012-07-19 - alterações para suportar o novo estado "FSM_ST_CALL_LOGS_VIEW" - modificação para que o proxy_default seja armazenado
2012-09-19 Alteradas as configurações de particionamento e tamanho da flash.
2012-09-28 Feitas alterações para conseguir gravar informações na memória flash.
2012-10-01 Inseridos comandos para montagem da memória flash e sdcard.
2012-10-02 Alterados os paths para os arquivos de log, lista de contatos, e informaçĩoes de configuração.
2012-10-02 Inserido a lista de servidores NTP.
2012-10-02 Feitas alterações para conseguir gravar informações no sdcard.
2012-10-09 Criada a pasta para inclusão das imagens que estarão na página do projeto.
2012-10-11 Foram feitas alterções para suporte ao servidor STUN.
2012-12-03 Relatório de fw em desenvolvimento.
2012-12-03 revisão do relatório de firmware
2012-12-04 atualizado o relatório de fw e inserido no repositório o artigo do SBrT.
