julioamerico/blackfin-ip-phone-hw/(notices)

Notices in the files:
implementação/fw/bootloader/u-boot-2010.06-2010R1-RC2/drivers/mtd/spi/spansion.c:
modify it under the terms of the GNU General Public License as
published by the Free Software Foundation; either version 2 of
the License, or (at your option) any later version.
